bvrny/Vortex/SIM-VORTEX-01A/LM5013_12V_3.5A_AsyncBuck.pdf

## WEBENCH ® Design Report

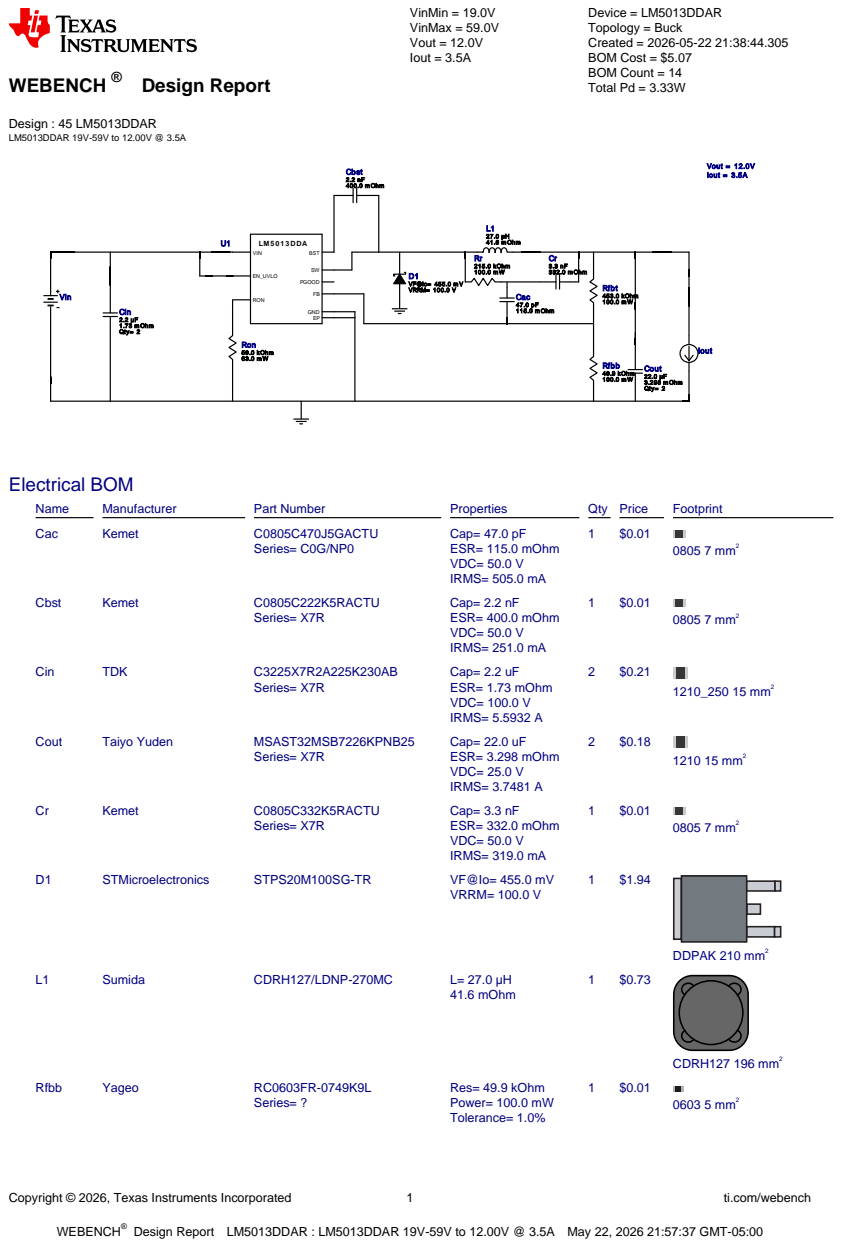
[picture p3: page 1]
Copyright © 2026, Texas Instruments Incorporated; ti.com/webench; WEBENCH®; Design : 45 LM5013DDAR LM5013DDAR 19V-59V to 12.00V @ 3.5A; VinMin = 19.0V VinMax = 59.0V Vout = 12.0V Iout = 3.5A; Device = LM5013DDAR Topology = Buck Created = 2026-05-22 21:38:44.305 BOM Cost = $5.07 BOM Count = 14 Total Pd = 3.33W; LM 5 0 1 3 DDA; GND; VIN; EN_UVLO; RON; PGOOD; BST; Cac 47.0 pF 115.0 m Ohm; Rr 215.0 kOhm 100.0 m W; Cr 3.3 nF 332.0 m Ohm; Cout 22.0 µF 3.298 m Ohm Qty= 2; L1 27.0 µH 41.6 m Ohm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

Design Report LM5013DDAR : LM5013DDAR 19V-59V to 12.00V @ 3.5A May 22, 2026 21:57:37 GMT-05:00

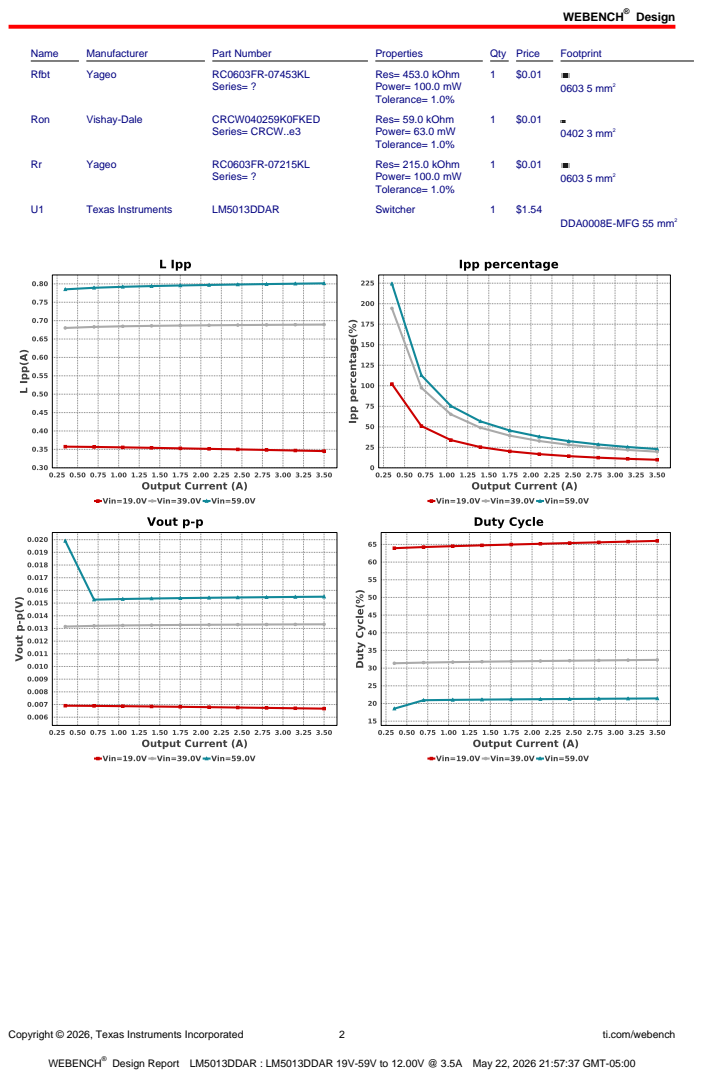
[picture p4: page 2]
Design; Copyright © 2026, Texas Instruments Incorporated; ti.com/webench; Name; Manufacturer; Part Number; Properties; Qty Price; Footprint; Rfbt; Yageo; Series= ?; Res= 453.0 kOhm Power= 100.0 mW Tolerance= 1.0%; 0603 5 mm²; Ron; Vishay-Dale; CRCW040259K0FKED; Series= CRCW..e3; Res= 59.0 kOhm Power= 63.0 mW Tolerance= 1.0%; 0402 3 mm²; Res= 215.0 kOhm Power= 100.0 mW Tolerance= 1.0%; Texas Instruments; LM5013DDAR; Switcher; DDA0008E-MFG 55 mm²

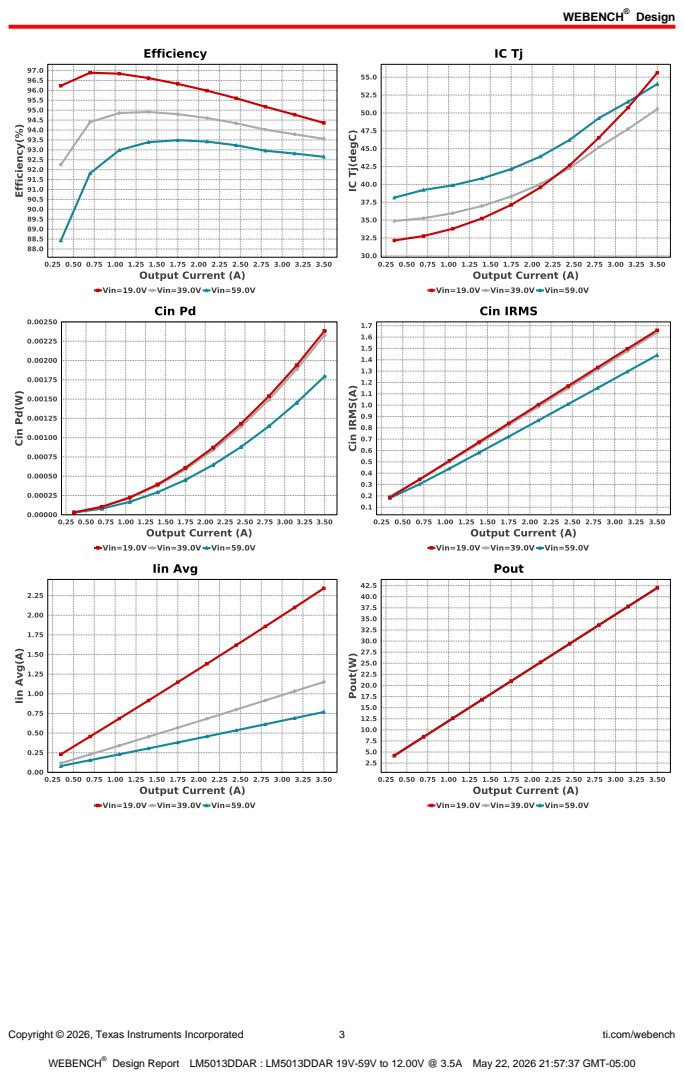
[picture p5: page 3]
Copyright © 2026, Texas Instruments Incorporated; ti.com/webench

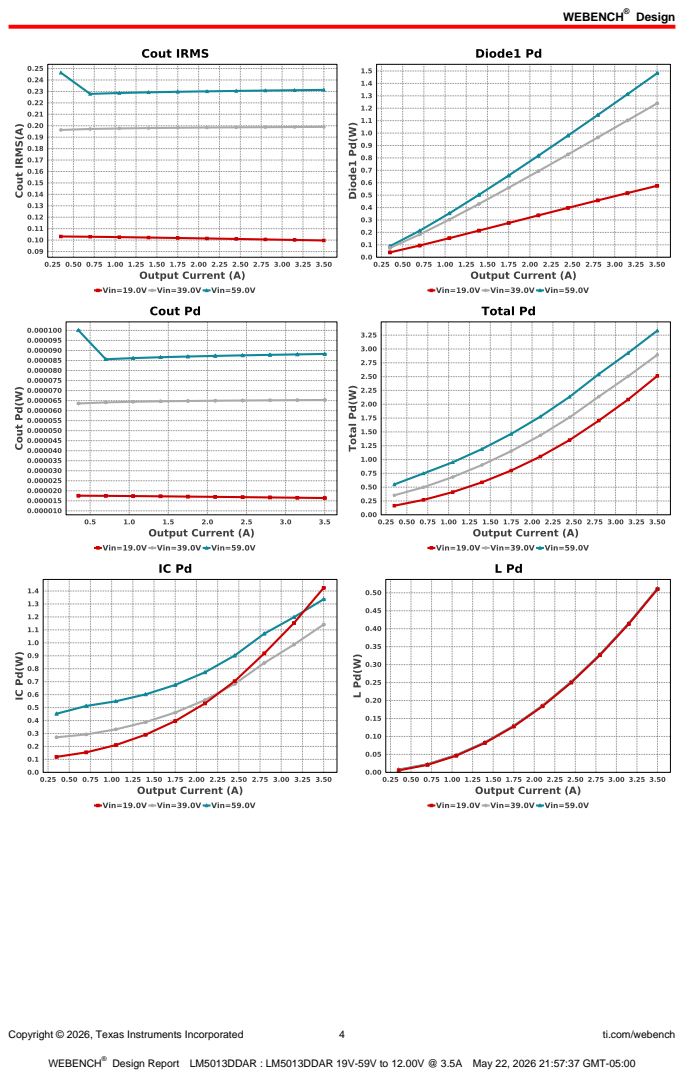
[picture p6: page 4]
Copyright © 2026, Texas Instruments Incorporated; ti.com/webench

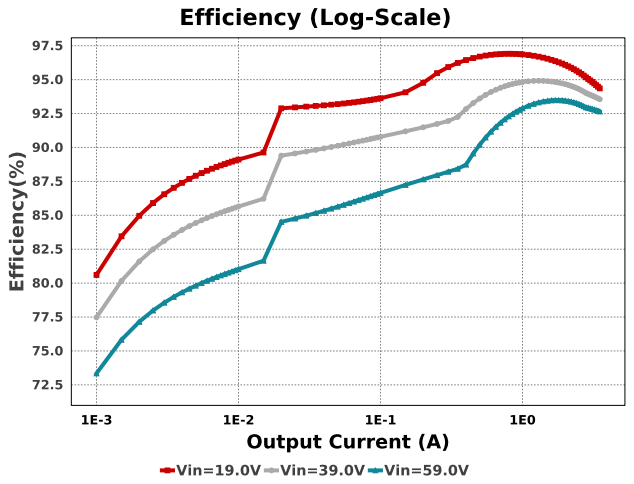
[picture p7: figure]

Copyright © 2026, Texas Instruments Incorporated | 5 | ti.com/webench

## Operating Values

# | Name | Value | Category | Description

1. BOM Count | 14 | Total Design BOM count
2. Total BOM | $5.066 | Total BOM Cost
3. Cin IRMS | 1.44 A | Capacitor | Input capacitor RMS ripple current
4. Cin Pd | 1.794 mW | Capacitor | Input capacitor power dissipation
5. Cout IRMS | 231.352 mA | Capacitor | Output capacitor RMS ripple current
6. Cout Pd | 88.26 µW | Capacitor | Output capacitor power dissipation
7. Diode1 Pd | 1.482 W | Diode | Diode1 power dissipation
8. IC Pd | 1.336 W | IC | IC power dissipation
9. IC Tj | 54.055 degC | IC | IC junction temperature
10. IC Tolerance | 19.0 mV | IC | IC Feedback Tolerance
11. ICThetaJA | 18.0 degC/W | IC | IC junction-to-ambient thermal resistance
12. Iin Avg | 768.34 mA | IC | Average input current
13. Ipp percentage | 22.898 % | Inductor | Inductor ripple current percentage (with respect to average inductor
| | | | current)
14. L Ipp | 801.425 mA | Inductor | Peak-to-peak inductor ripple current
15. L Pd | 511.83 mW | Inductor | Inductor power dissipation
16. Cin Pd | 1.794 mW | Power | Input capacitor power dissipation
17. Cout Pd | 88.26 µW | Power | Output capacitor power dissipation
18. Diode1 Pd | 1.482 W | Power | Diode1 power dissipation
19. IC Pd | 1.336 W | Power | IC power dissipation
20. L Pd | 511.83 mW | Power | Inductor power dissipation
21. Total Pd | 3.332 W | Power | Total Power Dissipation
22. Duty Cycle | 21.43 % | System
| | | Information | Duty cycle
23. Efficiency | 92.65 % | System
| | | Information | Steady state efficiency
24. FootPrint | 557.0 mm² | System
| | | Information | Total Foot Print Area of BOM components
25. Frequency | 460.575 kHz | System
| | | Information | Switching frequency
26. Iout | 3.5 A | System
| | | Information | Iout operating point
27. Mode | CCM | System
| | | Information | Conduction Mode
28. Pout | 42.0 W | System
| | | Information | Total output power
29. Vin | 59.0 V | System
| | | Information | Vin operating point
30. Vout | 12.0 V | System
| | | Information | Operational Output Voltage
31. Vout Actual | 12.094 V | System
| | | Information | Vout Actual calculated based on selected voltage divider resistors
32. Vout Tolerance | 3.432 % | System
| | | Information | Vout Tolerance based on IC Tolerance (no load) and voltage divider resistors if applicable
33. Vout p-p | 15.503 mV | System
| | | Information | Peak-to-peak output ripple voltage

## Design Inputs

Name | Value | Description
Iout | 3.5 | Maximum Output Current
VinMax | 59.0 | Maximum input voltage

Copyright © 2026, Texas Instruments Incorporated | 6 | ti.com/webench
Name | Value | Description
VinMin | 19.0 | Minimum input voltage
Vout | 12.0 | Output Voltage
base_pn | LM5013 | Base Product Number
source | DC | Input Source Type
Ta | 30.0 | Ambient temperature
UserFsw | 500.0 k | Customer Selected Frequency


Copyright © 2026, Texas Instruments Incorporated | 7 | ti.com/webench

## Assembly

## Component Testing

Some published data on components in datasheets such as Capacitor ESR and Inductor DC resistance is based on conservative values that will guarantee that the components always exceed the specification. For design purposes it is usually better to work with typical values. Since this data is not always available it is a good practice to measure the Capacitance and ESR values of Cin and Cout, and the inductance and DC resistance of L1 before assembly of the board. Any large discrepancies in values should be electrically simulated in WEBENCH to check for instabilities and thermally simulated in WebTHERM to make sure critical temperatures are not exceeded.

## Soldering Component to Board

If board assembly is done in house it is best to tack down one terminal of a component on the board then solder the other terminal. For surface mount parts with large tabs, such as the DPAK, the tab on the back of the package should be pre-tinned with solder, then tacked into place by one of the pins. To solder the tab town to the board place the iron down on the board while resting against the tab, heating both surfaces simultaneously. Apply light pressure to the top of the plastic case until the solder flows around the part and the part is flush with the PCB. If the solder is not flowing around the board you may need a higher wattage iron (generally 25W to 30W is enough).

## Initial Startup of Circuit

It is best to initially power up the board by setting the input supply voltage to the lowest operating input voltage 19.0V and set the input supply's current limit to zero. With the input supply off connect up the input supply to Vin and GND. Connect a digital volt meter and a load if needed to set the minimum Iout of the design from Vout and GND. Turn on the input supply and slowly turn up the current limit on the input supply.
If the voltage starts to rise on the input supply continue increasing the input supply current limit while watching the output voltage. If the current increases on the input supply, but the voltage remains near zero, then there may be a short or a component misplaced on the board. Power down the board and visually inspect for solder bridges and recheck the diode and capacitor polarities. Once the power supply circuit is operational then more extensive testing may include full load testing, transient load and line tests to compare with simulation results.

## Load Testing

The setup is the same as the initial startup, except that an additional digital voltmeter is connected between Vin and GND, a load is connected between Vout and GND and a current meter is connected in series between Vout and the load. The load must be able to handle at least rated output power + 50% ( 7.5 watts for this design). Ideally the load is supplied in the form of a variable load test unit. It can also be done in the form of suitably large power resistors. When using an oscilloscope to measure waveforms on the prototype board, the ground leads of the oscilloscope probes should be as short as possible and the area of the loop formed by the ground lead should be kept to a minimum. This will help reduce ground lead inductance and eliminate EMI noise that is not actually present in the circuit.

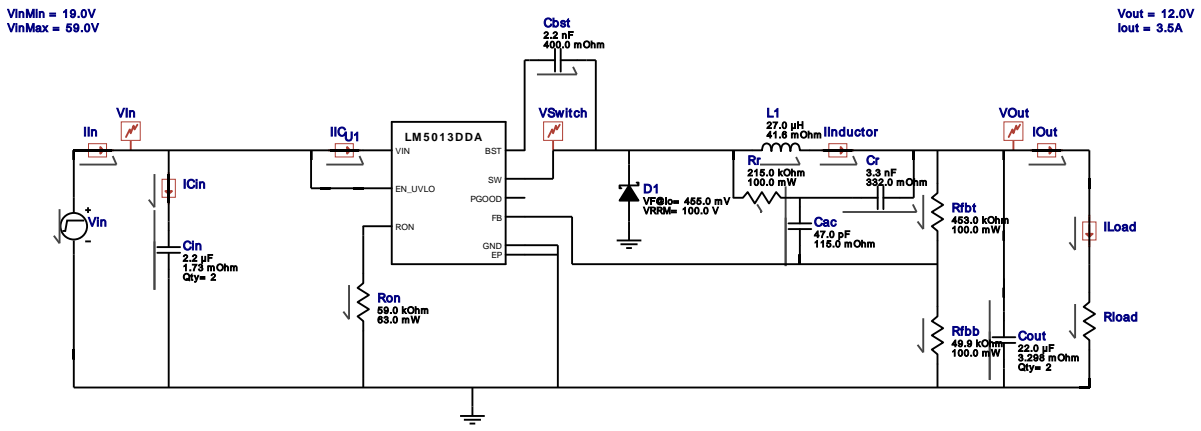
[picture p9: figure]
IOut LM 5 0 1 3 DDA; GND; VIN; EN_UVLO; RON; PGOOD; BST; Cac 47.0 pF 115.0 m Ohm; Rr 215.0 kOhm 100.0 m W; Cr 3.3 nF 332.0 m Ohm; VSwitch; Cout 22.0 µF 3.298 m Ohm Qty= 2; 27.0 µH IIn; 41.6 m Ohm; Vout = 12.0V Iout = 3.5A; VOut; D1 VF@Io= 455.0 m V VRRM= 100.0 V; IIC; IInductor; Ron 59.0 kOhm 63.0 m W; Rfbt 453.0 kOhm 100.0 m W; VinMin = 19.0V VinMax = 59.0V; VIn; Rfbb 49.9 kOhm 100.0 m W; Cbst 2.2 nF 400.0 m Ohm; ICin; Cin 2.2 µF 1.73 m Ohm Qty= 2; ILoad; Rload; Vin

Copyright © 2026, Texas Instruments Incorporated | 8 | ti.com/webench

## WEBENCH® Electrical Simulation Report

Design Id = 45
sim_id = 5
Simulation Type = Startup

## Simulation Parameters

# Name Parameter Name | Description | Values

1. Rload R | Load Resistance | 3.4285714285714284 ohm

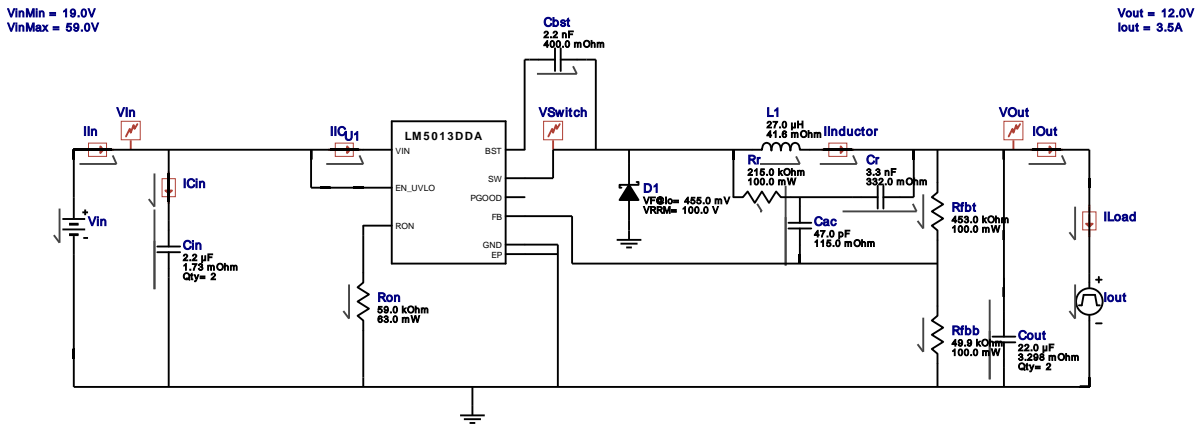
[picture p10: figure]
IOut LM 5 0 1 3 DDA; GND; VIN; EN_UVLO; RON; PGOOD; BST; Cac 47.0 pF 115.0 m Ohm; Rr 215.0 kOhm 100.0 m W; Cr 3.3 nF 332.0 m Ohm; VSwitch; Cout 22.0 µF 3.298 m Ohm Qty= 2; 27.0 µH IIn; 41.6 m Ohm; Vout = 12.0V Iout = 3.5A; VOut; D1 VF@Io= 455.0 m V VRRM= 100.0 V; IIC; IInductor; Ron 59.0 kOhm 63.0 m W; Rfbt 453.0 kOhm 100.0 m W; VinMin = 19.0V VinMax = 59.0V; VIn; Rfbb 49.9 kOhm 100.0 m W; Cbst 2.2 nF 400.0 m Ohm; ICin; Cin 2.2 µF 1.73 m Ohm Qty= 2; ILoad; Iout; Vin

Copyright © 2026, Texas Instruments Incorporated | 9 | ti.com/webench

Design Id = 45
sim_id = 6
Simulation Type = Load Transient

## Simulation Parameters

# Name Parameter Name | Description | Values

1. Iout | signal_type | Signal Type | PULSE
| I1 | Initial Load Current | 3.5 A
| I2 | Minimum Load Current | 0.35 A
| Td | Initial Time Delay | 200u s
| Tf | Fall Time | 10u s
| Tr | Rise Time | 10u s
| Pw | Pulse Width | 500u s

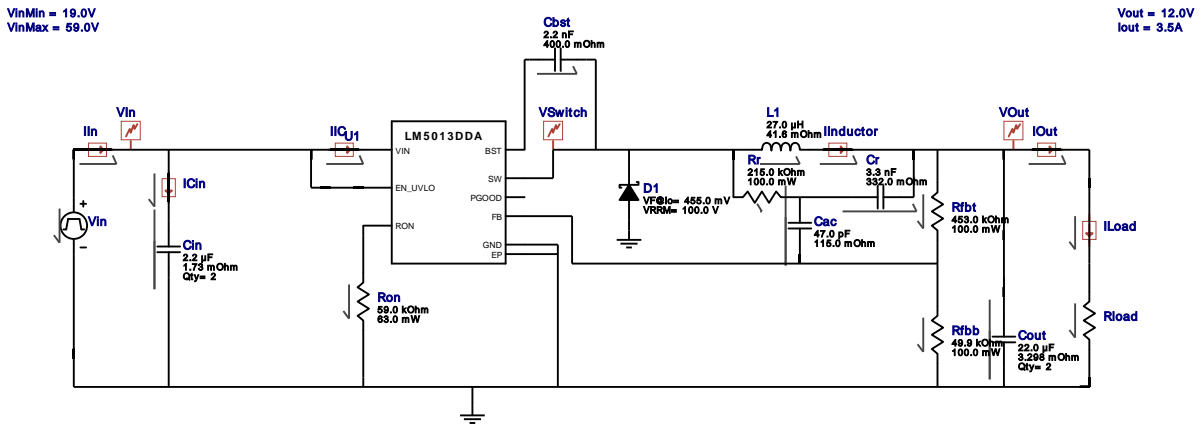
[picture p11: figure]
IOut LM 5 0 1 3 DDA; GND; VIN; EN_UVLO; RON; PGOOD; BST; Cac 47.0 pF 115.0 m Ohm; Rr 215.0 kOhm 100.0 m W; Cr 3.3 nF 332.0 m Ohm; VSwitch; Cout 22.0 µF 3.298 m Ohm Qty= 2; 27.0 µH IIn; 41.6 m Ohm; Vout = 12.0V Iout = 3.5A; VOut; D1 VF@Io= 455.0 m V VRRM= 100.0 V; IIC; IInductor; Ron 59.0 kOhm 63.0 m W; Rfbt 453.0 kOhm 100.0 m W; VinMin = 19.0V VinMax = 59.0V; VIn; Rfbb 49.9 kOhm 100.0 m W; Cbst 2.2 nF 400.0 m Ohm; ICin; Cin 2.2 µF 1.73 m Ohm Qty= 2; ILoad; Rload; Vin

Copyright © 2026, Texas Instruments Incorporated | 10 | ti.com/webench

Design Id = 45
sim_id = 7
Simulation Type = Input Transient

## Simulation Parameters

# Name Parameter Name | Description | Values

1. Rload R | Load Resistance | 3.4285714285714284 ohm

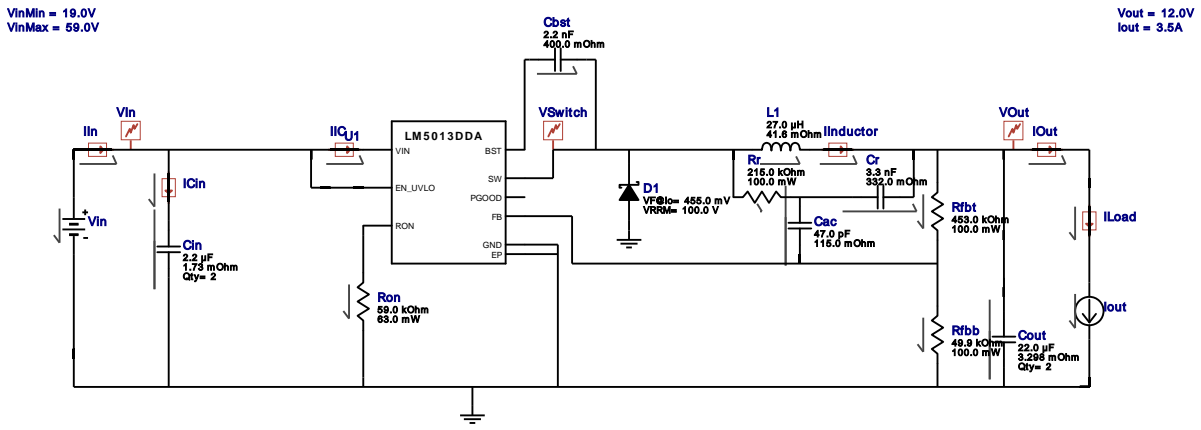
[picture p12: figure]
IOut LM 5 0 1 3 DDA; GND; VIN; EN_UVLO; RON; PGOOD; BST; Cac 47.0 pF 115.0 m Ohm; Rr 215.0 kOhm 100.0 m W; Cr 3.3 nF 332.0 m Ohm; VSwitch; Cout 22.0 µF 3.298 m Ohm Qty= 2; 27.0 µH IIn; 41.6 m Ohm; Vout = 12.0V Iout = 3.5A; VOut; D1 VF@Io= 455.0 m V VRRM= 100.0 V; IIC; IInductor; Ron 59.0 kOhm 63.0 m W; Rfbt 453.0 kOhm 100.0 m W; VinMin = 19.0V VinMax = 59.0V; VIn; Rfbb 49.9 kOhm 100.0 m W; Cbst 2.2 nF 400.0 m Ohm; ICin; Cin 2.2 µF 1.73 m Ohm Qty= 2; ILoad; Iout; Vin

Copyright © 2026, Texas Instruments Incorporated | 11 | ti.com/webench

Design Id = 45
sim_id = 8
Simulation Type = Steady State

## Simulation Parameters

# Name Parameter Name | Description | Values

1. Iout | I | Load current | 3.5 A

## Design Assistance

1. Master key : 570D1EC6A0589950192A1BDB29CCB0EA[v1]
2. LM5013 Product Folder : http://www.ti.com/product/LM5013 : contains the data sheet and other resources.

Important Notice and Disclaimer

TI provides technical and reliability data (including datasheets), design resources (including reference designs), application or other design advice, web tools, safety information, and other resources AS IS and with all faults, and disclaims all warranties. These resources are intended for skilled developers designing with TI products. You are solely responsible for (1) selecting the appropriate TI products for your application, (2) designing, validating and testing your application, and (3) ensuring your application meets applicable standards, and any other safety, security, or other requirements.

These resources are subject to change without notice. TI grants you permission to use these resources only for development of an application that uses the TI products described in the resource. Other reproduction and display of these resources is prohibited. No license is granted to any other TI intellectual property right or to any third party intellectual property right. TI disclaims responsibility for, and you will fully indemnify TI and its representatives against, any claims, damages, costs, losses, and liabilities arising out of your use of these resources.

Providing these resources does not expand or otherwise alter TI's applicable Terms of Sale or other applicable terms available either on ti.com or provided in conjunction with TI products.
