bvrny/Vortex/DOCS-VORTEX-01A/Bldc_inverter_combined_mk/BLDC_inverter_combined_MK.pdf

ИЗВЕШТАЈ ЗА ДИЗАЈН НА ТРИФАЗЕН BLDC/PMSM ИНВЕРТОР | 1

# Дизајн на трифазен инвертор со N-канални MOSFET транзистори за BLDC/PMSM мотор од 3–5 kW, напојуван од 24-V/48-V батерии (20–60 V): енергетски степен, управување на гејтот и аналоген влезен степен со векторско управување (FOC)

Извештај за хардверски дизајн
Целен контролер: STMicroelectronics STM32G473RCT6 | Енергетски степен: Infineon IPT015N10N5 (100 V, 1.5 mΩ), ×2
паралелно по позиција | Драјвер: Texas Instruments UCC27211A-Q1
Склопна фреквенција 40 kHz | Управување на гејтот: 12 V | Струен засилувач: TI INA240A2 | Набавка: LCSC
| Electronics
I. Вовед и опсег
Ц

елниот систем е неизолиран трифазен напонски инвертор со заедничко заземјување (common-ground), наменет да управува со произволен трифазен безчеткест еднонасочен или синхрон мотор со перманентни магнети (BLDC/PMSM), под сензорско управување (Hall или квадратурен енкодер) или безсензорско, базирано на повратна електромоторна сила (back-EMF), со целосно векторско управување (FOC). Системот се напојува од батерија со променлив напон: пакет од 24 V (опсег 20–30 V), кој дава околу 3 kW, или пакет од 48 V (опсег 40–60 V), кој дава до 5 kW. Промената на напонот на батеријата е суштинска за дизајнот: највисокиот напон (60 V) ги одредува напрезите на блокирање и брзината на нишање dv/dt, додека најнискиот напон (20 V) ја дава најголемата струја за дадена моќност и оттаму најлошиот случај и за спроводните загуби и за мерењето на струја. Склопната фреквенција е 40 kHz, над границата на човечкиот слух, така што PWM тонот е нечуен. Контролерот е STM32G473RCT6 — motor-control MCU базиран на Arm® Cortex®-M4, кој интегрира пет 12-битни ADC-а, шест операционни засилувачи употребливи во режим со програмабилно засилување (PGA) или како follower, седум аналогни компаратори, три напредни тајмери за управување со мотор и бафер за напонска референца (VREFBUF) [1]. Секоја прекинувачка позиција во енергетскиот степен е составена од два паралелно поврзани Infineon OptiMOS™ 5 IPT015N10N5 транзистори (100 V, 1.5 mΩ, 300 A) [3], [4] — четири уреди по гранка на полумостот, дванаесет вкупно — а секоја гранка ја управува по еден gate driver Texas Instruments UCC27211A-Q1, напојуван од 12 V [2]. Фазната струја се мери со in-line shunt, читан од струен засилувач TI INA240A2 [18].
Извештајот го опфаќа целиот хардверски синџир од батеријата до ADC-то на контролерот и е организиран во следните проектни блокови:
1) избор на енергетскиот MOSFET и проверка на електричната компатибилност со драјверот за целиот опсег на напони на батеријата (Дел IV);
2) колото за управување на гејтот — bootstrap кондензатор и диода, отпорници на гејтот, асиметрична мрежа за вклучување/исклучување, pull-down отпорници и кондензатори за декуплирање (Дел V);
3) ланецот за мерење на фазна струја (in-line shunt + засилувач + ADC интерфејс), за сите три фази (Дел VI);
4) ланците за мерење на напон на DC-сабирницата и на секој од трите фазни јазли (Дел VII);
5) RC snubber паралелно со енергетските прекинувачи (Дел VIII); и
6) стратегијата за шум и филтрирање (Дел IX), консолидирана со целосна спецификација на материјали (Дел X).
За секој блок извештајот (а) го објаснува принципот на работа и потребните компоненти, (б) ги изведува управувачките равенки, (в) пресметува нумерички вредности за тековната спецификација, (г) избира конкретна компонента достапна од дистрибутер и (д) го оправдува изборот. Поглавјето со теоријата на работата (Дел II) ги поставува концептуалните основи — зошто е потребен инвертор за безчеткеста машина, како работат полумостот и bootstrap напојувањето и која е улогата на Miller plateau-то — пред да се премине на пресметките на ниво на компоненти. Две посебни прашања се обработени детално: споредбата на топологиите за мерење на струја што го мотивира in-line изборот (Дел VI-A), и потребата (или непотребата) од op-amp бафер пред ADC (Дел VII-C).
Секоја квантитативна тврдба и секоја проектна равенка е поткрепена со примарен извор — каталошки лист на производителот или призната апликативна белешка — со активни линкови. Дополнително, секоја избрана компонента мора да биде нарачлива од дистрибутерот LCSC Electronics, при што се претпочитаат компоненти со голем обрт за да биде реална нарачка со количини од 500+; LCSC држи на залиха повеќе од 560 000 SKU од 2600+ производители [24]. Бидејќи залихата кај дистрибутерот се менува секојдневно, спецификацијата на материјали во Дел X ја означува единствената специјална компонента (shunt-от со голема моќност) за потврда на залиха при пуштање на нарачката и нуди алтернатива составена од крајно вообичаени компоненти.

II. Теорија на работата
A. Зошто се користи инвертор за погон на BLDC мотор
Безчеткестиот еднонасочен мотор е, и покрај своето име, синхрона машина за наизменична струја: има ротор со траен магнет и трифазна статорска намотка и нема механички комутатор и четки преку кои конвенционалниот еднонасочен мотор ја префрла струјата меѓу намотките додека роторот се врти [5], [6]. Функцијата на комутација што кај четкастиот мотор ја вршат четките механички затоа мора да се изврши електронски. Инверторот е токму колото што го прави тоа: го претвора еднонасочниот напон на сабирницата со фиксен поларитет (овде обезбеден од батерија) во низа контролирани наизменични фазни струи потребни за да се одржи статорското магнетно поле во вртење пред роторот и со тоа да се произведува континуиран вртежен момент [5], [6].
Во трапезоидното (шестчекорно, 120°) управување — најчестата BLDC шема — шесте прекинувачи на инверторот заземаат шест комбинации на вклучено/исклучено, произведувајќи шест дискретни ориентации на статорското поле по електрична револуција; прекинувачите се чекорат низ оваа низа синхроно со роторот, така што вртежниот момент е секогаш позитивен [5]. Положбата на роторот — потребна за да се знае кога да се чекори — се добива или од Hall сензори поставени на 120°, или, безсензорски, од back-EMF (контраелектромоторната сила) на моментно неенергизираната фаза [5], [6]. Во секој момент една фаза се управува позитивно, една негативно, а трета се остава отворена, совпаѓајќи ја правоаголната струја со трапезоидната back-EMF на моторот за ефикасно производство на момент [5]. PWM применет на спроводните прекинувачи го поставува ефективниот напон, а со тоа и работната точка по брзина и момент [6]. Без инвертор нема начин да се комутира безчеткеста машина — токму затоа енергетската електроника, а не четките, го дефинира погонот.
B. Како работи инверторското коло
Енергетскиот степен е трифазен мост: три идентични „гранки“ (полумостови), по една за секоја фаза на моторот, секоја составена од high-side и low-side прекинувач поврзани во серија преку еднонасочната сабирница, со фазата на моторот приклучена на нивната средна точка. Во овој дизајн секој прекинувач е составен од два паралелно поврзани IPT015N10N5 транзистори, па една гранка содржи четири MOSFET-а, а целиот мост дванаесет.
Во рамките на една гранка двата прекинувачи работат комплементарно — никогаш и двата истовремено вклучени, што би ја кратко споило сабирницата (shoot-through). Вклучувањето на high-side прекинувачот ја поврзува фазата со позитивната сабирница; вклучувањето на low-side прекинувачот ја поврзува со масата; оставањето на двата исклучени ѝ дозволува на фазата да лебди (што се користи за неенергизираната фаза и за следење на back-EMF) [5], [6]. Чекорењето на трите гранки низ шестчекорната шема ја циркулира струјата низ парови фази по редоследот што произведува ротирачко статорско поле [5]. За време на dead-time-от меѓу состојбите на прекинувачите, телесните диоди (body diode) на MOSFET-ите — заедно со индуктивноста на моторот — ја обезбедуваат freewheeling патеката за индуктивната фазна струја; телесната диода на

IPT015N10N5 е карактеризирана токму за оваа намена (VSD ≈ 0.85 V, Qrr ≈ 316 nC) [3]. Отпорничкиот карактер на спроводната состојба на MOSFET-от (RDS(on) од само 1.5 mΩ, дополнително преполовена со паралелното поврзување) ги држи спроводните загуби ниски при струите од редот на 100 A [3], [7].

C. Намена на секоја компонента
- Енергетски MOSFET-и (IPT015N10N5, ×2 по позиција): контролираните прекинувачи што ја поврзуваат секоја фаза со сабирниците. Двата паралелно поврзани уреди ја преполовуваат ефективната отпорност во спроводна состојба и ги делат загубата и топлината; нивниот позитивен температурен коефициент на RDS(on)

го прави делењето самостабилизирачко [7].
- Gate driver (UCC27211A-Q1): ја претвора PWM логиката на контролерот во високострујното 12 V управување на гејтот потребно за брзо прекинување на MOSFET-ите, го поместува нивото на high-side сигналот до лебдечкиот јазол на прекинување и спроведува UVLO заштита [2]. Драјверите постојат токму затоа што логичкиот излез (често 3.3 V, ≤ 1 A) не може ниту целосно да спроведе енергетски MOSFET, ниту да ја испорача врвната струја за брзо прекинување, и затоа што гејтот на high-side уредот мора да биде референциран кон јазол што се ниша до напонот на сабирницата [2], [7].
- Bootstrap кондензатор: лебдечкиот резервоар на енергија што го напојува high-side драјверот додека јазолот на прекинување е висок (в. Дел II-D).
- Bootstrap диода (внатрешна): еднонасочен вентил што го надополнува bootstrap кондензаторот од VDD кога јазолот на прекинување е низок и го блокира напонот на сабирницата кога е висок [2], [8].
- Отпорници на гејтот: ја поставуваат и ограничуваат струјата на гејтот, го наштелуваат dv/dt заради EMI и ги пригушуваат и балансираат паралелните гејтови [7].
- Pull-down отпорници гејт–извор: ги држат MOSFET-ите исклучени при вклучување на напојувањето и додаваат имунитет на вклучување од dv/dt [7].
- Кондензатори за декуплирање: ги напојуваат брзите струјни импулси на гејтот локално, така што 12 V сабирницата и преднапонот на драјверот не се рушат при прекинување [2].
- Капацитивност на DC-link: ја вкрутува сабирницата против големата бранувачка струја на полумостот и го ограничува надскокот при комутација во рамки на оценката од 100 V на уредот.
D. Bootstrap колото: работа, потреба и улогата на Miller plateau
a) Зошто полумост само со N-канални транзистори бара bootstrap напојување.: N-каналните MOSFET-и се претпочитаат за полумостот бидејќи, за дадена површина на чипот и напон, имаат многу пониска RDS(on) од P-каналните уреди. Но N-канален MOSFET се вклучува само кога неговиот гејт е неколку волти над неговиот извор. Кај low-side уредот изворот е на маса, па 12 V управување референцирано кон маса работи директно. Кај high-side уредот изворот е јазолот на прекинување, кој се крева до полниот напон на сабирницата кога тој уред е вклучен; за да остане вклучен, гејтот мора да се управува ≈ 12 V над сабирницата — напон што не постои никаде во систем со една сабирница [2], [7]. Bootstrap колото го создава ова лебдечко high-side напојување евтино, користејќи само диода и кондензатор [8].
b) Како работи.: Кога low-side прекинувачот е вклучен, јазолот на прекинување (и пинот HS) се влече кон маса; bootstrap кондензаторот, поврзан меѓу HB и HS, се полни од 12 V сабирницата VDD низ bootstrap диодата до ≈ VDD − VF ≈ 11 V [2], [8]. Кога потоа high-side-от се вклучува, јазолот на прекинување се крева до напонот на сабирницата; bootstrap диодата станува обратно поларизирана (го блокира напонот на сабирницата), а наполнетиот кондензатор „се вози нагоре“ заедно со јазолот на прекинување, држејќи го пинот HB ≈ 11 V над HS и така обезбедувајќи го лебдечкиот преднапон што го држи high-side MOSFET-от целосно спроводен [2], [8]. Кондензаторот повторно се дополнува во секој циклус кога low-side-от следно се вклучува — поради што е потребно минимално време на спроводност на low-side-от (освежување) и поради што Дел V-A мораше да ги провери и опаѓањето и полнењето [8], [9].
c) Каде влегува Miller plateau.: За време на секое вклучување напонот на гејтот расте, паузира на рамното „Miller plateau“ (≈ 4.4 V овде [3]), потоа повторно расте. Паузата настанува бидејќи, штом каналот ја носи полната струја на оптоварување, целата струја за управување на гејтот се пренасочува во празнење на капацитивноста гејт–одвод CGD, така што напонот на одводот може да се ниша; во текот на овој интервал VGS е стегнат и се движи само напонот на одводот [7]. Интервалот на платото (заедно со интервалот од прагот

ТАБЕЛА I
Зададени параметри на дизајнот.
Параметар | Вредност | Образложение / извор
Извор на напојување | Батерии (24 V или 48 V
| пакет) | Напонот варира со состојбата на полнење на батеријата
Напон на DC- сабирницата (DC-link) | 24 V пакет: 20–30 V
| 48 V пакет: 40–60 V | Vbus,max = 60 V (полна 48 V батерија), Vbus,min = 20 V (празна
| | 24 V батерија)
Излезна моќност | ≈ 3 kW (24 V пакет) /
| ≈ 5 kW (48 V пакет) | При номинален напон
Склопна фреквенција, fSW | 40 kHz | Над границата на човечкиот слух (∼ 20 kHz), па PWM тонот е
| | нечуен
Прекинувачки уред | IPT015N10N5, ×2
| паралелно по позиција | 100 V, 1.5 mΩ OptiMOS™ 5, оптимизиран за апликации со голема
| | струја [3], [4]
Gate driver | UCC27211A-Q1, ×1 по
| фаза | 120 V boot, 3.7 A/4.5 A полумостен драјвер со вградена boot
| | диода [2], [10]
Напон за управување на гејтот, VDD | 12 V | Во работниот опсег 8–17 V на уредот [2]

до платото) е токму прозорецот во кој уредот истовремено издржува висок напон и носи висока струја, па тоа е местото каде што се генерира загубата при прекинување [7]. Miller полнежот Qgd што мора да се протурка низ платото е удвоен со паралелното поврзување (овде ≈ 102 nC во најлош случај), а брзината на напонската транзиција ја поставува тоа колку струја драјверот може да втисне во гејтот на нивото на платото — а не неговата врвна струја при полн VDD [7].
d) Зошто се потребни големи изворни и понорни струи.: Анализата на Balogh го истакнува тоа експлицитно: најважната карактеристика на еден gate driver е неговата способност за извор и понор околу напонот на Miller plateau-то (∼ 5 V), бидејќи таа струја одредува колку брзо се одвива напонската транзиција на одводот и оттаму загубата при прекинување [7]. Голема изворна струја (3.7 A) брзо го управува гејтот низ платото при вклучување, рушејќи го VDS за ≈ 28 ns (Дел V-C) и минимизирајќи ја загубата при вклучување [2], [7]. Голема понорна струја (4.5 A) го прави истото при исклучување и, што е клучно, го држи гејтот на исклучениот уред цврсто на маса додека спротивниот прекинувач го ниша споделениот јазол: силниот понор ја надвладува Miller струјата инјектирана низ CGD, спречувајќи dv/dt-индуцирано (Miller) вклучување и резултирачкиот shoot-through [2], [7]. Со два паралелни MOSFET-и со висок Qg по позиција, токму оваа висока струјна способност прави еден канал на драјверот да биде доволен — и затоа TI ја пласира струјата на уредот специфично за „управување на големи енергетски MOSFET-и … низ Miller plateau-то“ [2].

III. Спецификација на дизајнот и работен опсег Зададените параметри на дизајнот се сумирани во Табела I. Хардверот за енергетскиот степен мора да биде димензиониран за најголемата струја што инверторот може да ја носи; истата струја ги одредува вредноста на shunt-от и засилувањето на струјниот засилувач. Бидејќи моторот се напојува од батерија со променлив напон, струите за најлош случај мора да се проценат при најнискиот напон на пакетот, зашто за дадена моќност струјата расте кога напонот опаѓа (I = P/V ).

A. Струја на сабирницата за најлош случај (термичко димензионирање)
Конзервативна граница се добива ако се претпостави дека конверторот сè уште бара номинална моќност и при празна батерија:
- пакет 24 V (празен, 20 V), 3 kW → Ibus,max = 3000/20 = 150 A;
- пакет 48 V (празен, 40 V), 5 kW → Ibus,max = 5000/40 = 125 A.
Меродавната струја за термичко димензионирање затоа е ≈ 150 A (24 V пакет при празна батерија); за споредба, при номинален напон струите се 5000/48 ≈ 104 A и 3000/24 ≈ 125 A. Бидејќи во секоја позиција се поврзани паралелно два уреди, секој MOSFET носи приближно половина од оваа струја, т.е. до ≈ 75 A во

ТАБЕЛА II
Работни точки и резултантна фазна струја од (2) (PF = 0.9).
Напојување / мотор | Vbus (V) | P (kW) Iph (A,rms) | ˆIph (A,врв)
24 V бат., 3 kW | 20 (мин) | 3 | 136.1 | 192.5
24 V бат., 3 kW | 30 (макс) | 3 | 90.7 | 128.3
48 V бат., 5 kW | 40 (мин) | 5 | 113.4 | 160.4
48 V бат., 5 kW | 60 (макс) | 5 | 75.6 | 106.9

најлош случај, што е далеку под континуираната оценка од 2 × 250 A (TC = 100 ◦C) на паралелниот пар [3]. Спроводната загуба по уред во овој најлош случај е P = I

2RDS(on) = 75² × 1.5 mΩ ≈ 8.4 W (моментно, при спроводност), што бара соодветно ладење.

B. Фазна струја за најлош случај (мерење на струја)
Електричната влезна моќност P е еднаква на излезната AC моќност на инверторот поделена со ефикасноста на конверторот η; земањето η → 1 е конзервативната претпоставка (што ја максимизира струјата). За синусоидно модулиран трифазен инвертор со просторно-векторска PWM (SVPWM), максималната амплитуда на основната хармоника на фазниот напон е Vˆ
| ph = Vbus/

√
3, па максималниот RMS фазен напон е

Vph,rms =

Vbus
√
6
. | (1)

Со три фази и фактор на моќност на поместување PF = cos φ, AC моќноста е P = 3 Vph,rms Iph PF. Со замена на (1) и решавање по RMS фазната струја,

Iph =

√
6
3

P

Vbus PF

≈ 0.816

P

Vbus PF

| (2)

која е најголема при минимален напон на сабирницата и минимален фактор на моќност. Равенката (2) ја дава струјата во номиналната работна точка; треба да се забележи дека мотор при ниска брзина и висок вртежен момент може да бара споредлива фазна струја при пониска моќност на сабирницата, па (2) се користи како термичка/континуирана проектна точка, а дополнителна резерва се остава за преодни и stall услови во опсегот на засилувачот (Дел VI-C).
Ограничувачката работна точка е 3 kW при 20 V: I

max

ph ≈ 136 A RMS, ˆI
max
ph ≈ 193 A врв (Табела II). Ова е под номиналната граница од 300 A за пакувањето на IPT015N10N5 [4], што потврдува дека енергетскиот степен е во согласност и со фазната струјна цел. Сите вредности за мерење на струја во Дел VI се однесуваат на оваа работна точка.

IV. Избор и компатибилност на енергетските компоненти
A. Infineon IPT015N10N5 — клучни параметри
IPT015N10N5 е N-канален OptiMOS™ 5 енергетски транзистор во TO-Leadless (PG-HSOF-8, „TOLL“) куќиште, кое Infineon експлицитно го опишува како идеално за прекинување со висока фреквенција и наменето за погони на лесни електрични возила, виљушкари и електрични алати [3], [4]. Параметрите релевантни за овој дизајн се сумирани во Табела III; сите вредности се од каталошкиот лист рев. 2.4, освен ако не е поинаку наведено [3].
Особина што директно го оправдува паралелното поврзување е позитивниот температурен коефициент на

RDS(on)

(околу +0.7 до +1 %/

◦C кај енергетските MOSFET-и): уред што спроведува поголема струја повеќе се загрева, неговата отпорност расте и струјата се прелева кон соседниот уред, така што паралелните MOSFET-и самостојно ги изедначуваат своите струи [7]. Ова е стандардната причина зошто MOSFET-ите — за разлика од биполарните транзистори — се добро прилагодени за паралелна работа [7].

ТАБЕЛА III
Клучни параметри на IPT015N10N5 [3].
Симбол Параметар | Вредност / забелешка
VDS | Напон одвод–извор | 100 V (апсолутен максимум)
RDS(on) | Отпорност во спроводна состојба (VGS = 10 V) | 1.3 mΩ тип. / 1.5 mΩ макс.
ID | Континуирана струја на одвод | 353 A (TC = 25 ◦C); 250 A (TC = 100 ◦C)
VGS(th) | Прагов напон на гејтот | 2.2 / 3.0 / 3.8 V (мин./тип./макс.)
Vplateau | Напон на Miller plateau | 4.4 V тип. (при ID = 100 A)
Ciss | Влезна капацитивност | 12 nF тип. / 16 nF макс.
Coss | Излезна капацитивност | 1.8 nF тип.
Crss | Преносна (reverse-transfer) капацитивност | 80 pF тип. / 140 pF макс.
RG | Внатрешна отпорност на гејтот | 1.4 Ω тип. / 2.1 Ω макс.
Qg | Вкупен полнеж на гејтот (0–10 V) | 169 nC тип. / 211 nC макс.
Qgs | Полнеж гејт–извор | 53 nC
Qgd | Полнеж гејт–одвод (Miller) | 34 nC тип. / 51 nC макс.
gf s | Трансконтуктанса | 140 S мин. / 280 S тип.
VSD | Напон на телесната диода (body diode) | 0.85 V тип. / 1.2 V макс.
VGS,max | Граничен напон гејт–извор | ±20 V

ТАБЕЛА IV
Клучни параметри на UCC27211A-Q1 [2].
Симбол | Параметар | Вредност
VDD | Напојување (работно / апс. макс.) | 8–17 V / 20 V
IO,source / IO,sink | Врвна излезна струја | 3.7 A / 4.5 A
VDDR | UVLO праг на VDD (растечки) | 7.0 V (хистереза 0.5 V)
VHBR | UVLO праг на high-side (HB–HS, растечки) | 6.7 V (хистереза 1.1 V)
VHB | Макс. напон на boot напојувањето | 120 V (HB–HS макс. 20 V)
VHS | Опсег на јазолот на прекинување | −(24 − VDD) V (−12 V при 12 V), до 105 V
| | (препорачано)
VF | Пад на напон на boot диодата | 0.85 V (@100 µA) / 1.05 V (@100 mA) макс.
RD | Динамичка отпорност на boot диодата | 0.55 Ω тип.
tPD | Доцнење на простирање (propagation delay) | 20 ns тип.
tR/tF | Време на пораст/опаѓање (1 nF) | 7.2 ns / 5.5 ns
IHB | Струја на мирување на boot | 0.12 mA макс.
SRHS | Макс. slew rate на HS | 50 V/ns
CHB | Препорачан опсег на boot кондензатор | 0.022–0.1 µF (зависно од полнежот на гејтот)
CV DD | Препорачано декуплирање на VDD | 0.22–4.7 µF
B. Texas Instruments UCC27211A-Q1 — клучни параметри
UCC27211A-Q1 е AEC-Q100 квалификуван 120 V high-side/low-side полумостен gate driver, дизајниран да управува два N-канални MOSFET-и со независни влезови; неговиот лебдечки high-side степен може да работи до 120 V, а 120 V bootstrap диода е интегрирана на чипот, така што надворешна boot диода не е задолжителна [2], [10]. Релевантните параметри, сите од каталошкиот лист SLUSCG0C, се дадени во Табела IV [2].
C. Внатрешна архитектура на UCC27211A-Q1
TI го дели уредот на пет функционални блока: влезни степени, UVLO заштита, поместување на ниво (level shift), boot диода и излезни драјверски степени [2].
- Влезни степени. Независни HI и LI влезови со ≈ 68 kΩ pull-down, ≈ 4 pF влезна капацитивност и TTL-компатибилни прагови (растечки 2.3 V, опаѓачки 1.6 V) со широка хистереза за имунитет на шум; влезовите поднесуваат −10 до +20 V и се независни од VDD, па прифаќаат и логика од микроконтролер и сигнали од аналоген контролер [2].
- UVLO заштита. Посебни монитори на VDD и на лебдечкото VHB − VHS напојување ги принудуваат излезите ниски додека преднапонот не е валиден. Прагот на VDD е 7 V (хистереза 0.5 V), а симетричниот high-side праг е 6.7 V (хистереза 1.1 V), така што high-side-от и low-side-от се исклучуваат заедно [2].
- Поместување на ниво (level shift). Ја преведува командата на high-side влезот, референцирана кон маса, нагоре до лебдечкиот high-side излезен степен референциран кон HS, со тесно (≈ 4 ns типично) усогласување на доцнењето меѓу каналите, за да се избегне временска нерамнотежа во полумостот [2].
- Boot диода. 120 V bootstrap диодата е интегрирана (анода VDD, катода HB), елиминирајќи надворешна диода и освежувајќи го CBOOT во секој циклус кога HS оди ниско [2].
- Излезни степени. Low-side степенот е референциран VDD → VSS, а high-side степенот VHB → VHS; двата обезбедуваат 3.7 A извор / 4.5 A понор со брзи (7.2 ns пораст / 5.5 ns опаѓање во 1 nF) излези со ниска импеданса и доцнење на простирање од 20 ns [2].
a) Проектни равенки од каталошкиот лист.: Дисипацијата на драјверот се дели на еднонасочен и прекинувачки дел [2]:
PDISS = PDC + PSW , | PDC = IQ × VDD, | (3)

со IQ < 0.17 mA, па PDC е занемарлив [2]. Прекинувачкиот дел се изведува од енергијата за полнење на гејтот, претставена како еквивалентен кондензатор [2]:

EG =

1
2 CLOAD V

2
DD, | PG = CLOAD V
| 2
| DD fSW = QG VDD fSW , | (4)

каде што гејтот на MOSFET-от е претставен преку неговиот полнеж низ QG = CLOAD VDD [2]. Половина од PG се дисипира при вклучување, а половина при исклучување; со надворешни отпорници на гејтот оваа загуба се дели меѓу драјверот и отпорниците [2]. Истиот израз се појавува кај Balogh како загуба за управување на гејтот, PGAT E = VDRV QG fDRV , чиј член QGfDRV е просечната струја на преднапон на гејтот [7]. За овој дизајн, моќноста за управување на гејтот по драјвер (двата прекинувачи на една гранка, 12 V, 40 kHz, ≈ 465 nC секој) е приближно

PG ≈ 2 × Qg,поз VDD fSW = 2 × 465 nC × 12 V × 40 kHz ≈ 0.45 W по драјвер, | (5)

поделена меѓу драјверот и осумте отпорници на гејтот на гранката — удобно во рамки на дисипацијата на SO-PowerPAD куќиштето кога е изведено според упатствата на TI (драјвер близу MOSFET-ите, декуплирање директно кај пиновите, тесни кола на гејтот) [2]. Барањето за врвна струја е сопствениот проектен критериум на каталошкиот лист: драјверот мора да го испорача Miller полнежот во рамки на целното време на транзиција, IP EAK = QGD/dt, и способноста од 3.7 A е проверена наспроти ова во Дел V-C [2].

D. Заклучок за компатибилноста
Табела V ги сумира проверките на компатибилноста за целиот опсег на напони на батериите.
Спрегата е електрично исправна за целиот опсег на напони на батериите. При највисокиот напон на сабирницата (60 V при полна 48 V батерија) 100 V класата дава DC маргина од ≈ 1.67× и околу 40 V резерва за надскокот на VDS при исклучување предизвикан од L · di/dt; ова е поудобно отколку што изгледа, но го прави управувањето на брзината на исклучување (преку асиметричната мрежа на отпорници во Дел V-D) уште поважно отколку на фиксна 48 V сабирница. Единствената точка што бара квантитативна проверка — бидејќи дизајнот паралелно поврза два MOSFET-и со висок Qg по прекинувач — е дали еден канал на UCC27211A-Q1 може доволно брзо да го наполни и испразни удвоениот полнеж на гејтот. Ова е разгледано во Дел V-C и во димензионирањето на bootstrap-от во Дел V-A и е причината зошто стандардниот 0.1 µF bootstrap кондензатор препорачан во каталошкиот лист мора да се преиспита за оваа оптоварувачка состојба.
V. Дизајн на колото за управување на гејтот Низ целиот овој дел, полнежот на гејтот за една прекинувачка позиција е двојно поголем од оној на еден уред, бидејќи се поврзани паралелно два MOSFET-и:
Qg,поз = 2 × Qg = 2 × 211 nC = 422 nC (најлош случај, до 10 V) [3]. | (6)

ТАБЕЛА V
Проверка на компатибилноста на компонентите.
Проверка | Барање | Овој дизајн | Исход
Напон на блокирање | VDS ≫ Vbus,max вкл. ringing | 100 V наспроти 60 V; ≈ 1.67×
| | DC маргина | Поминува
| | | — ≈ 40 V
| | | резерва за
| | | надскок при
| | | исклучување [3]
Напон на high-side напојувањето | VHB > Vbus,max | 120 V boot, 105 V препорачано
| | HS, наспроти 60 V | Поминува [2]
Ниво на управување на гејтот | VGS,max > VDD ≥ полна
| спроводливост | ±20 V граница, управуван на
| | 12 V | Поминува [3],
| | | [2]
UVLO | VDD > UVLO | 12 V наспроти 7 V (VDD), 6.7 V
| | (HB) | Поминува [2]
Негативно ringing на јазолот | HS поднесува потсек | −12 V преодна способност при
| | VDD = 12 V | Поминува [2]
Струен капацитет | ID ≫ струја на гранката | 2 × 250 A (100 °C) наспроти
| | ≈ 75 A (најлош случај при
| | Vbus,min = 20 V) | Поминува [3]

Сила на управување наспроти
полнеж

Доволна струја низ Miller
plateau за паралелниот полнеж
в. Дел V-C | Поминува

Бидејќи гејтот се управува до 12 V наместо до 10 V (при кои е специфициран Qg), и бидејќи кривата на полнежот е речиси рамна над ∼ 7 V (па дополнителниот полнеж од 10 до 12 V е претежно линеарниот член CGS), се додава резерва од ≈ 10 %. Дополнително, Qg е специфициран при напон одвод–извор од 50 V [3]; при најлошиот напон на сабирницата од 60 V, Miller полнежот Qgd (кој зависи од нишањето на напонот на одводот) е маргинално поголем за неколку nC по уред (бидејќи Crss нагло опаѓа со напонот), но и тоа е опфатено со истата резерва. Резултирачката проектна вредност е

Qg,поз,проект ≈ 465 nC по прекинувачка позиција. | (7)
A. Bootstrap кондензатор
a) Метод.: Bootstrap кондензаторот CBOOT го обезбедува целиот полнеж потребен за вклучување на high-side уредот и за напојување на струјата на мирување на high-side степенот во текот на спроводноста на high-side-от, додека опаѓа за не повеќе од дозволената вредност ∆VBS [8], [11]. Управувачките равенки се
∆VBS ≤ VDD − VF − VGS,min − VDS,on, | (8)

QT OT AL = Qg,поз +

IQBS + ILK

fSW

+ QLS, | CBOOT ≥

QT OT AL

∆VBS

, | (9)

со дополнителна резерва од ∼ 20 % препорачана за толеранции и за опаѓањето на капацитивноста кога диодата е интегрирана [12].
b) Бројки.:
- Пад на boot диодата при релевантната струја на полнење: VF ≈ 0.9 V [2].
- Се бара гејтот на high-side-от да остане целосно спроводен, VGS,min ≈ 10 V; low-side VDS,on ≈ 0.1 V. Тогаш дозволеното опаѓање според (8) е ∆VBS ≤ 12 − 0.9 − 10 − 0.1 = 1.0 V [8]. Се избира конзервативна проектна цел од ∆VBS = 0.5 V, што го задржува лебдечкото напојување на ≈ 10.6 V — далеку над 6.7 V UVLO прагот на HB [2].
- Полнеж од мирување/протекување во текот на најлошото време на спроводност на high-side-от. Со IQBS = 0.12 mA [2], MOSFET IGSS = 2 × 100 nA [3] и висок duty cycle Dmax ≈ 0.95 (па tHS = 0.95/40 kHz =
23.75 µs):
Qleak ≈ (0.12 mA)(23.75 µs) ≈ 2.9 nC ≪ Qg,поз. | (10)

Полнежот на гејтот целосно доминира, па

QT OT AL ≈ 465 nC + 3 nC ≈ 468 nC, | (11)

CBOOT ≥

468 nC
0.5 V
≈ 0.94 µF | . | (12)

Со примена на препорачаната резерва и со отчитување на опаѓањето на капацитивноста при DC-преднапон кај керамичките кондензатори од класа II, избраната вредност е
CBOOT = 2.2 µF, X7R, ≥ 25 V, керамички со ниска ESR, поставен директно меѓу пиновите HB–HS [2], [12].
c) Забелешка за опсегот 0.022–0.1 µF од каталошкиот лист.: Тој опсег е точен за еден MOSFET со ∼ 30–90 nC полнеж на гејтот [2]; овде паралелниот пар бара ≈ 5× повеќе полнеж, што е токму причината зошто каталошкиот лист наведува дека вредноста зависи од полнежот на гејтот на high-side MOSFET-от [2]. Со употреба на 0.1 µF би се добило опаѓање од 468 nC/0.1 µF ≈ 4.7 V по циклус — доволно за недоволно управување или дури за активирање на high-side UVLO. Затоа поголемата вредност од 2.2 µF не е опционална за оваа оптоварувачка состојба.
d) Проверка на полнењето.: Кондензаторот го надополнува само ≈ 468 nC отстранет во секој циклус, а не целиот полнеж. При најлош duty cycle, времето на спроводност на low-side-от е ≈ 1.25 µs; потребната просечна струја на полнење е 468 nC/1.25 µs ≈ 0.37 A, додека интегрираната 0.55 Ω boot диода може почетно да испорача (12 − 0.9)/0.55 ≈ 20 A [2]. Затоа полнењето е удобно при 40 kHz. При многу мала брзина на моторот со duty cycle близу 100 % на high-side-от, прозорецот за надополнување се намалува и може да биде потребен периодичен low-side освежувачки импулс — позната ограниченост на сите bootstrap напојувања [8], [9].
B. Bootstrap диода
UCC27211A-Q1 ја интегрира bootstrap диодата (анода кон VDD, катода кон HB); таа е оценета на 120 V, има типична динамичка отпорност од 0.55 Ω, пад на напон од ≈ 0.9–1.05 V при 100 mA и време на исклучување од 20 ns [2]. За овој дизајн внатрешната диода е соодветна: Дел V-A покажува дека и струјата на полнење и опаѓањето се удобно во рамки на нејзината способност, а нејзината 120 V оценка ја надминува 48 V сабирницата со голема маргина [2].
Опционална надворешна диода паралелно со внатрешната може да се додаде ако проектантот сака дополнително да го намали падот на напон при полнење и опаѓањето по циклус. Ако се користи, мора да задоволи [8], [9]: обратен напон ≥ Vbus + VDD маргина → се избира 100 V компонента за совпаѓање со напонската класа на MOSFET-от; брзо обратно закрепнување (reverse recovery, trr ≤ 50 ns) или Schottky; и струја на спроводност ≥ врвната струја на полнење (≥ 1 A е доволно). Бидејќи функцијата веќе е обезбедена на чипот, оваа компонента е надградба, а не неопходност.
C. Отпорници на гејтот и проверка на врвната струја / Miller
a) Барање за пригушување (Balogh).: Оптималниот надворешен отпорник на гејтот за критично пригушување на резонанцата во колото на гејтот, формирана од индуктивноста на изворот LS и Ciss, е [7]
RGAT E,OP T = 2r
LS

CISS

− (RDRV + RG,I ). | (13)

За куќиштето TOLL со ниска индуктивност (LS од редот на 1 nH) и Ciss = 12 nF, 2

p
| | LS/CISS ≈ 0.58 Ω,
додека излезната импеданса на драјверот плус внатрешната отпорност на гејтот (RDRV + RG,I ) веќе ја надминуваат. Резултатот е негативен, што значи дека колото е веќе прекумерно пригушено само од импедансата на драјверот и внатрешната отпорност на гејтот од 1.4 Ω [7], [3]. Затоа надворешниот отпорник на гејтот се избира не за пригушување, туку за: (i) да ја држи споделената излезна струја на драјверот во рамки на оценката, (ii) да го наштелува dv/dt заради EMI и (iii) да ги избалансира двата паралелни уреди.

b) Поединечни отпорници.: Најдобрата практика за паралелни MOSFET-и е поединечен отпорник на гејтот кај секој гејт (по два по прекинувачка позиција) наместо еден заеднички, така што секоја тенденција двата уреди да осцилираат еден против друг се пригушува и нивното прекинување се балансира. Се избира стандардна вредност
RG,ext = 2.2 Ω (по еден на секој MOSFET, E24),
блиску до 1.8 Ω при кои се карактеризирани времињата на прекинување на IPT015N10N5 [3].
c) Проверка на врвната струја / dv/dt.: Miller plateau е на Vplateau = 4.4 V [3]. Со гејтот задржан на платото, мрежата би барала по уред

IG =

VDD − Vplateau

RG,ext + RG,I

=

12 − 4.4
2.2 + 1.4
| ≈ 2.1 A, | (14)

т.е. ≈ 4.2 A за двата уреди заедно. Ова ја надминува границата на изворната струја на драјверот од 3.7 A [2], па драјверот ја ограничува струјата на 3.7 A и напонот на јазолот опаѓа — драјверот, а не отпорникот, ја одредува брзината. Времето за испорака на комбинираниот Miller полнеж (2 × 51 nC = 102 nC макс.) при 3.7 A е
tM iller = | Qgd,поз
| IO,source = 102 nC 3.7 A
| ≈ 28 ns, | (15)

што дава, на најлошиот случај на сабирницата од 60 V (полна 48 V батерија),

dVDS
dt

≈

| 60 V 28 ns
| ≈ 2.1 V/ns, | (16)

што е умерено (добро за спроведено EMI) и далеку под границата на slew rate од 50 V/ns на пинот HS [2]. Ова го потврдува клучното прашање за компатибилноста: дури и со удвоениот полнеж на гејтот од паралелното поврзување, еден канал на UCC27211A-Q1 го прекинува парот за под 30 ns — токму за што е наменета оценката 3.7 A/4.5 A на уредот, имено „управување на големи енергетски MOSFET-и со минимизирани прекинувачки загуби при преминот низ Miller plateau-то“ [2]. Сепак, единствената вредност од 2.2 Ω изведена овде е само симетрична основа: Дел V-D ја префинува во асиметрична мрежа за вклучување/исклучување, која е конфигурацијата што всушност е усвоена.

D. Асиметрична (поделена) мрежа на отпорници на гејтот
Единствениот отпорник од Дел V-C принудува една вредност да служи за двата фронта на прекинување, што е компромис. Овој дел го заменува со асиметрична мрежа што ги поставува брзините на вклучување и исклучување независно — побавно, помеко вклучување и брзо исклучување со ниска импеданса — која е конфигурацијата усвоена во финалниот дизајн.
a) Топологија.: По MOSFET, секогаш присутниот сериски отпорник Ron ја носи струјата на вклучување (изворна), а гранка од Rof f во серија со OFF диода Dof f се поставува паралелно со него. Dof f е ориентирана со анода кон гејтот и катода кон излезот на драјверот, така што спроведува само кога гејтот се влече надолу (исклучување / dv/dt стегач). Следствено,
Rg(on) = Ron, | Rg(off) = Ron ∥ (Rof f + RD). | (17)

При вклучување Dof f е обратно поларизирана и гејтот гледа само Ron; при исклучување двете патеки спроведуваат и гејтот ја гледа пониската паралелна комбинација [7], [13]. (Со една OFF диода, Ron останува во патеката на исклучување; пониската гранка Rof f едноставно го шунтира, поради што Rg(of f) е паралелна комбинација, а не само Rof f .)
b) Проектна насока — бавно вклучување, брзо исклучување.: За тврдо прекинуван полумост, претпочитаната асиметрија е побавно вклучување, побрзо исклучување [13], [14], [15]. Побрзото вклучување го зголемува di/dt на струјата на одводот, што ја зголемува струјата на обратно закрепнување (reverse recovery) на телесната freewheeling диода на комплементарниот уред; телесната диода на IPT015N10N5 складира Qrr ≈ 316 nC (trr ≈ 103 ns) [3], па намерно омекнатото вклучување го ограничува тој врв на закрепнување, придружната загуба и EMI што таа ги генерира [13], [14]. Спротивно на тоа, исклучувањето има корист од тоа да биде брзо и со ниска импеданса: ги намалува загубите при исклучување и, што е клучно, го држи гејтот на исклучениот уред цврсто кон масата, така што Miller струјата инјектирана низ CGD кога комплементарниот прекинувач го менува јазолот не може да го подигне VGS до прагот и да предизвика лажно (само-)вклучување [14], [15]. 100 V уредот на сабирница до 60 V има доволна напонска резерва (≈ 40 V) да го апсорбира малку повисокиот di/dt надскок при исклучување што го произведува брзото исклучување; токму затоа што таа резерва е помала отколку на фиксна 48 V сабирница, можноста независно да се контролира фронтот на исклучување е уште поценета. Асиметријата ја засилува и сопствената нерамнотежа 4.5 A-понор / 3.7 A-извор на драјверот [2].
c) Избор на вредности.:
- Ron = 3.3 Ω (по MOSFET). Зголемен над компромисот од 2.2 Ω од Дел V-C за да се омекне фронтот на вклучување. Резултирачката струја на вклучување по уред на платото е I = (12 − 4.4)/(Ron + RG,I ) = 7.6/(3.3 + 1.4) = 1.62 A, т.е. ≈ 3.2 A за парот — сега поставена од отпорникот, а не од границата на драјверот од 3.7 A, што дава контролиран dv/dt од 60 V/(102 nC/3.2 A) ≈ 1.9 V/ns во најлош случај [3], [2].
- Rof f = 1.0 Ω (по MOSFET). Со динамичка отпорност на OFF диодата RD ≈ 0.1–0.15 Ω (проценета од спроводната карактеристика на PMEG4030ER, VF ≈ 0.46–0.54 V во релевантниот опсег [13]):
Rg(off) = Ron ∥ (Rof f + RD) = 3.3 ∥ 1.15 ≈ 0.85 Ω. | (18)
Ова дава ефективен однос на отпорност вклучување:исклучување од околу 3.9 : 1.
d) Зошто Rof f не се намалува понатаму.: Внатрешната отпорност на гејтот RG,I = 1.4 Ω е во серија со чипот и не може да се заобиколи [3]. Затоа вкупната отпорност на колото на гејтот при исклучување е RG,I + Rg(off) = 1.4 + 0.85 = 2.25 Ω, и дури и со Rof f = 0 не би можела да падне под ≈ 1.4 Ω. Намалувањето на Rof f под ∼ 1 Ω затоа дава сè помали придобивки, па 1.0 Ω е добро поставен избор. При оваа вредност, врвната струја на исклучување по уред на платото е 4.4/2.25 ≈ 1.96 A (≈ 3.9 A за парот), блиску до границата на понорната струја на драјверот од 4.5 A, што дава транзиција на исклучување од ≈ 26 ns наспроти ≈ 32 ns при вклучување — посакуваната асиметрија [2].
e) Избор на OFF диода.: Dof f мора: (i) да го блокира обратниот напон што се појавува на Ron при вклучување (≈ Ion,peak · Ron ≈ 1.62 A × 3.3 Ω ≈ 5.3 V, плус ringing); (ii) да ја носи струјата на импулсот при исклучување (≈ 2 A врв по гејт); (iii) да закрепнува моментално, така што не додава полнеж на следното вклучување; и (iv) да има ниска динамичка отпорност, така што Rof f доминира во патеката на исклучување. Schottky диода ги задоволува сите четири. Избраната компонента е
Dof f = Nexperia PMEG4030ER — 40 V, 3 A Schottky исправувачка диода со низок VF (VF ≈ 0.46– 0.54 V, IF SM = 50 A, SOD-123W) [13].
Нејзината оценка од 40 V дава > 7× маргина над ∼ 5 V обратен напрег; нејзината оценка од 3 A просечно / 50 A ударно ја надминува струјата на импулсот при исклучување од ∼ 2 A; нејзиниот низок VF и мала спојна капацитивност ја држат патеката на исклучување чиста; а како Schottky има занемарливо обратно закрепнување [13]. Широко достапна алтернатива е 1N5819 (40 V, 1 A Schottky), со прифаќање на нејзиното поголемо куќиште и капацитивност.
f) Снага и куќиште на отпорниците.: Просечната снага дисипирана во отпорникот на гејтот е дел од вкупната загуба за управување на гејтот, PG = Qg VDD fSW [7]. По уред, со Qg ≈ 232 nC при 12 V, PG ≈ 232 nC × 12 V × 40 kHz ≈ 0.11 W, поделена подеднакво меѓу вклучувањето и исклучувањето. Уделот што паѓа на надворешниот отпорник е неговата фракција од вкупната отпорност во колото на гејтот [7]; со проценета излезна отпорност на драјверот RHI ≈ 3.2 Ω:

PRon ≈

Ron

RHI + Ron + RG,I

·

1
2QgVDDfSW =

3.3
7.9
× 0.0557 W ≈ 26 mW, | (19)
PRoff ≈ 6 mW (само при исклучување; останатото го носат RHI и RG,I ). | (20)
Двете се далеку под 1/16 W. Сепак, отпорникот гледа кратки струјни врвови (∼ 1.6–2 A), па изборот на куќиште се води од енергијата по импулс и од маргината, а не само од просечната снага: енергијата по транзиција во Ron е ≈ 0.42 ×

1
2QgVDD ≈ 0.6 µJ, занемарливо во споредба со импулсната издржливост на кој било чип-отпорник. Се избира
Ron, Rof f : куќиште 0805, дебелослоен (thick-film), 1/8 W (125 mW), што дава > 4× маргина на просечната снага и солидна импулсна резерва; работниот напон (∼ 12 V) е далеку под напонската оценка на 0805 (∼ 150 V) [7].

ТАБЕЛА VI
Споредба: единствен отпорник наспроти асиметрична мрежа.
Аспект | Единствен RG = 2.2 Ω (Дел V-C) | Асиметрична Ron = 3.3 Ω / Rof f =
| | 1.0 Ω + Dof f
Фронт при вклучување | Среден — принуден компромис | Помек (Rg(on) = 3.3 Ω); dv/dt ≈
| | 1.5 V/ns [3], [2]
Фронт при исклучување | Ист како при вклучување (не може
| да се разликува) | Брз (Rg(of f) ≈ 0.85 Ω надв.); близу
| | полн понор од 4.5 A [2]
Обратно закрепнување на комплем. диода | Врзано за изборот при исклучување | Независно укротено од бавното
| | вклучување [13], [14]
Импеданса на стегачот во исклучена состојба | RG,I + 2.2 = 3.6 Ω | RG,I + 0.85 = 2.25 Ω → повисок праг
| | на dv/dt за самовклучување [14],
| | [15]
Независна оптимизација на фронтовите | Невозможна | Да — целта на мрежата [13]
Загуба при исклучување | Повисока ако RG се зголеми за меко
| вклучување | Пониска (задржано брзо
| | исклучување)
Дополнителни компоненти по MOSFET | — | +1 отпорник, +1 Schottky

Куќиштето 0603 (1/10 W) исто така е електрично доволно; 0805 е претпочитано заради подобро ширење на топлината, импулсна робусност и леснотија на монтажа. (Pull-down отпорникот RGS е димензиониран во Дел V-E.)
g) Зошто асиметричниот пристап е претпочитан.: Со единствен отпорник проектантот се соочува со неизбежен конфликт [13], [14]: мала вредност дава брзо исклучување (ниска загуба, силен стегач), но и брзо вклучување што го влошува обратното закрепнување на комплементарната телесна диода, dv/dt и EMI; голема вредност го омекнува вклучувањето, но истовремено го забавува исклучувањето, зголемувајќи ја загубата при исклучување и слабеејќи го стегачот на dv/dt што спречува shoot-through. Асиметричната мрежа го раствора овој конфликт со раздвојување на двата фронта [13]. Тоа раздвојување е особено вредно во оваа апликација, бидејќи секоја од трите гранки е тврдо прекинуван полумост во кој секое вклучување комутира freewheeling телесна диода што носи струја од редот на 100 A; бидејќи два паралелни MOSFET-и со висок Qg по прекинувач ја удвојуваат и Miller струјата и цената на секоја вкрстена спроводност; и бидејќи напонската резерва 100 V/48 V му дозволува на дизајнот да искористи брзо исклучување без грижа за надскок. Цената — дванаесет дополнителни отпорници и дванаесет Schottky диоди за целиот инвертор — е занемарлива наспроти добивките во ефикасноста, EMI однесувањето и отпорноста на паразитско вклучување [13], [14], [15]. Поради овие причини, асиметричната мрежа ја заменува основата со единствен отпорник од Дел V-C и е конфигурацијата пренесена во финалниот список на материјали.
E. Pull-down отпорници гејт–извор
Отпорник од гејт кон извор го држи секој MOSFET дефинирано исклучен пред излезите на драјверот да станат активни при вклучување на напојувањето и обезбедува заштита од Miller-индуцирано вклучување при dv/dt [7]. Вредноста на pull-down-от следи од релацијата за имунитет на dv/dt [7]:
dv
dt
LIMIT

=

VT H − 0.007 (TJ − 25)

RG,I CGD

. | (21)

Во нормална работа, ниската излезна импеданса на драјверот и понорот од 4.5 A доминираат во оваа заштита; главната задача на pull-down-от е состојбата при вклучување на напојувањето. Стандардна вредност
RGS = 10 kΩ (по еден на секој MOSFET)
е доволно голема за да не го оптоварува драјверот и доволно мала за да го држи гејтот надолу при вклучување. Проценката со капацитивен делител на индуцираното вклучување ја потврдува маргината: кога спротивниот прекинувач наметнува најлош напон од 60 V на исклучениот уред, најлошиот пораст на гејтот низ делителот

Crss/Ciss = 80 pF/12 nF ≈ 0.0067 би бил ≈ 0.40 V дури и со лебдечки гејт — сè уште далеку под прагот од 2.2 V [3] — а активниот понор од 4.5 A ја држи вистинската вредност уште пониска [2].
a) Снага и куќиште на RGS.: Кога гејтот е управуван на 12 V, RGS непрекинато дисипира P =
V

2

GS/RGS = 12²/10 kΩ = 14.4 mW (просечно помалку, бидејќи гејтот не е секогаш висок). Затоа е доволно куќиште 0603, 1/10 W (100 mW) (> 6× маргина); за единственост на спецификацијата може да се користи и 0805, 1/8 W заедно со отпорниците на гејтот.

F. Кондензатори за декуплирање (decoupling)
a) VDD (low-side) декуплирање.: Секогаш кога LO излезот испорачува струја на гејтот, еднаков струен импулс се влече низ VDD, па керамички кондензатор со ниска ESR мора да стои директно меѓу VDD–VSS [2]. Димензиониран за толерантно бранување ∆V со истиот аргумент за полнеж како кај bootstrap-от,

CV DD ≥

Qg,поз
∆V

=

465 nC
0.5 V
≈ 0.93 µF. | (22)

TI препорачува 0.22–4.7 µF и горниот крај за ниски температури и висок полнеж на гејтот [2]. Избрано: CV DD = 4.7 µF X7R + 0.1 µF керамички, по драјвер, со посебен кондензатор за секој од трите драјвери [2].
b) HB (high-side) декуплирање.: Оваа улога ја извршува самиот bootstrap кондензатор (Дел V-A), поставен директно меѓу пиновите HB–HS; посебната препорака од TI за 0.022–0.1 µF е минималното високофреквентно декуплирање и овде е надмината од пресметаната вредност од 2.2 µF [2].
c) Bulk на 12 V сабирницата.: Споделен bulk резервоар (на пр. 22–47 µF електролитски или керамички) на помошната 12 V сабирница ги напојува трите драјвери и ги апсорбира збирните струјни импулси за управување на гејтот; TI советува посебен VDD кондензатор за декуплирање по драјвер во системи со повеќе драјвери [2].
d) Декуплирање на DC-link.: Бидејќи изворот е батерија поврзана преку сноп кабли, импедансата на изворот (внатрешната отпорност на батеријата плус индуктивноста на снопот) е значителна; затоа локалното DC-link декуплирање е уште поважно отколку кај крута лабораториска сабирница. Енергетскиот степен носи бранувачка струја од редот на 100 A (до ≈ 150 A во најлош случај при празна 24 V батерија) и мора да се декуплира со DC-link банка со ниска ESR/ESL (фолиски и/или керамички) близу полумостот, димензионирана за RMS бранувачката струја и за да го држи надскокот на сабирницата во рамки на оценката од 100 V при комутација. Бидејќи највисокиот напон на батеријата е 60 V, кондензаторите на сабирницата треба да имаат напонска оценка ≥ 80 V (фолиски) или ≥ 100 V (керамички, со отчитување на опаѓањето при DC-преднапон). Прецизното димензионирање зависи од индуктивноста на снопот и е задача на ниво на плоча.
G. Список на компоненти за управување на гејтот (по гранка / по плоча)
Табела VII ги наведува пасивните помошни компоненти за управување на гејтот. Покрај нив, активните уреди се 12× IPT015N10N5 (4 по гранка) и 3× UCC27211A-Q1.

VI. Мерење на фазна струја
A. Преглед и споредба на топологии за мерење на струја
Постојат четири фамилии на мерење на струја кај инвертор; нивниот мерен јазол е прикажан на Сл. 1 за еден half-bridge.
Решавачкиот атрибут за FOC е можноста да се семплира вистинската фазна струја во секој PWM период, независно од работниот циклус. Low-side shunt-от носи фазна струја само додека спроведува low-side уредот, па при висок duty (висока брзина / висока модулација) прозорецот на спроведување се намалува и мерењето станува непрецизно или бара изобличување на PWM (вметнување на минимално време на спроведување) [16]. Единечниот DC-link shunt ги реконструира трите фазни струи од моменталната склопна состојба, но трпи од „ненабљудливи“ области во близина на границите на напонските вектори, каде што времињата на задржување на два активни вектори паѓаат под времето на стабилизирање/blanking на shunt-от, што повторно бара модификација на PWM. In-line (in-phase) shunt-от е поставен на сериска врска со изводот на моторот, па

ТАБЕЛА VII
Список на пасивни помошни компоненти за управување на гејтот.
Ознака | Функција | Вредност | По гранка | 3 гранки
CBOOT | Bootstrap кондензатор (HB–HS) | 2.2 µF X7R ≥ 25 V | 1 | 3
CV DD | Декуплирање на VDD | 4.7 µF X7R + 0.1 µF | 1 сет | 3 сета
Ron | Отпорник за вклучување (по
| MOSFET) | 3.3 Ω, 0805, 1/8 W | 4 (2 HS + 2 LS) | 12
Rof f | Отпорник за исклучување (по
| MOSFET) | 1.0 Ω, 0805, 1/8 W | 4 | 12
Dof f | OFF Schottky диода | Nexperia PMEG4030ER (40 V,
| | 3 A) | 4 | 12
RGS | Pull-down гејт–извор | 10 kΩ, 0603, 1/10 W | 4 | 12
DBOOT (опц.) Надворешна паралелна boot
| диода | 100 V брза/Schottky ≥ 1 A | 0–1 | 0–3
CBULK | Bulk на 12 V сабирница | 22–47 µF | — | 1 (споделен)

Vbus

GND

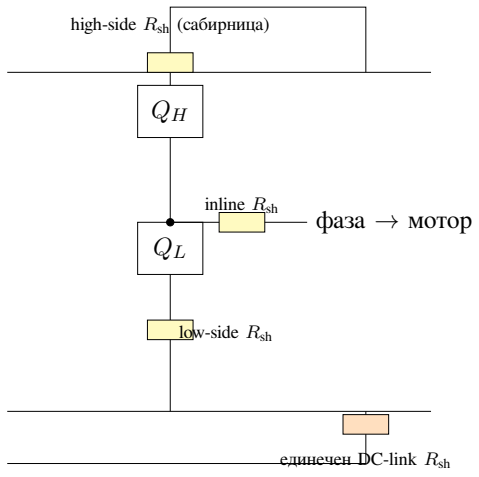
[picture p13: figure]
фаза → мотор; inline Rsh; low-side Rsh; high-side Rsh; (сабирница); единечен DC-link Rsh

Сл. 1. Можни позиции на shunt во една гранка од инверторот: high-side (на сериска врска со гранката од сабирницата), low-side (на сериска врска со гранката кон заземјувањето), in-line (на сериска врска со фазниот спроводник), и единечниот DC-link shunt во заедничкиот повраток. Hall/магнетната алтернатива го заменува shunt-от со сензор на поле околу фазниот спроводник.

ја спроведува фазната струја континуирано и може да се семплира при кој било работен циклус; затоа токму оваа топологија се користи во референтните дизајни за серво и за FOC со високи перформанси [17], [18]. Нејзината единствена тешкотија е тоа што мерниот елемент се наоѓа на јазол што се ниша помеѓу земја и Vbus на fsw со големо dv/dt, па засилувачот мора да комбинира широк common-mode (CM) опсег со силно потиснување на CM преодните појави [18], [17].
Магнетната/Hall алтернатива ја отстранува загубата од вметнување и обезбедува изолација, но по повисока цена и со поголем офсет и термички дрифт отколку ланецот shunt-плус-zero-drift-засилувач; изолацијата не е потребна тука бидејќи дизајнот е експлицитно common-ground. Со оглед на common-ground ограничувањето, потребата за FOC набљудливост при целосен duty на сите три фази, и управливата дисипација во shunt-от изведена подолу, избрана е топологијата in-line shunt, во согласност со спецификацијата и со 48-V in-line FOC референтниот дизајн на TI, TIDA-00913 [17].
B. Димензионирање на shunt отпорникот
Три конкурентни ограничувања ја одредуваат вредноста на shunt-от Rsh: (1) дисипацијата на моќност PRsh =
I

2
phRsh мора да остане во рамки на економичен површински-монтиран елемент; (2) сигналниот напон на полна скала Vˆ

sh = ˆIphRsh мора, по засилувањето, да се вклопи во влезниот прозорец на ADC без отсекување (clipping)

ТАБЕЛА VIII
Споредба на топологии за мерење на струја кај трифазен инвертор.
Атрибут | Low-side shunt | High-side shunt | In-line | (in-phase)
| | | shunt

Магнетна / Hall

Common-
mode | напон
на | мерниот
елемент | Близу до земја (≈0)
На/близу Vbus | Се ниша од шина
до шина на fsw со
високо dv/dt

Галвански изолиран;
сензорот не гледа CM
Ја | мери
вистинската
фазна струја при
сите работни
циклуси
Не | — | само
додека
спроведува
QL; слеп при
≈ 100% duty
Не | — | само
додека
спроведува
QH
Да | —
континуирано,
при кој било duty

Да

Барање | за
засилувач
| Low-CM CSA | High-CM CSA | High-CM CSA со PWM потиснување
— | (сензорот | е
засилувачот)
DC способност | Да | Да | Да | Да (Hall) / Не (CT,
| | | | Rogowski)
Загуба | од
вметнување | I
| 2R во shunt | I
| | 2R во shunt | I
2R во shunt | Занемарлива
Точност / дрифт | Висока / низок | Висока / низок | Висока / низок | Умерена; | офсет | и
термички | дрифт,
нелинеарност
Изолација | Не | Не | Не | Да
Релативна цена | Најниска | Ниска | Ниска–умерена (CSA/фаза) | Највисока
Најпогодна за | 6-step / евтини, ограничен duty опсег | Мониторинг на батерија/полнач | Високи перформанси
FOC | низ
целиот | опсег
| | | на брзина/duty
Многу | високи
струи | или | дизајни
каде изолацијата е
задолжителна

при врвот во најлош случај (со резерва за преоптоварување); и (3) Rsh треба да биде доволно голем за да офсетот и шумот на засилувачот, сведени на струја, останат мали.
За Rsh = 0.1 mΩ при работната точка во најлош случај (I

max
ph = 136 A rms):

PRsh = I

2

phRsh = (136.1)² × 0.1 × 10−3 = 1.85 W, | (23)

Vˆ

sh = ˆIph Rsh = 192.5 × 0.1 × 10−3 = 19.3 mV. | (24)

Отпор од 0.1 mΩ ја држи дисипацијата на 1.85 W, што удобно се справува од страна на shunt од метален елемент (метална лента) со 5 W (резерва од 2.7×), додека 19.3 mV врв е доволно голем за прецизно засилување. Елемент од метална лента е избран поради неговата многу ниска паразитна индуктивност (ESL) и низок температурен коефициент; четири-приклучна (Kelvin) врска е задолжителна за сигналниот напон да се зема само на резистивниот елемент, а не на лемните споеви со голема струја [18]. ESL е важна бидејќи измерениот напон е vsh(t) = Rsh i(t) + ESL di
dt

; на 40 kHz со брзи склопни рабови индуктивниот член мора да биде занемарлив наспроти резистивниот член од 0.1 mΩ, што го постигнува елемент од метална лента со < 2 nH.

C. Избор на струен засилувач и засилување
Засилувачот мора (i) да поднесува CM напон што се ниша од малку под земја (спроведување на body-диода / dead-time, ≈ −1 V) до Vbus = 60 V плус пречекорувањето од ѕвонење; (ii) да го потиснува големото CM dv/dt при секој склопен раб така што излезот да не ѕвони; (iii) да биде двонасочен бидејќи фазната струја е AC;

и (iv) да има пропусен опсег далеку над 40 kHz. Texas Instruments INA240 ги задоволува сите четири: тоа е струен засилувач со напонски излез и zero-drift архитектура, со CM опсег од −4 до +80 V независно од напојувањето, со „enhanced PWM rejection“ експлицитно проектирано да ги потисне CM преодните појави на PWM за погон на мотор, и се нуди во четири фиксни засилувања од 20, 50, 100, 200 V/V [18]. Долната граница од −4 V ја прифаќа екскурзијата под земја, а горната граница од +80 V остава 20 V резерва над сабирницата од 60 V за пречекорувањето од ѕвонење.
При напојување од 3.3 V аналоген извор, двонасочниот излез при нулта струја е центриран од двата референтни приклучоци на INA240, чиј внатрешен разделник ја поставува средната точка на излезот на Vref = (VREF1 + VREF2)/2 [18]; врзувањето на REF1 за земја и REF2 за шината од 3.3 V дава Vref = 1.65 V. Тогаш излезниот напон е
Vout = Vref + G Rsh iph. | (25)

Со rail-to-rail излез, употребливата едностранска амплитуда е ≈ 1.45 V (со резерва од 0.2 V до секоја шина). Со избор на засилување G = 50 (INA240A2), линеарната врвна струја на полна скала е

ˆIFS =

1.45

G Rsh

=

1.45
50 × 0.1 × 10−3
= 290 A врв (205 A rms). | (26)

Врвот во најлош случај од 193 A произведува излезна екскурзија од GRsh ˆIph = 50 × 0.1m × 192.5 = 0.96 V, т.е. Vout ∈ [0.69, 2.61] V, оставајќи ≈ 0.49 V пред отсекувањето. Оваа резерва е намерно зачувана за преодно пречекорување и овозможува прагот за пречекорна струја (over-current, OC) да се постави на ≈ 250 A врв
(1.3 × ˆI
max
ph , излезна екскурзија 1.25 V), што може да се детектира од аналоген компаратор на STM32G4 или софтверски пред засилувачот да засити. Квантизацијата и офсетот, сведени на струја, се

∆ILSB =

Vref+/2N

G Rsh

=

3.3/4096
50 × 0.1m
= 0.16 A/LSB, | (27)

Ios =

Vos(max)

Rsh

=

25 µV
0.1mΩ
= 0.25 A, | (28)

двете занемарливи наспроти сигнал од 136 A (zero-drift архитектурата на INA240 дава Vos ≤ 25 µV [18]). Поради тоа, парот засилување-50 / 0.1 mΩ се претпочита пред алтернативниот пар засилување-20 / 0.25 mΩ, кој би дисипирал 4.6 W по shunt за иста полна скала.

D. ADC интерфејс и излезно филтрирање
За FOC фазната струја се семплира синхроно со PWM носителот (вообичаено при врвот/долот на бројачот), така што моментот на семплирање се совпаѓа со средината на склопната состојба, каде што компонентата на бранувањето (ripple) на индукторот е на нејзината средна вредност; ова природно го потиснува бранувањето на 40 kHz и неговите хармоници без тежок филтер [20]. Тежок anti-alias филтер наместо тоа би додал фазно доцнење на токму оној сигнал на кој се затвора струјната јамка, влошувајќи ја јамката. Затоа излезот на CSA користи само лесен RC филтер од прв ред (Rf = 100 Ω, Cf = 2.2 nF), кој (i) го ограничува опсегот на високофреквентниот склопен шум и ѕвонење (гранична фреквенција fc = 1/2πRfCf = 723 kHz, далеку над содржината на струјната јамка во kHz-опсегот, но придушувајќи го ѕвонењето од десетици MHz), и (ii) дејствува како резервоар на полнеж за sample-and-hold на ADC. Ниската излезна импеданса на INA240 ги управува оваа мрежа и кондензаторот за семплирање на ADC со обилна резерва за стабилизирање. Хардверското oversampling/усреднување на STM32G4 може да се овозможи за дополнително намалување на шумот по цена на пропусност [20]. Сл. 2 го прикажува комплетниот ланец по фаза.

VII. Мерење на напон
A. Барања
Контролерот мора да поддржува сензорско FOC (Hall/енкодер) и безсензорско FOC, при што второто ја реконструира положбата на роторот од back-EMF. Затоа е потребно хардверско мерење на напон за (i) напонот на DC-сабирницата — за заштита од пренапон/поднапон, скалирање на индексот на модулација и пресметка на моќност — и (ii) секој од трите напони на фазните јазли — за набљудување на back-EMF и за повратна врска по фазен напон. Сите четири канали го делат заземјувањето на инверторот (неизолиран дизајн), па

фазен јазол

Rsh = 0.1 mΩ (Kelvin)

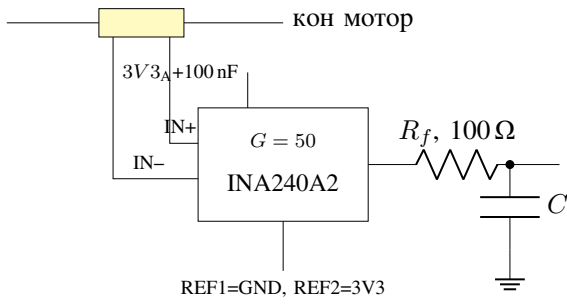
[picture p14: figure]
кон мотор; INA240A2; REF1=GND, REF2=3V3

⇒ Vref = 1.65 V

Cf , 2.2 nF

ADC

Сл. 2. In-line ланец за мерење на струја по фаза: Kelvin-приклучен shunt од метална лента со 0.1 mΩ, INA240A2 (G = 50) со референца на средна скала, и лесен RC од 723 kHz во ADC на STM32G4. Се користат три идентични ланци (фази U, V, W).

секој е заземјен отпорнички разделник што напојува ADC канал на STM32G4. Каналот на сабирницата е спор (заштита/скалирање), додека фазните канали мора да го зачуваат тајмингот на back-EMF за набљудувачот на положбата.

B. Дизајн на отпорнички разделник
Опсегот на конверзија на ADC е 0–VREF+. Користењето VREF+ = VDDA = 3.3 V го максимизира опсегот; сооднос на разделникот k = (Rtop + Rbot)/Rbot го пресликува максималниот измерен напон во близина на полна скала, со резерва. Со избор на Rtop = 110 kΩ и Rbot = 4.7 kΩ,

k =

Rtop + Rbot

Rbot

=

110 + 4.7
4.7

= 24.4, VADC =

Vin
k
. | (29)

Ова пресликува Vbus = 60 V → 2.46 V (73.2 V при полна скала, т.е. 22 % резерва над опсегот) и 30 V → 1.23 V. Истиот сооднос се користи за фазните разделници бидејќи фазен јазол може да го достигне напонот на сабирницата. Постојаната струја и дисипацијата при 60 V се

Idiv =

60

Rtop + Rbot

= 523 µA, PRtop = I

2
divRtop = 30 mW, | (30)

па сите четири разделници заедно повлекуваат ≈ 126 mW — занемарливо. Горниот отпорник го гледа целиот напон на сабирницата; единечен thick-film чип од 110 kΩ со номинал ≥ 150 V (на пр. 0805/1206) е адекватен при 60 V, но се препорачува делење на Rtop на два сериски делови од 55 kΩ за да се преполови напонскиот стрес по компонента и да се подобри температурното совпаѓање на соодносот. Thévenin изворната импеданција претставена на ADC е

Rsrc = Rtop ∥ Rbot =

110k × 4.7k
110k + 4.7k
= 4.51 kΩ, | (31)

што е клучната големина за прашањето за бафер во Дел VII-C.

C. Дали ADC бара op-amp бафер? Квантитативен одговор
ADC канал на STM32G4 семплира така што го поврзува изворот, преку внатрешна отпорност на мултиплексер/прекинувач RADC, на кондензатор за семплирање CADC во текот на програмираното време на семплирање ts (Сл. 3). Кондензаторот мора да се стабилизира во рамки на 1
2

LSB од изворниот напон. За N-битна конверзија ова бара [19], [20]

ts ≥

RAIN + RADC

CADC ln
2

N+1
, | (32)

каде што RAIN = Rsrc е надворешната изворна импеданција. ST не ги објавува RADC/CADC директно за G4; наместо тоа техничкиот лист дава табела за „максимален RAIN наспроти време на семплирање“, а упатството на ST е да се избере времето на семплирање од таа табела за дадената изворна импеданција [20]. Со користење

Vdiv

RAIN=Rsrc | RADC | ts

CADC

SAR

Сл. 3. Модел од прв ред на влезниот степен за семплирање на ADC на STM32G4 користен во (32): изворната импеданција на разделникот Rsrc на сериска врска со внатрешната отпорност на прекинувачот го полни кондензаторот за семплирање CADC во текот на прозорецот на семплирање ts.

ТАБЕЛА IX
OP-AMP бафер пред ADC: придобивки наспроти трошоци.
Аргументи за бафер | Аргументи | против
бафер
Ниска | излезна
импеданса | ⇒ брзо
стабилизирање, | кратко
време | на | семплирање,
висока | стапка | на
мултиплексирано
скенирање

Додава сопствен офсет,
дрифт, шум и грешка од
ограничен пропусен опсег
на апсолутно мерење

Го изолира разделникот
од | „kickback“ | поради
инјектирање на полнеж во
ADC / преслушување меѓу
скенираните канали

Дополнителен трошок
на BOM, површина на
плочата и декуплирање на
напојувањето

Овозможува активен anti-alias филтер

Станува дополнителен
товар за калибрација
Го спречува резистивното
оптоварување | на
разделникот

Непотребен тука: бараното
ts е мало, (32)

на моделот на стабилизирање од AN2834 со репрезентативни вредности CADC ≈ 5 pF и RADC ≈ 2 kΩ, и ln(2¹³) = 9.01 за 12-битниот режим,

ts ≥ (4510 + 2000)(5 × 10−12)(9.01) = 293 ns. | (33)

При ADC такт од 60 MHz ова е 17.6 ADC циклуси, додека STM32G4 нуди поставки за време на семплирање до 640.5 циклуси; самата поставка од 47.5 циклуси е 792 ns — повеќе од 2.7× од побараното. Бидејќи напоните на сабирницата и фазите бараат само освежување со kHz-стапка, потрошокот на подолго време на семплирање не чини ништо. Затоа:

Не е потребен надворешен op-amp бафер за напонските разделници.

Изворната импеданција на разделникот се полни до 12-битна точност во рамки на време на семплирање што е тривијално достапно; мал филтерски кондензатор (Дел VII-D) дополнително ја намалува ефективната изворна импеданција во моментот на семплирање.
Ако некогаш би се посакувал бафер — на пример за делење на еден разделник меѓу повеќе брзи мултиплексирани канали, или за додавање активен филтер — тој треба да се реализира со сопствените ресурси на MCU наместо со надворешен IC: STM32G473 содржи шест операционни засилувачи што можат да се конфигурираат како follower-и со единечно засилување (или PGA) со нивниот излез насочен внатрешно кон ADC канал, што истовремено го отстранува патот на собирање шум преку надворешен приклучок и не чини ништо на BOM [21], [1]. ST токму оваа follower-кон-ADC употреба ја документира и препорачува време

ТАБЕЛА X
Доцнење на нископропусниот фазен филтер ϕ = arctan(fe/fc) (компензирано во FIRMWARE).
fc | fe = 200 Hz | fe = 500 Hz | fe = 1000 Hz
2 kHz | 5.7° | 14.0° | 26.6°
3 kHz | 3.8° | 9.5° | 18.4°

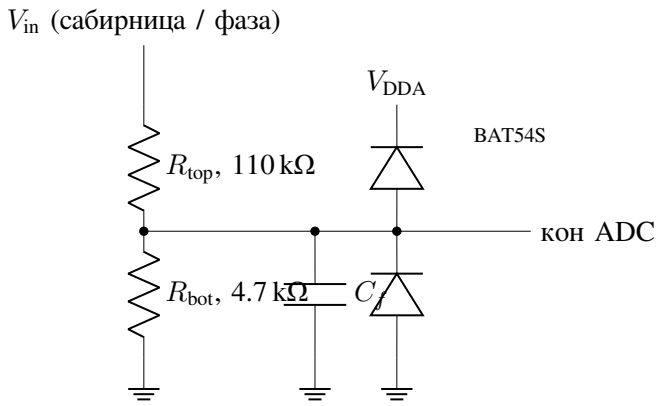
[picture p15: figure]
Vin (сабирница / фаза); Rtop, 110 kΩ; Rbot, 4.7 kΩ; VDDA; BAT54S; кон ADC

Сл. 4. Напонски разделник за мерење (сооднос 24.4), филтерски кондензатор од прв ред, и Schottky ограничувач кон VDDA/GND. Идентични мрежи ги опслужуваат DC-сабирницата (fc ≈ 1.6 kHz) и трите фазни јазли (fc ≈ 2–3 kHz за back-EMF).

на семплирање од 200 ns при читање на излезот од внатрешен op-amp [20], [21]. Компромисот околу баферот е сумиран во Табела IX; за тековните напонски канали со ниска стапка заклучокот е да се изостави баферот и да се користи подолго време на семплирање плюс филтерски кондензатор.

D. Филтрирање на сабирницата и фазите, и заштита
Кондензатор Cf паралелно со Rbot формира нископропусен филтер од прв ред со гранична фреквенција

fc =

1

2πRsrcCf

. | (34)

Канал на сабирницата: Cf = 22 nF дава fc = 1.6 kHz, што го отстранува склопното бранување (ripple) и шумот од бавното мерење на сабирницата. Фазни канали (back-EMF): филтерот мора да го отфрли PWM од 40 kHz додека ја пропушта основната хармоника на back-EMF. Електричната фреквенција е fe = RPM · p/60 (со p полови парови); изборот на fc ≈ 2–3 kHz го придушува носителот додека ја пропушта основната хармоника, по цена на фазно доцнење ϕ = arctan(fe/fc). Табела X го наведува ова доцнење; тоа е детерминистичко и се компензира во firmware (набљудувачот ја поместува семплираната фаза за ϕ). За безсензорска комутација базирана на премин низ нула, истото фиксно доцнење се коригира како временски офсет.
Заштита: за време на dead-time/спроведување на body-диода фазен јазол се ниша до ≈ −1 V, што разделникот го скалира на −1/24.4 = −41 mV на приклучокот на ADC — мало, но Schottky ограничувач (clamp, на пр. BAT54S) од јазолот на ADC кон земја и кон VDDA е додаден како осигурување против преодни појави над/под опсегот, при што долниот отпорник на разделникот ја ограничува струјата на ограничувачот. Истиот ограничувач штити од врвови на пренапон на каналот на сабирницата. Сл. 4 ги прикажува разделникот, филтерот и ограничувачот.

VIII. RC SNUBBER на склопниот јазол
A. Потекло на ѕвонењето (ringing)
При секое исклучување, паразитната индуктивност Lp на комутационата јамка (изводи на пакувањето, PCB траги, ESL на кондензаторот на сабирницата) резонира со излезната капацитивност на MOSFET Co (Coss на уредот плюс монтажната капацитивност), произведувајќи придушена осцилација на склопниот јазол на

fring =

1
2π

p
LpCo
, | (35)

вообичаено во десетици MHz. Ѕвонењето го оптоварува напонот на уредот, зрачи EMI и се спрегнува во сигналните линии. RC придушувачки snubber поставен паралелно со уредот додава отпорник Rs (на сериска врска со кондензатор Cs) кој ја дисипира резонантната енергија [22], [23].

B. Методологија на дизајн
Ригорозната постапка, независна од layout-от, го мери ѕвонењето на склопената плоча [22], [23]:
1) Измери го периодот на ѕвонење без snubber T1 = 1/fring на склопниот јазол.
2) Додај познат кондензатор Ctest паралелно со уредот и измери го новиот период T2.
3) Бидејќи T1 = 2π

p
LpCo и T2 = 2π

p
Lp(Co + Ctest), квадрирањето и одземањето го елиминира Lp:

Lp =

T

2
2 − T

2
1
4π

2 Ctest

, Co =

T

2
1
4π

2Lp

. | (36)

Придушувачкиот отпорник се поставува на карактеристичната импеданција на резонанцата,

Rs =

r
Lp
Co
, | (37)

што дава приближно критично придушување [23]. Snubber кондензаторот се избира неколку пати поголем од Co така што Rs да доминира во јамката, а сепак доволно мал за да се ограничи дисипацијата; моќноста на отпорникот е енергијата складирана во Cs, полнета и празнета еднаш по склопен циклус,

PRs = Cs V

2
bus fsw. | (38)
C. Проценети вредности (да се валидираат на тест-маса)
Сè уште не постои склопена плоча, па Lp не може да се измери; вредностите подолу се прва проценка само за избор на footprint и мора да се потврдат со методот со две мерења од (36) на прототипот. Од техничкиот лист на IPT015N10N5, Coss = 1800 pF (наведено при тест-условот од техничкиот лист; Coss силно зависи од напонот) [3], [4]; додавањето ≈ 200 pF монтажна капацитивност дава Co ≈ 2 nF. Земајќи репрезентативно Lp ≈ 10 nH за збиен layout,

fring =

1
2π

p
(10n)(2n)
= 35.6 MHz, | (39)

Rs =

r
10nH
2nF
= 2.24 Ω → 2.2 Ω (E12). | (40)

Со избор на Cs = 2.2 nF (≈ Co), дисипацијата во најлош случај (сабирница од 60 V) од (38) е
PRs = 2.2n × 60² × 40k = 0.32 W по snubber, | (41)

т.е. ≤ 1.9 W за сите шест прекинувачи ако секој footprint е монтиран (само 0.08 W по секој на сабирницата од 30 V). Се специфицира отпорник со ≥ 1 W за резерва.

D. Избор на компоненти
Cs мора да биде со C0G/NP0 диелектрик: Class-2 (X7R) керамиките губат поголем дел од својата капацитивност под DC bias и самозагреваат под високофреквентното бранување, додека C0G е без загуби и стабилен. Компонента со 2.2 nF, 100 V C0G е основната (компонента од 200 V дава дополнителна резерва против пречекорувањето од ѕвонење). Rs мора да биде неиндуктивен: SMD thin/thick-film чип (1206 или 2512), никогаш wirewound, така што неговата сопствена индуктивност да не го поништи snubber-от [22]. RC се поставува директно паралелно со drain–source на секој MOSFET со најкратка можна јамка. Според спецификацијата, сите шест RC места се поставени како do-not-populate (DNP) footprint-и: ако прототипот покаже прифатливо ѕвонење тие остануваат празни, а ако не, се монтираат користејќи ги вредностите измерени на тест-маса од (36)–(37). Сл. 5 ги прикажува поставувањето и ефектот.

склопен јазол
Q | Rs 2.2 Ω
| Cs 2.2 nF

DNP RC

t

v
без snubber

со snubber

Сл. 5. DNP RC snubber паралелно со секој прекинувач и квалитативниот ефект врз ѕвонењето на склопниот јазол: придушувачкиот отпорник Rs =

√
Lp/Co ја отстранува резонантната енергија. Прикажаните вредности се први проценки што треба да се заменат со измерени на тест-маса преку (36).

IX. Стратегија за шум и филтрирање Филтрирањето се применува на секоја точка каде што се генерира чувствителен аналоген сигнал или каде што се инјектира склопен шум:
- Излез на CSA (Дел VI-D): лесен RC од 723 kHz (100 Ω/2.2 nF) по фаза, потпирајќи се на синхроно семплирање наместо на anti-alias филтер што внесува доцнење [20].
- Влез на CSA: сите влезни сериски отпорници мора да бидат совпаднати меѓу IN+ и IN– за да се зачува CMRR; enhanced PWM rejection на INA240 е примарната одбрана против CM преодната појава, па тежок влезен филтер намерно се избегнува [18].
- Разделник на сабирницата: RC од 1.6 kHz (Дел VII-D).
- Фазни разделници: RC од 2–3 kHz со компензација на фазното доцнење во firmware, плюс Schottky ограничувачи.
- Аналогно напојување: ferrite bead меѓу VDD и VDDA со декуплирање 1 µF + 100 nF на VDDA; посебно 1 µF + 100 nF на VREF+, и декуплирањето на VREFBUF специфицирано од ST ако се користи внатрешната референца [1].
- Напојување на INA240: 100 nF + 1 µF поставени на приклучокот.
- Декуплирање на DC-сабирницата: керамики со ниска ESL паралелно со bulk електролитите, блиску до секој half-bridge, за да се минимизира индуктивноста на комутационата јамка Lp — ова го напаѓа изворот на ѕвонењето што snubber-от инаку мора да го придушува [22].
- Заземјување/layout: единствен (star) спој меѓу аналогната земја (AGND) и енергетската земја (PGND); Kelvin мерење на shunt-от; кратки, тесно спрегнати диференцијални сигнални траги; и компактна склопна јамка. Овие мерки во layout-от се исто толку важни колку и филтрите со компоненти за инвертор со 40 kHz и >100 A.
X. Спецификација на материјали (BOM) Спецификацијата на материјали се состои од два дела што се надополнуваат: пасивните помошни компоненти за управување на гејтот, веќе наведени по гранка и по плоча во Табела VII, и компонентите на аналогниот влезен степен со LCSC нарачкини броеви, дадени во Табела XI. Активните уреди се 12× IPT015N10N5 (четири по гранка, нарачкин број LCSC C108964) и 3× UCC27211A-Q1 (по еден на фаза), заедно со 3× INA240A2 (C129949) за мерење на струја.
Активните уреди (INA240A2PWR, IPT015N10N5) и стандардните чип отпорници/кондензатори се производи со голем обем што рутински имаат залиха далеку над 500 единици; единствената компонента што треба да се потврди при пуштање на нарачката е shunt-от со голема моќност, за кој е дадена алтернатива составена од два крајно вообичаени 0.2 mΩ 2512 елементи паралелно (= 0.1 mΩ, ≈ 0.93 W по секој). Количините претпоставуваат една трифазна плоча; snubber компонентите се DNP (само footprint-и).

Референци

[1] STMicroelectronics, “STM32G473xB/xC/xE datasheet (DS12712),” ревизија 5, 2023. [Онлајн]. Достапно на: https://www.st.com/resource/en/datasheet/stm32g473cb.pdf (https://www.st.com/resource/en/datasheet/stm32g473cb.pdf)
[2] Texas Instruments, “UCC27211A-Q1 Automotive 120-V, 3.7-A/4.5-A half-bridge driver with 8-V UVLO,” datasheet SLUSCG0C, Dec. 2015 — rev. Sep. 2025. [Онлајн]. Достапно на: https://www.ti.com/lit/ds/symlink/ucc27211a-q1.pdf

ТАБЕЛА XI
Спецификација на материјали за аналогниот влезен степен. Залихата се менува; потврди при пуштање на нарачката.
Функција | Кол. | Компонента | /
вредност

Клучен
номинал
LCSC | Забелешка
Струен засилувач | 3 | TI INA240A2PWR | G=50, −4..80 V
CM
C129949 | по | еден | на
фаза [25]
Фазен shunt | 3 | 0.1 mΩ | метален
елемент, 5 W

≤ 2 nH ESL,
Kelvin
потврди | на пр. Milliohm
6.6×6.6 mm; види
алт. подолу [27]
(алтернатива за
shunt)
6 | 0.2 mΩ 2512 ×2 ∥ | 2 W по сек. | голема
залиха

крајно
вообичаени;
= 0.1 mΩ
Излезен филтер R на
CSA
3 | 100 Ω 0603 1% | — | голема
залиха

со Cf

Излезен филтер C на
CSA
3 | 2.2 nF C0G 0603 | 50 V | голема
залиха

fc 723 kHz

Горен | дел | на
разделник
4(8) | 110 kΩ | (2×55 kΩ)
0805 1%
≥ 150 V | голема
залиха

сабирница + 3
фази
Долен | дел | на
разделник
4 | 4.7 kΩ 0603 1% | — | голема
залиха

сооднос 24.4

Филтер кондензатор
на сабирница
1 | 22 nF C0G/X7R 0603 | 50 V | голема
залиха

fc 1.6 kHz

Филтер кондензатор
на фаза
3 | 22 nF 0603 | 50 V | голема
залиха

fc ≈ 2.5 kHz

Ограничувачка
диода на ADC
4 | BAT54S | двојна
Schottky
30 V | голема
залиха

кон VDDA/GND

Snubber R (DNP) | 6 | 2.2 Ω 1206 неинд., ≥ 1 W
— | голема
залиха

само footprint

Snubber C (DNP) | 6 | 2.2 nF C0G 1206 | 100 V | (200 V
| | | опц.)

голема
залиха

само footprint

Ferrite | bead | на
VDDA | 1 | 600 Ω@100 MHz
| | 0805
— | голема
залиха

VDD→VDDA

Сет за декуплирање | — | 100 nF/1 µF 0402/0603
16 V+ | голема
залиха

CSA, VDDA,
VREF
Енергетски MOSFET (реф.) | 12 | Infineon IPT015N10N5
100 V/300 A/1.5 mΩ C108964 | енергетски
степен, | 4 | по
гранка [26]
[3] Infineon Technologies, “IPT015N10N5 OptiMOS™ 5 100 V power transistor,” final data sheet, ревизија 2.4, 2023. [Онлајн]. Достапно на: https://www.infineon.com/assets/row/public/documents/24/49/infineon-ipt015n10n5-datasheet-en.pdf
[4] Infineon Technologies, “IPT015N10N5 product page” (страница на производот, параметарски преглед; Coss = 1800 pF, 100 V, 300 A). [Онлајн]. Достапно на: https://www.infineon.com/part/IPT015N10N5
[5] onsemi, “Trapezoidal control of BLDC motors,” технички блог. [Онлајн]. Достапно на: https://www.onsemi.com/company/news-media/blog/industrial/en-us/trapezoidal-control-of-bldc-motors (https://www.onsemi.com/company/news-media/blog/industrial/en-us/trapezoidal-control-of-bldc-motors)
[6] NXP Semiconductors, “3-phase BLDC motor control with sensorless back-EMF zero-crossing detection,” апликациона белешка AN1913. [Онлајн]. Достапно на: https://www.nxp.com/docs/en/application-note/AN1913.pdf
[7] L. Balogh, “Fundamentals of MOSFET and IGBT gate driver circuits,” Texas Instruments application report SLUA618A (ревизија на SLUP169), 2017–2018. [Онлајн]. Достапно на: https://www.ti.com/lit/ml/slua618/slua618.pdf
[8] Infineon Technologies, “Using monolithic high-voltage gate drivers” (димензионирање на bootstrap, отпорници на гејтот и насоки за полумост; наследник на IR белешките AN-978/AN-1123), апликациона белешка. [Онлајн]. Достапно на: https://www.infineon.com/assets/row/public/documents/24/42/infineon-using-monolithic-high-voltage-gate-drivers-applicationnotes-en.pdf (https://www.infineon.com/assets/row/public/documents/24/42/infineon-using-monolithic-high-voltage-gate-drivers-applicationnotes-en.pdf)
[9] Infineon Technologies, “Bootstrap circuits — overview and selection guide,” Knowledge Base статија. [Онлајн]. Достапно на: https: //community.infineon.com/t5/Knowledge-Base-Articles/Bootstrap-circuits-overview-and-selection-guide/ta-p/720580

[10] Texas Instruments, “UCC27211A product folder.” [Онлајн]. Достапно на: https://www.ti.com/product/UCC27211A
[11] Infineon Technologies, “A typical calculation of a bootstrap capacitor’s value,” Knowledge Base статија. [Онлајн]. Достапно на: https: //community.infineon.com/t5/Knowledge-Base-Articles/A-typical-calculation-of-a-bootstrap-capacitor-s-value/ta-p/739554
[12] Infineon | Technologies, | “Calculating | maximum | bootstrap | capacitance | for | integrated-diode | gate | drivers,”
Knowledge | Base | статија. | [Онлајн]. | Достапно | на: | https://community.infineon.com/t5/Knowledge-Base-Articles/
Calculating-maximum-bootstrap-capacitance-for-integrated-diode-gate-drivers/ta-p/1015593 (https://community.infineon.com/t5/Knowledge-Base-Articles/Calculating-maximum-bootstrap-capacitance-for-integrated-diode-gate-drivers/ta-p/1015593)
[13] Nexperia, “PMEG4030ER — 40 V, 3 A low-VF Schottky barrier rectifier,” технички лист, 2023. [Онлајн]. Достапно на: https://assets.nexperia.com/documents/data-sheet/PMEG4030ER.pdf (https://assets.nexperia.com/documents/data-sheet/PMEG4030ER.pdf)
[14] Nexperia, “Power MOSFET gate driver fundamentals,” апликациона белешка AN90059, 2025. [Онлајн]. Достапно на: https://assets.nexperia.com/documents/application-note/AN90059.pdf (https://assets.nexperia.com/documents/application-note/AN90059.pdf)
[15] Toshiba Electronic Devices & Storage, “Impacts of the dv/dt rate on MOSFETs,” апликациона белешка, 2018. [Онлајн]. Достапно на: https://toshiba.semicon-storage.com/info/docget.jsp?did=59464
[16] Texas Instruments, “Low-drift, low-side current measurements for three-phase systems,” апликациона белешка (од документацијата на INA240). [Онлајн]. Достапно на: https://www.ti.com/product/INA240
[17] Texas Instruments, “TIDA-00913: 48-V/10-A three-phase inverter with in-line shunt-based phase current sensing reference design.” [Онлајн]. Достапно на: https://www.ti.com/tool/TIDA-00913
[18] Texas Instruments, “INA240 −4 V to 80 V, bidirectional, ultra-precise current-sense amplifier with enhanced PWM rejection (SBOS662),” технички лист. [Онлајн]. Достапно на: https://www.ti.com/lit/gpn/INA240
[19] STMicroelectronics, “AN2834: How to get the best ADC accuracy in STM32 microcontrollers.” [Онлајн]. Достапно на: https://www.st.com/resource/en/application_note/an2834-how-to-get-the-best-adc-accuracy-in-stm32-microcontrollers-stmicroelectronics.pdf (https://www.st.com/resource/en/application_note/an2834-how-to-get-the-best-adc-accuracy-in-stm32-microcontrollers-stmicroelectronics.pdf)
[20] STMicroelectronics, “AN5346: STM32G4 ADC use tips and recommendations.” [Онлајн]. Достапно на: https://www.st.com/resource/en/application_note/an5346-stm32g4-adc-use-tips-and-recommendations-stmicroelectronics.pdf (https://www.st.com/resource/en/application_note/an5346-stm32g4-adc-use-tips-and-recommendations-stmicroelectronics.pdf)
[21] STMicroelectronics, “AN5306: Operational amplifier (OPAMP) usage in STM32G4 Series.” [Онлајн]. Достапно на: https://www.st.com/resource/en/application_note/an5306-operational-amplifier-opamp-usage-in-stm32g4-series-stmicroelectronics.pdf (https://www.st.com/resource/en/application_note/an5306-operational-amplifier-opamp-usage-in-stm32g4-series-stmicroelectronics.pdf)
[22] R. Severns, “Design of snubbers for power circuits,” Cornell Dubilier апликациона белешка. [Онлајн]. Достапно на: https://www.cde.com/resources/technical-papers/design.pdf (https://www.cde.com/resources/technical-papers/design.pdf)
[23] DigiKey, “Resistor-capacitor (RC) snubber design for power switches,” технички напис. [Онлајн]. Достапно на: https://www.digikey.com/en/articles/resistor-capacitor-rc-snubber-design-for-power-switches (https://www.digikey.com/en/articles/resistor-capacitor-rc-snubber-design-for-power-switches)
[24] LCSC Electronics, почетна страница на дистрибутер (560 000+ SKU, 2600+ производители). [Онлајн]. Достапно на: https://www.lcsc.com/
[25] LCSC Electronics, “INA240A2PWR (C129949).” [Онлајн]. Достапно на: https://www.lcsc.com/product-detail/C129949.html
[26] LCSC Electronics, “IPT015N10N5 (C108964).” [Онлајн]. Достапно на: https://www.lcsc.com/product-detail/C108964.html
[27] LCSC Electronics, “Категорија: current sense / shunt отпорници.” [Онлајн]. Достапно на: https://www.lcsc.com/products/Current-Sense-Resistors-Shunt-Resistors_909.html (https://www.lcsc.com/products/Current-Sense-Resistors-Shunt-Resistors_909.html)
