bvrny/Vortex/CAD-VECTOR/8mm_terminal_conn-Body.step

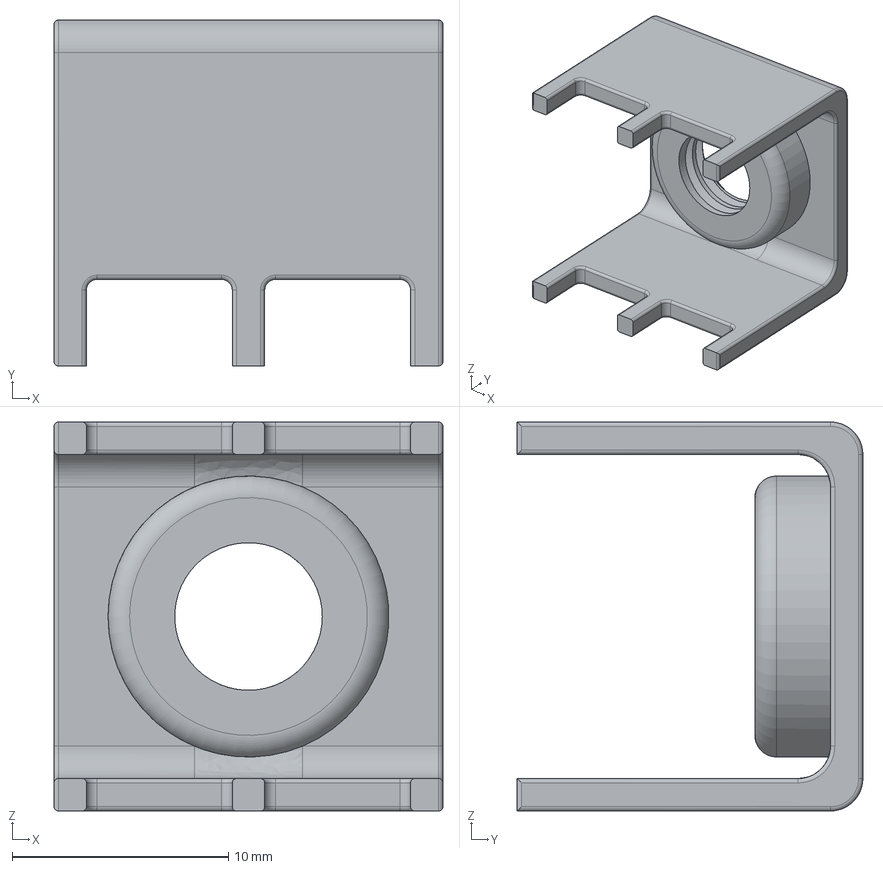
[picture p16: CAD file, 2026-07-16]
CAD-VECTOR/8mm_terminal_conn-Body.step
18.0 x 16.0 x 18.0 mm
