bvrny/Vortex/(list of files, cad)

Other CAD files:
CAD-VECTOR/8mm_terminal_conn.FCStd
