bvrny/Vortex/PCBA-VECTOR-01A/Schematic/PCBA-VECTOR-01A.pdf

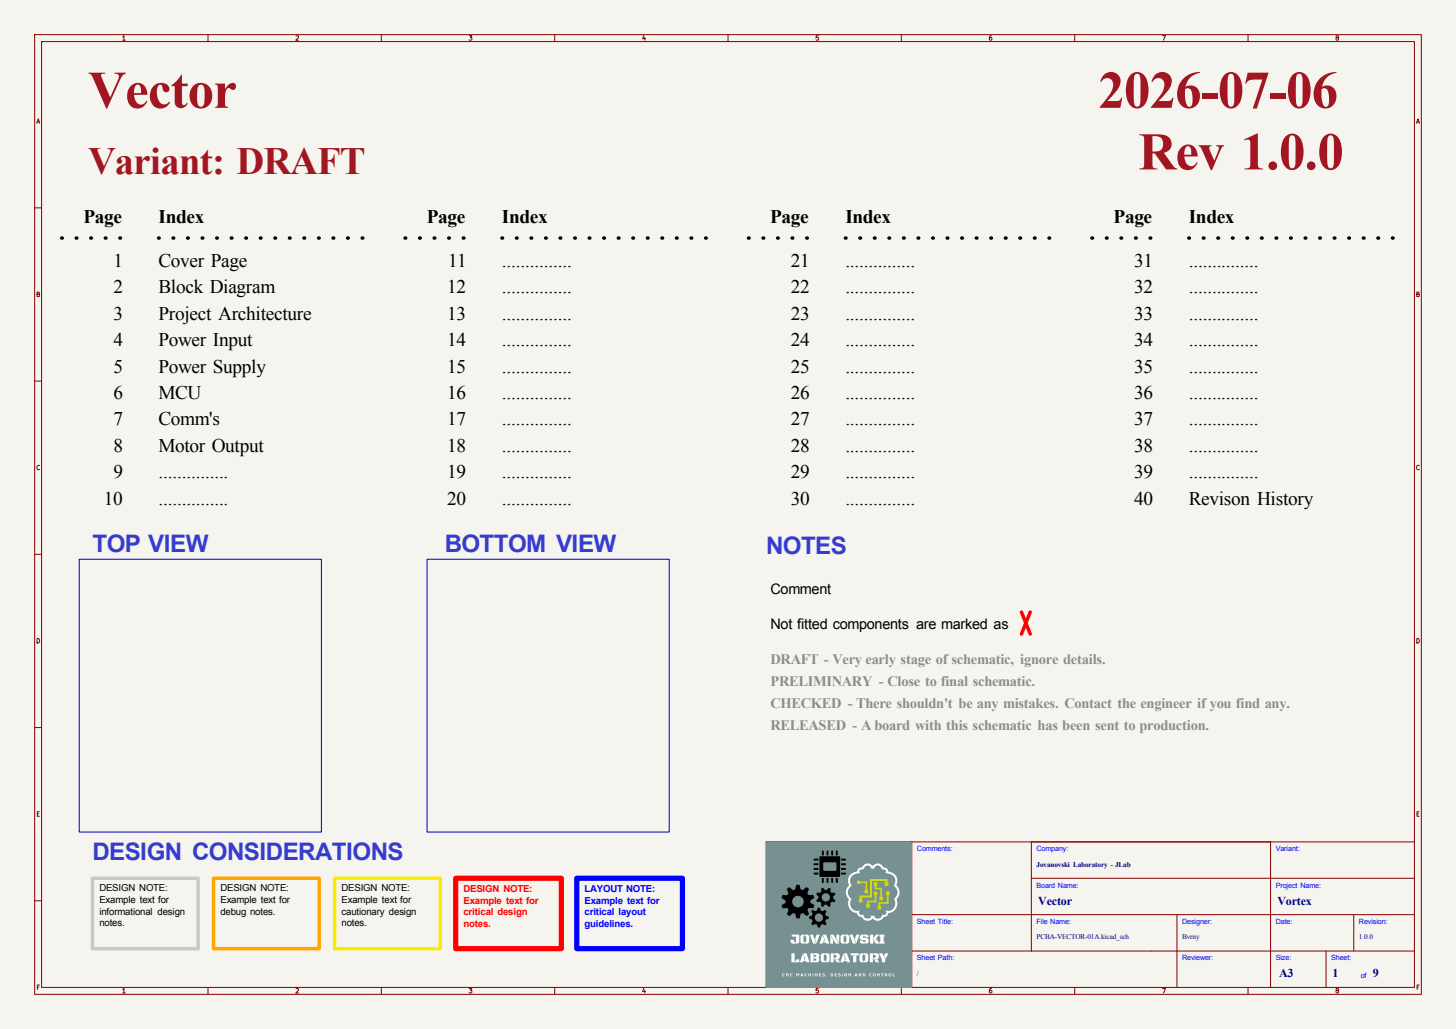
[picture p17: page 1]

DRAFT - Very early stage of schematic, ignore details.
PRELIMINARY - Close to final schematic.
CHECKED - There shouldn't be any mistakes. Contact the engineer if you find any.
RELEASED - A board with this schematic has been sent to production.

Revision: 1.0.0 Date: Project Name: Reviewer: Designer:

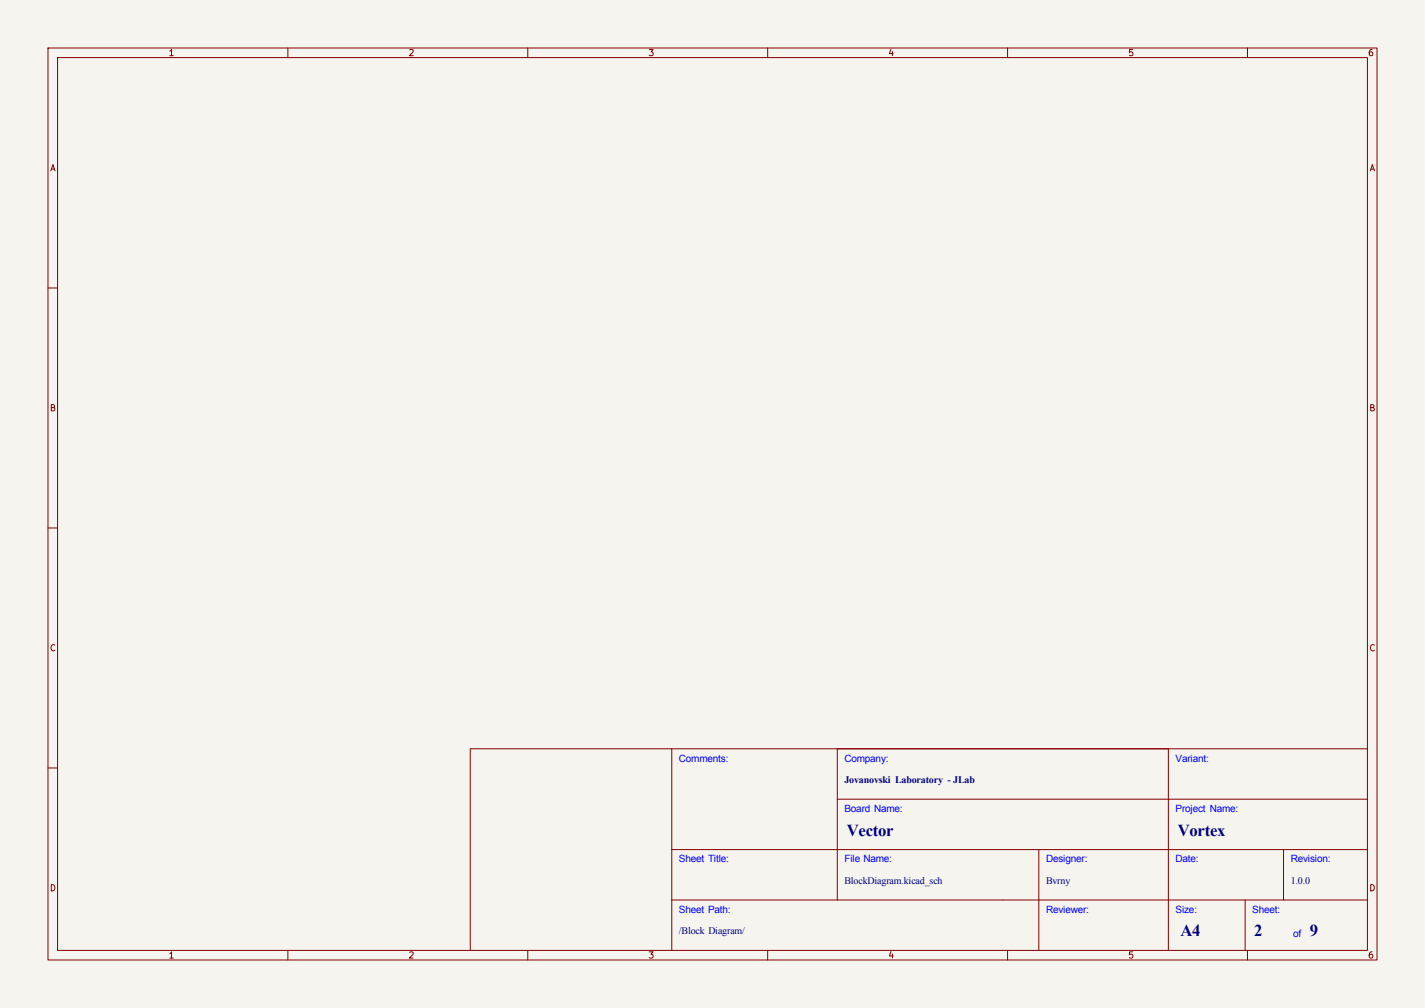
[picture p18: page 2]

/Block Diagram/ Sheet Path: Comments:

Revision: 1.0.0 Date: Project Name: Reviewer: Designer:

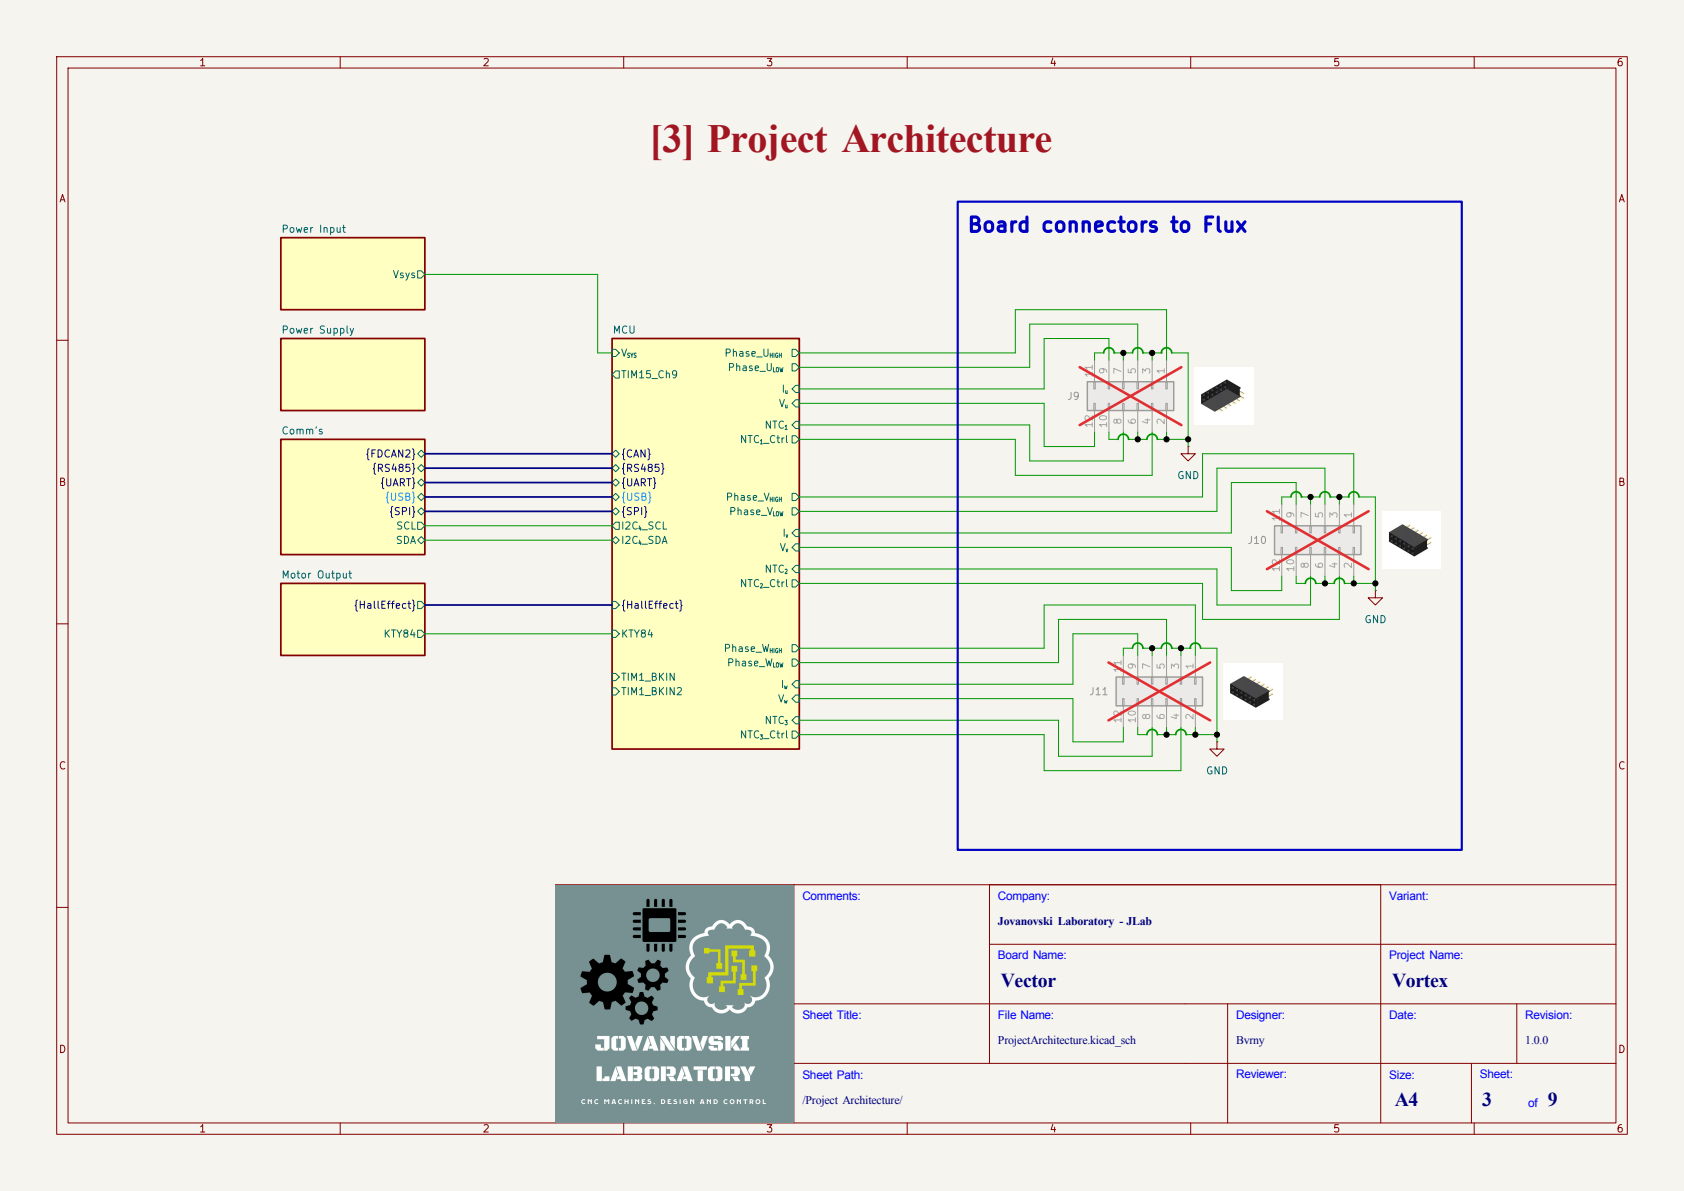
[picture p19: page 3]

Board connectors to Flux

/Project Architecture/ Sheet Path: Comments:

Revision: 1.0.0 Date: Project Name: Reviewer: Designer:

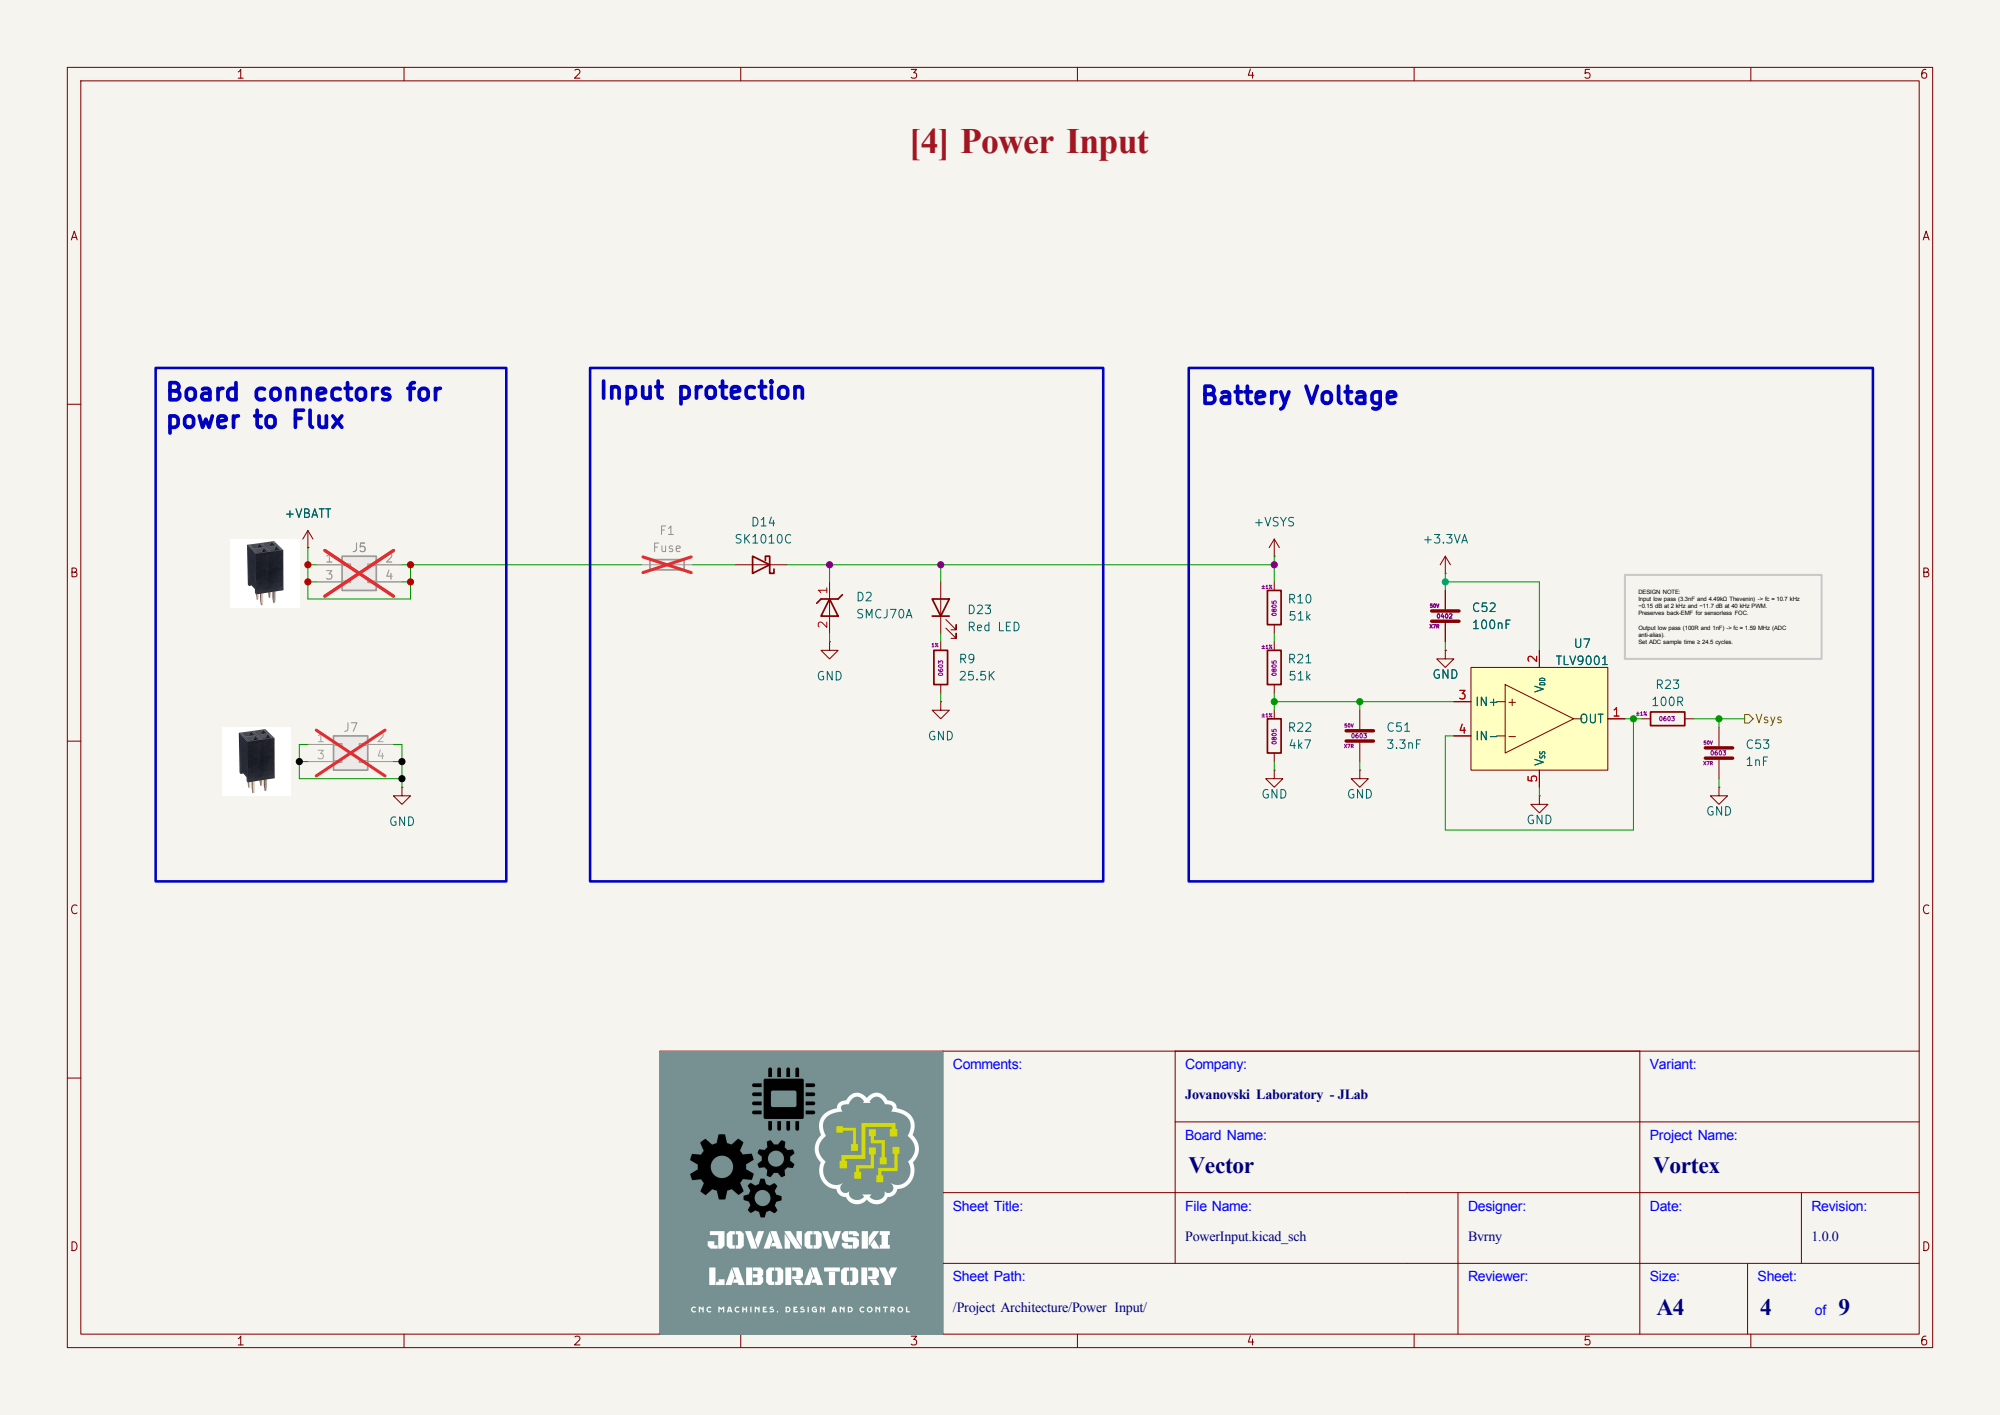
[picture p20: page 4]

anti-alias). Set ADC sample time ≥ 24.5 cycles. [4] Power Input

DESIGN NOTE:
Input low pass (3.3nF and 4.49kΩ Thevenin) -> fc = 10.7 kHz −0.15 dB at 2 kHz and −11.7 dB at 40 kHz PWM. Preserves back-EMF for sensorless FOC. Output low pass (100R and 1nF) -> fc ≈ 1.59 MHz (ADC

Revision: 1.0.0 Date: Project Name: Reviewer: Designer:

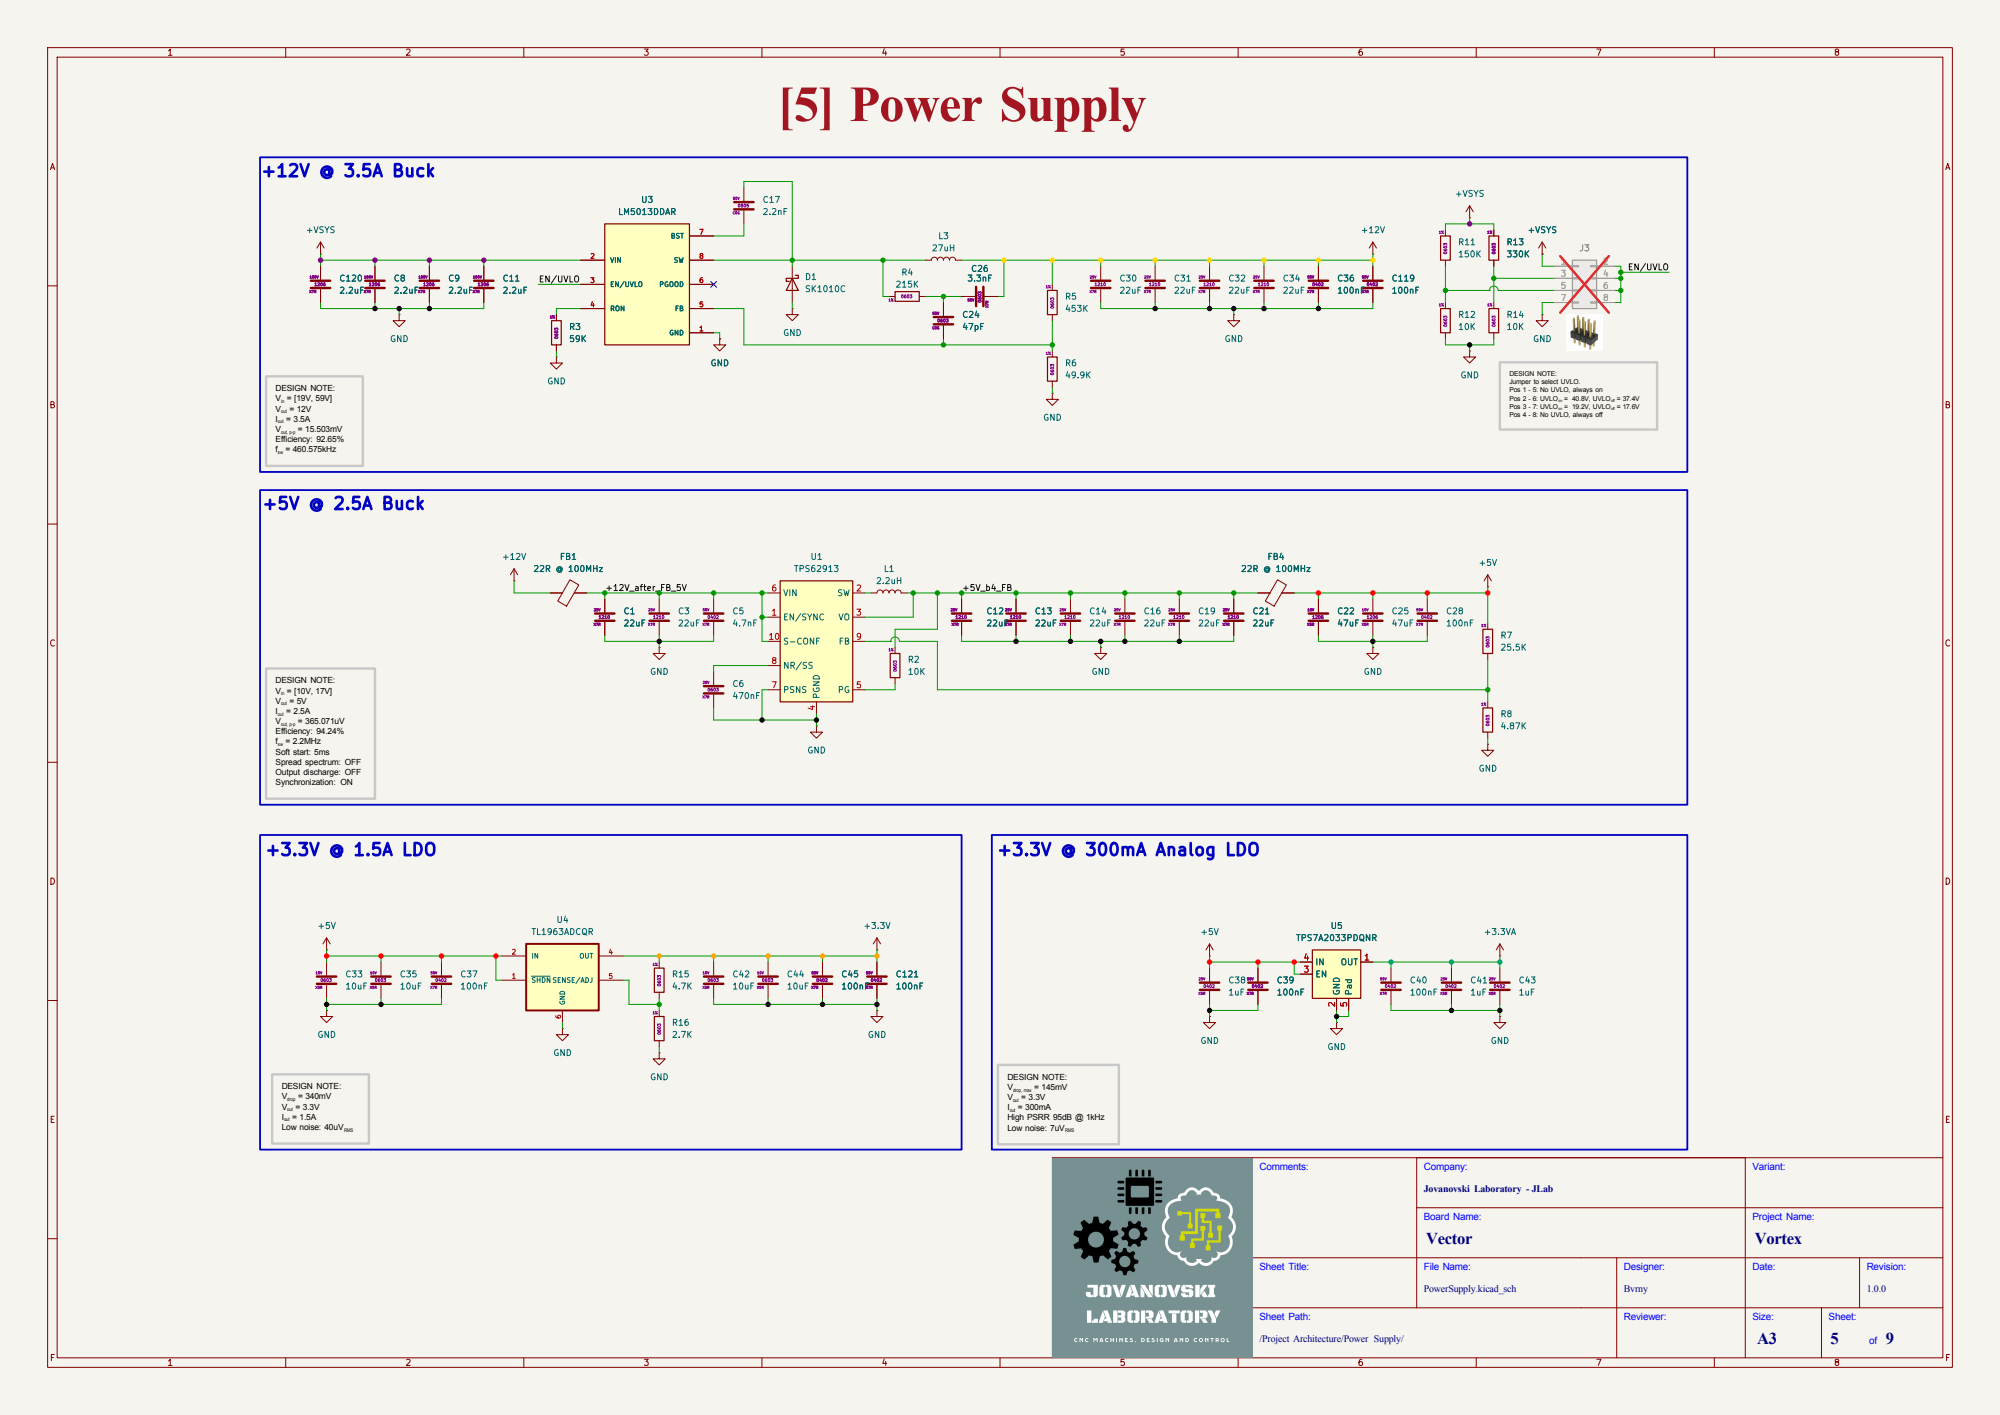
[picture p21: page 5]

DESIGN NOTE: Vin = [19V, 59V] Vout = 12V

Pos 3 - 7: UVLOon = 19.2V, UVLOoff = 17.6V
Pos 4 - 8: No UVLO, always off

VIN 6 PSNS 7 NR/SS 8 | 0402

DESIGN NOTE: Vin = [10V, 17V] Vout = 5V

Iout = 2.5A
Vout, p-p = 365.071uV
Efficiency: 94.24%
fsw = 2.2MHz Soft start: 5ms Spread spectrum: OFF Output discharge: OFF Synchronization: ON

DESIGN NOTE: Vdrop, max = 145mV

Vout = 3.3V
Iout = 300mA High PSRR 95dB @ 1kHz Low noise: 7uVRMS

/Project Architecture/Power Supply/ Sheet Path: Comments:

Revision: 1.0.0 Date: Project Name: Reviewer: Designer:

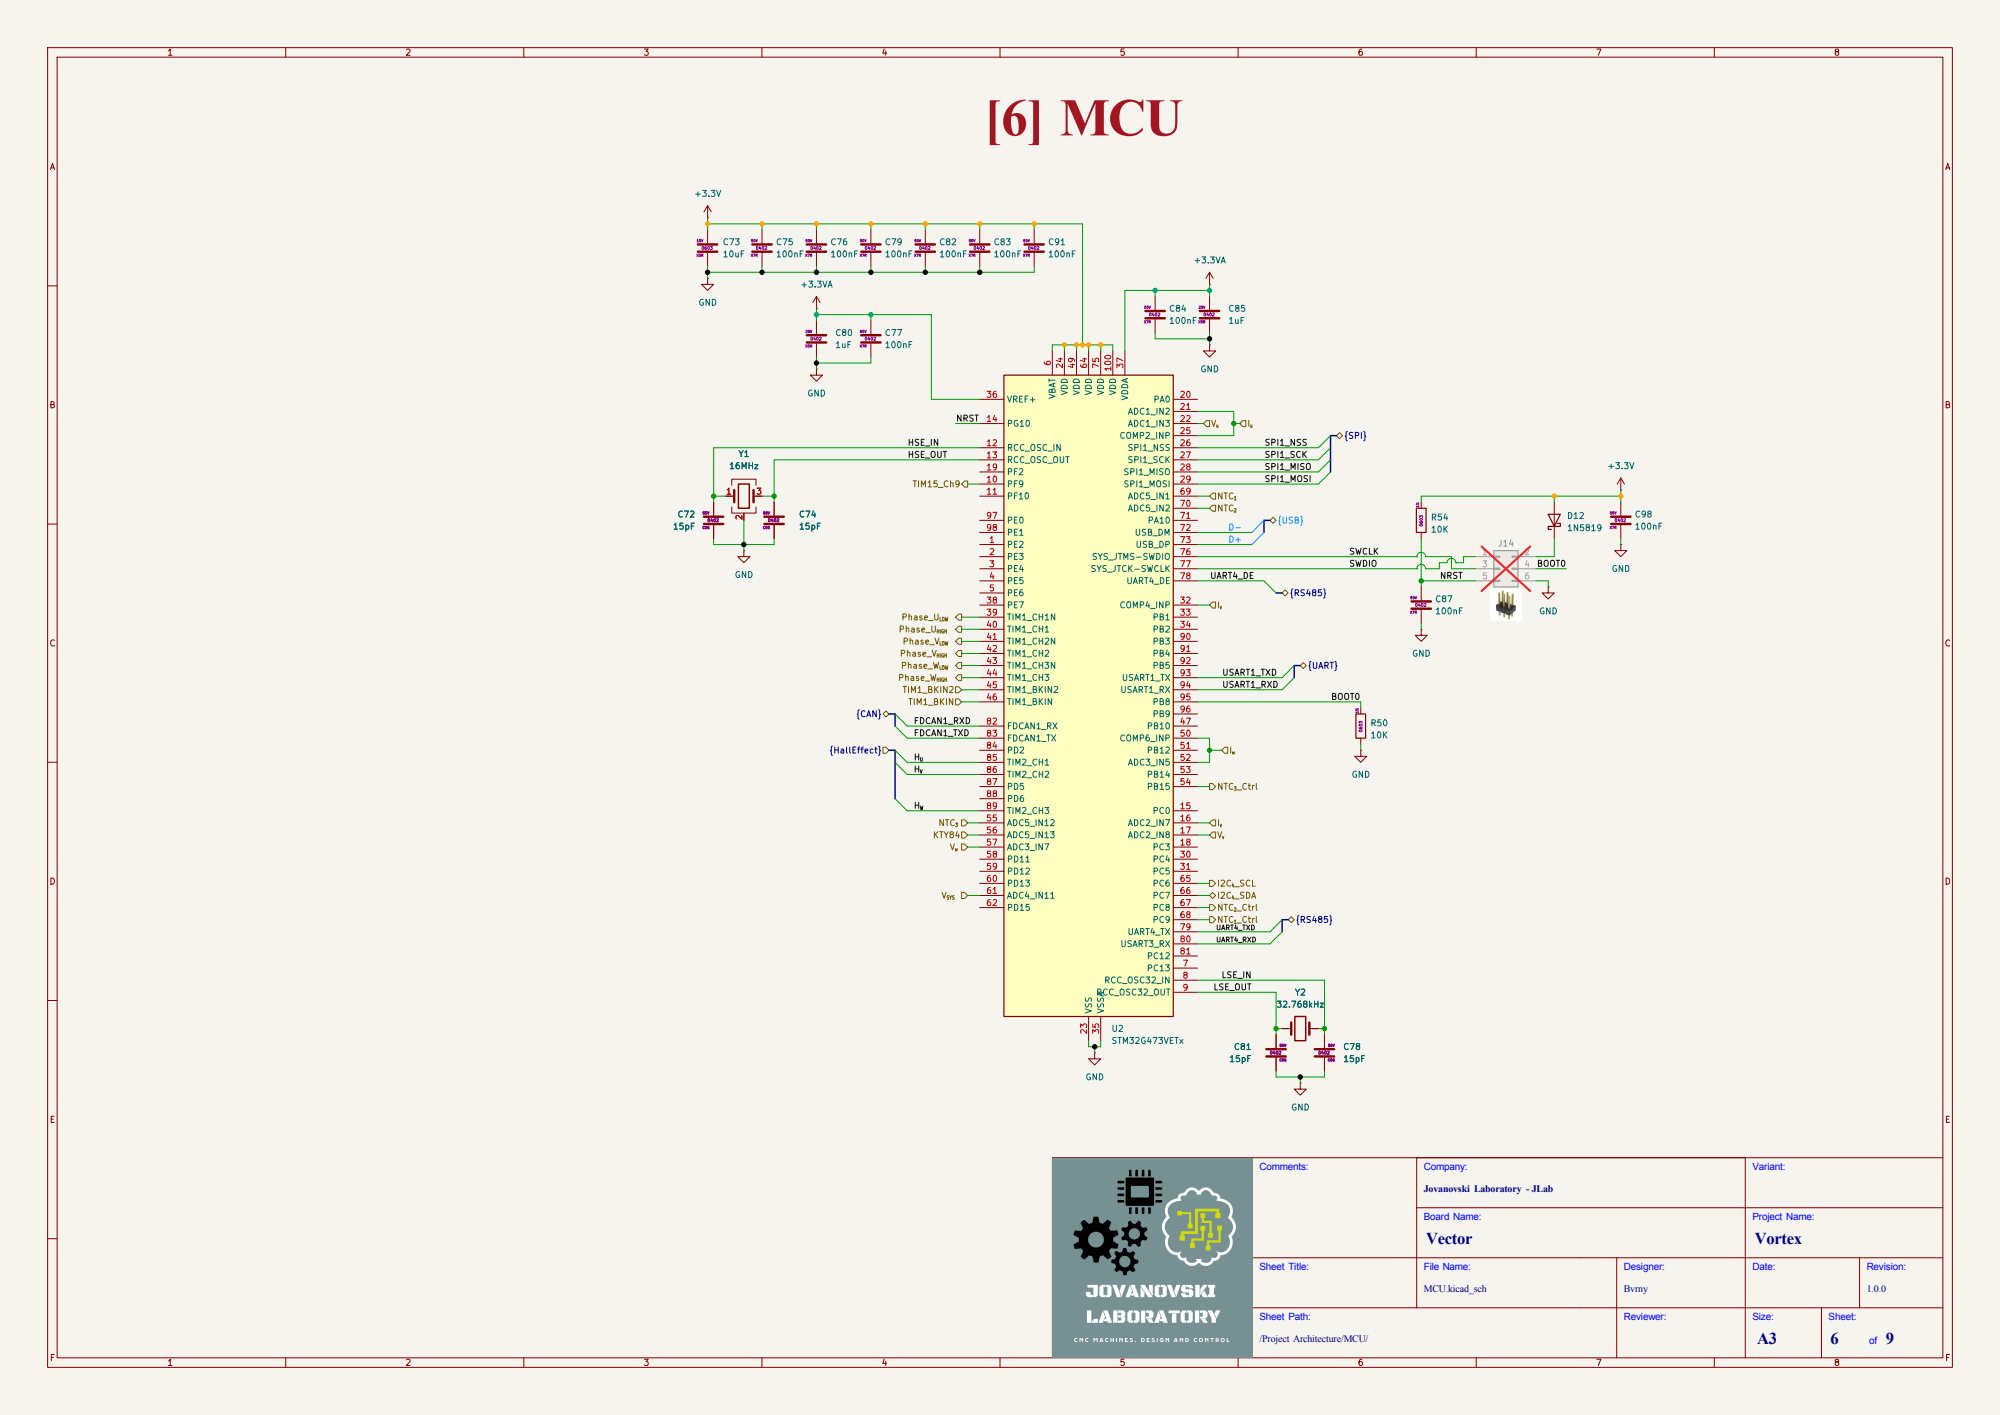
[picture p22: page 6]

/Project Architecture/MCU/ Sheet Path: Comments:

Revision: 1.0.0 Date: Project Name: Reviewer: Designer:

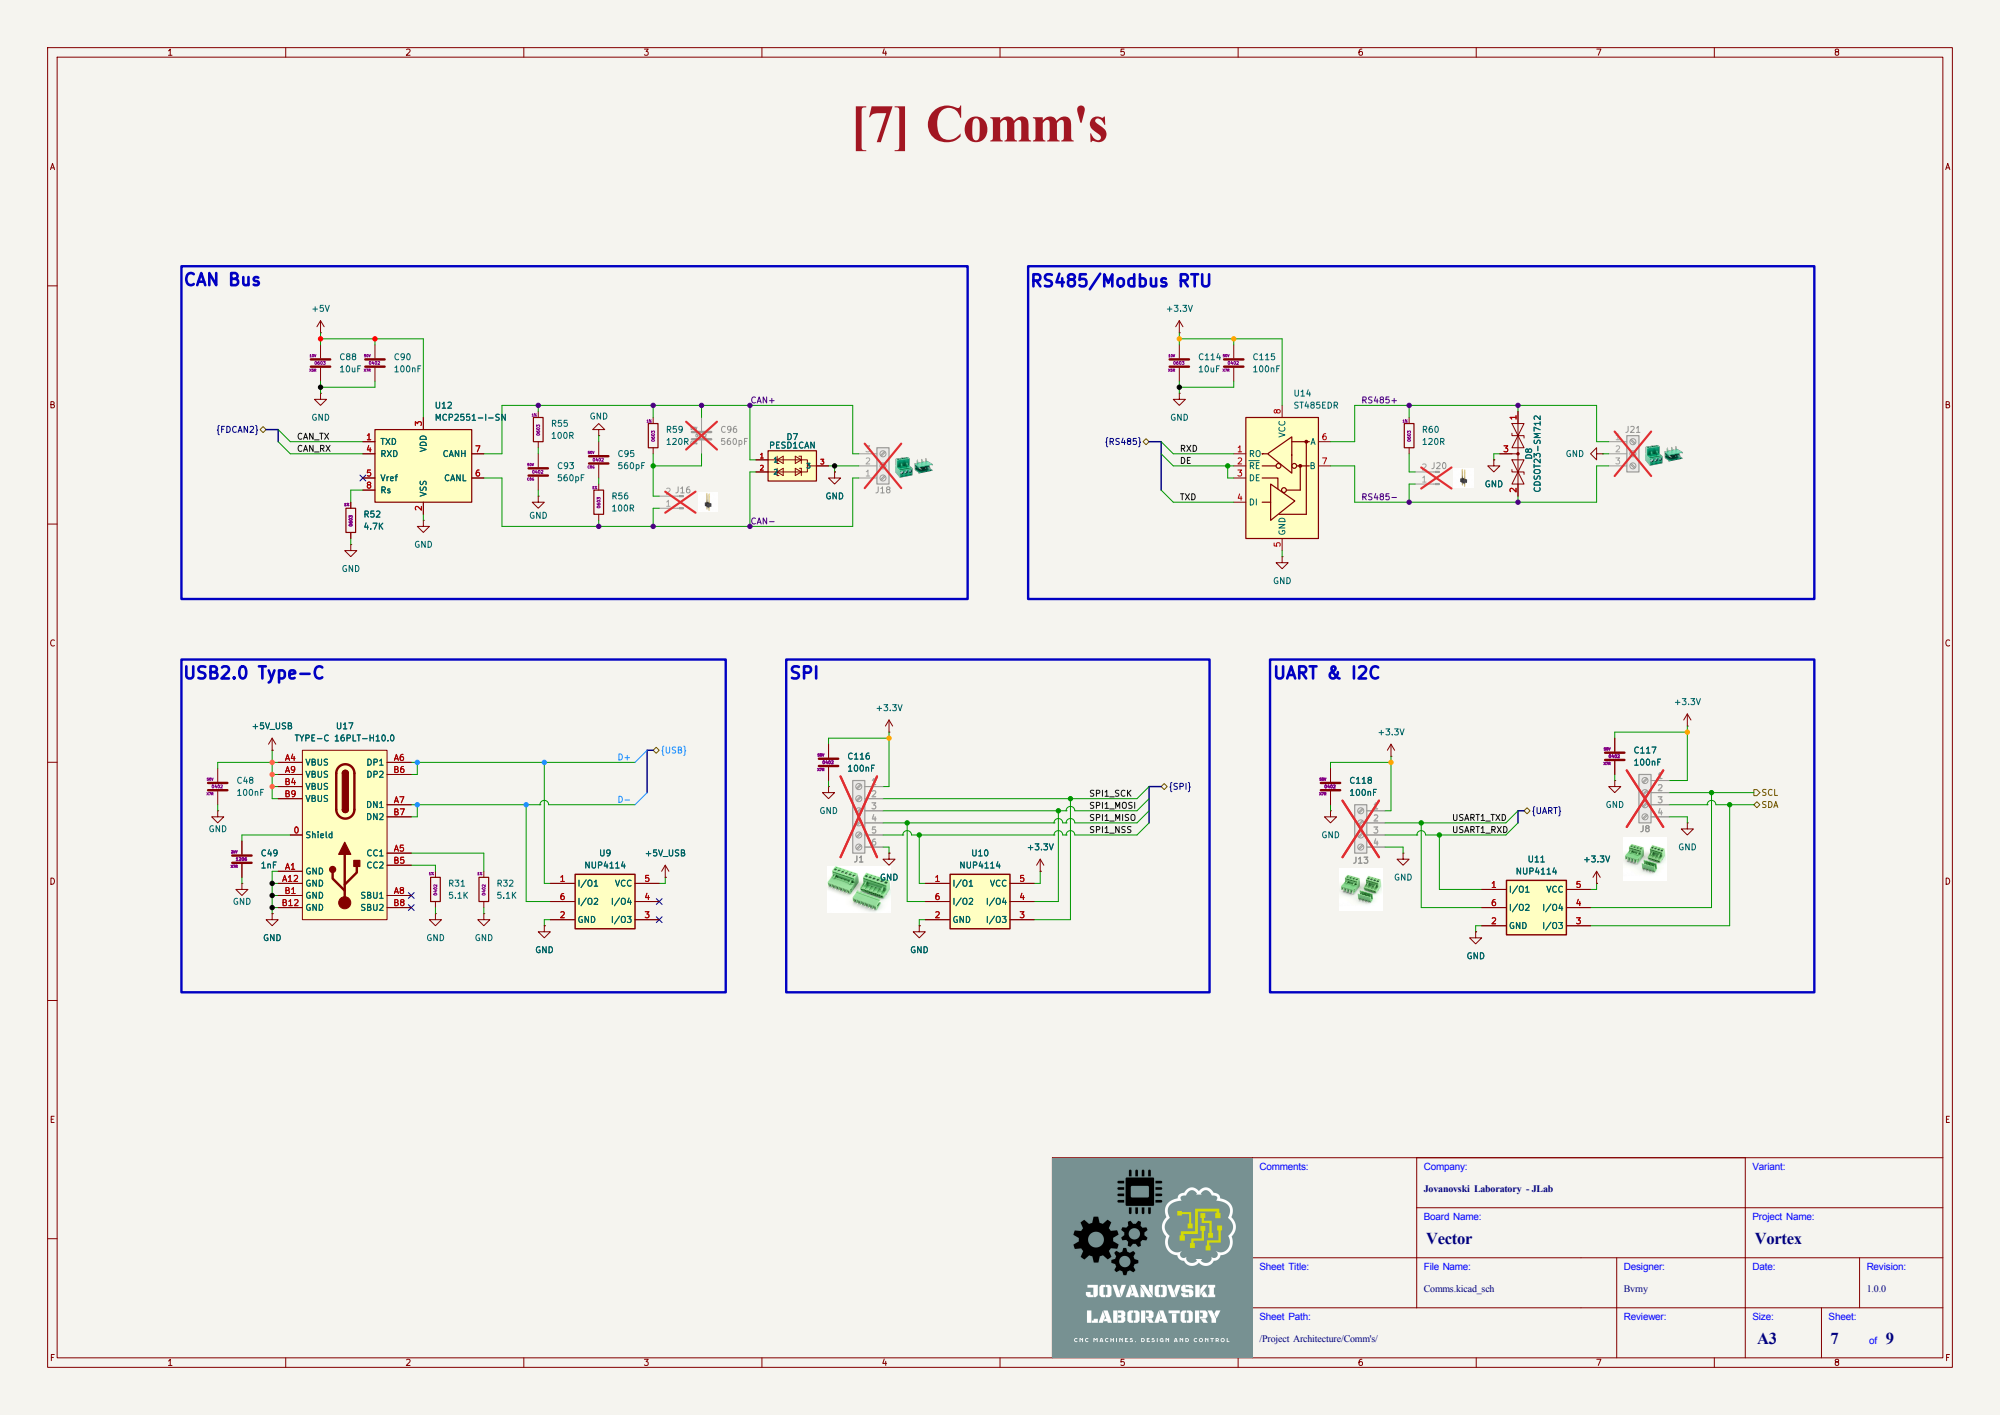
[picture p23: page 7]

/Project Architecture/Comm's/ Sheet Path: Comments:

Revision: 1.0.0 Date: Project Name: Reviewer: Designer:

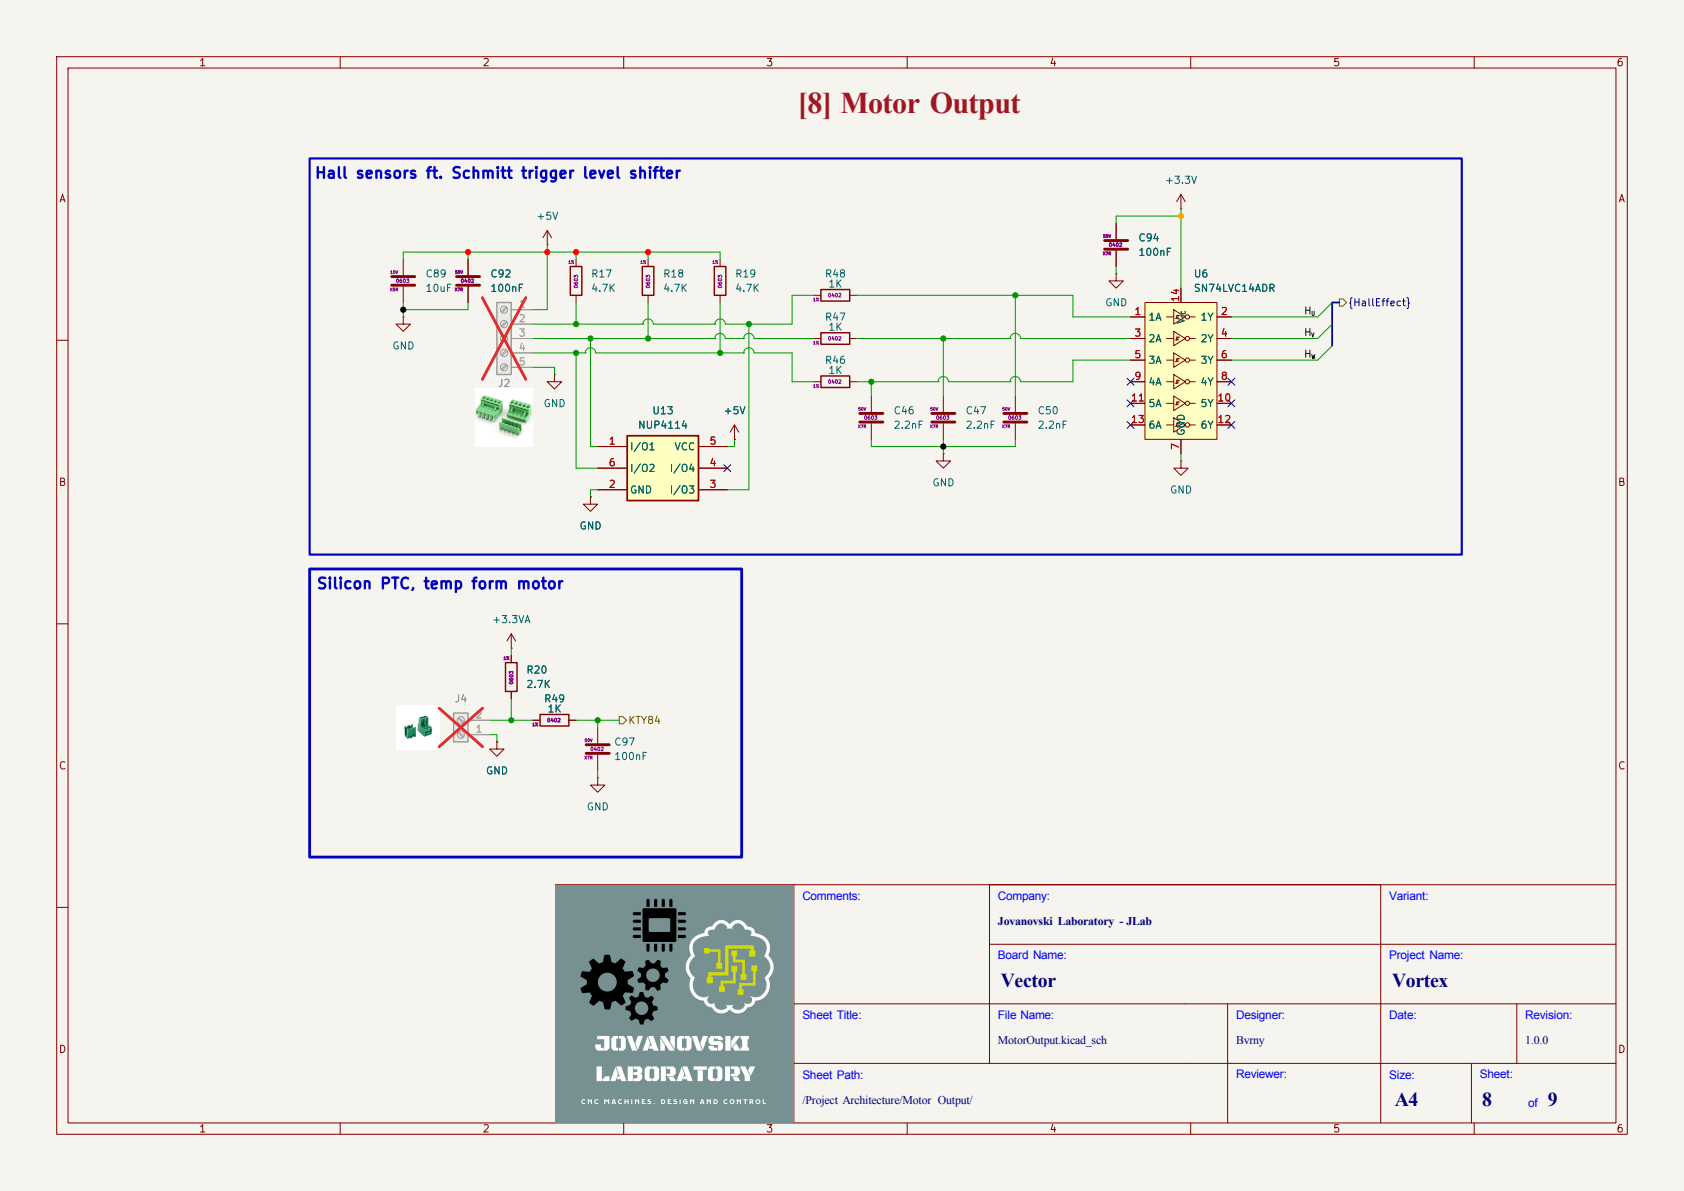
[picture p24: page 8]

Hall sensors ft. Schmitt trigger level shifter

Silicon PTC, temp form motor

/Project Architecture/Motor Output/ Sheet Path: Comments:

Revision: 1.0.0 Date: Project Name: Reviewer: Designer:

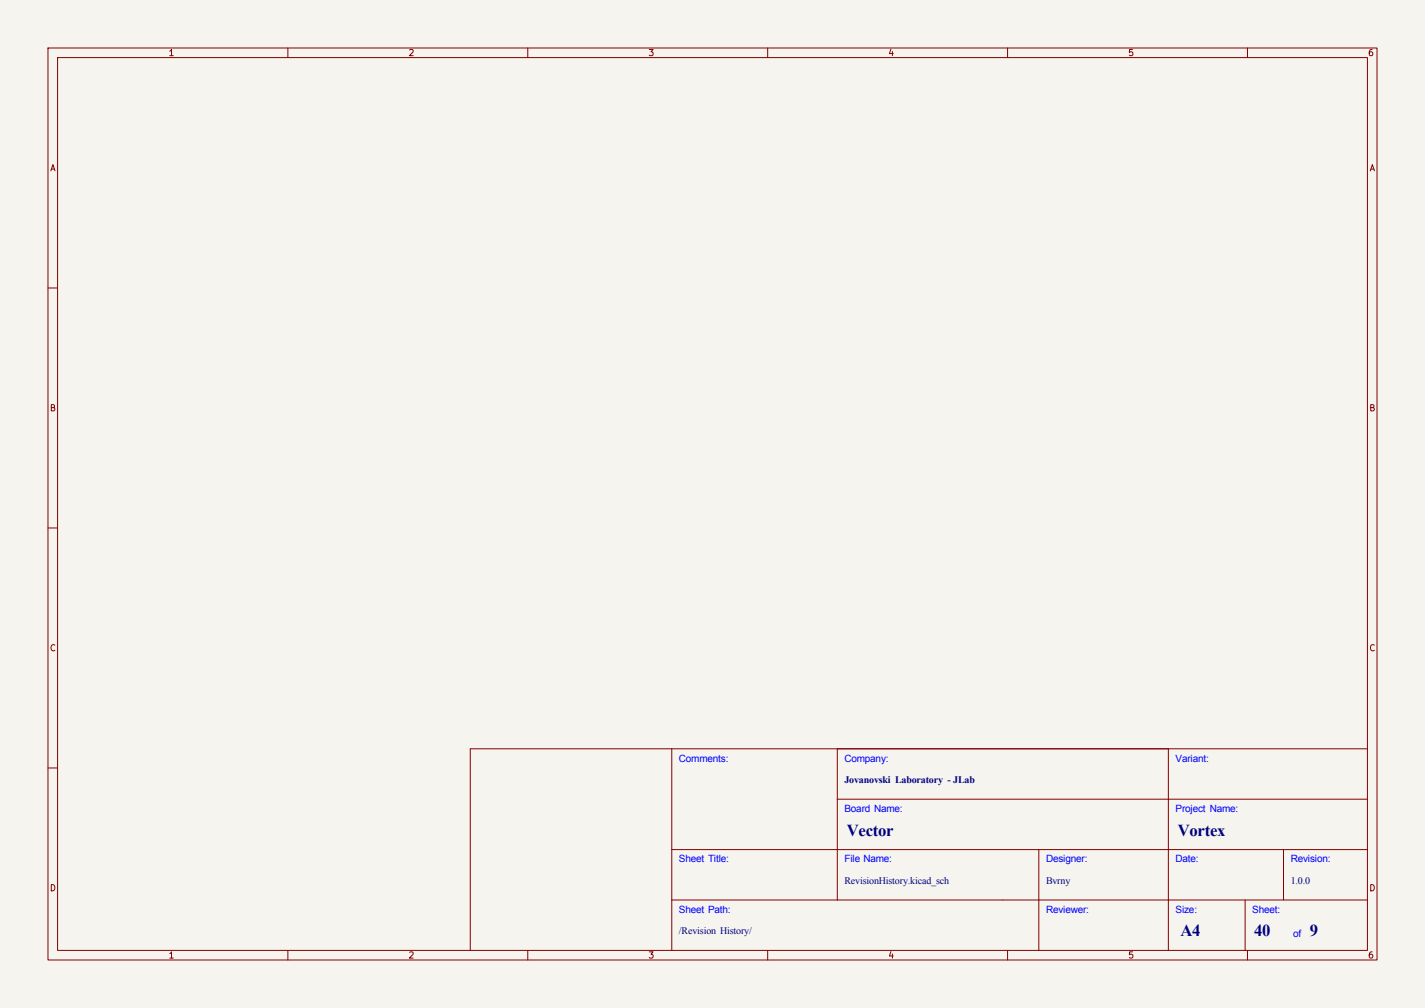
[picture p25: page 9]

/Revision History/ Sheet Path: Comments:

Revision: 1.0.0 Date: Project Name: Reviewer: Designer:
