bvrny/Vortex/PCBA-FLUX-01A/Schematic/PCBA-FLUX-01A.pdf

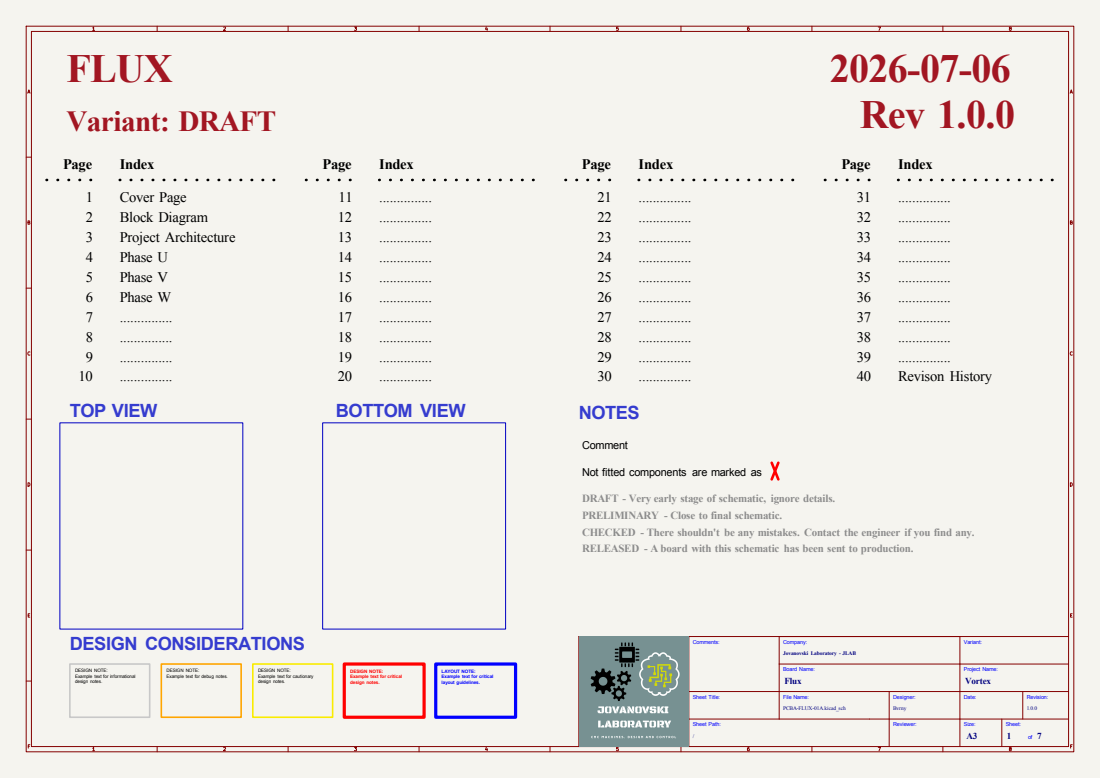
[picture p26: page 1]

DRAFT - Very early stage of schematic, ignore details.
PRELIMINARY - Close to final schematic.
CHECKED - There shouldn't be any mistakes. Contact the engineer if you find any.
RELEASED - A board with this schematic has been sent to production.

Revision: 1.0.0 Date: Project Name: Reviewer: Designer:

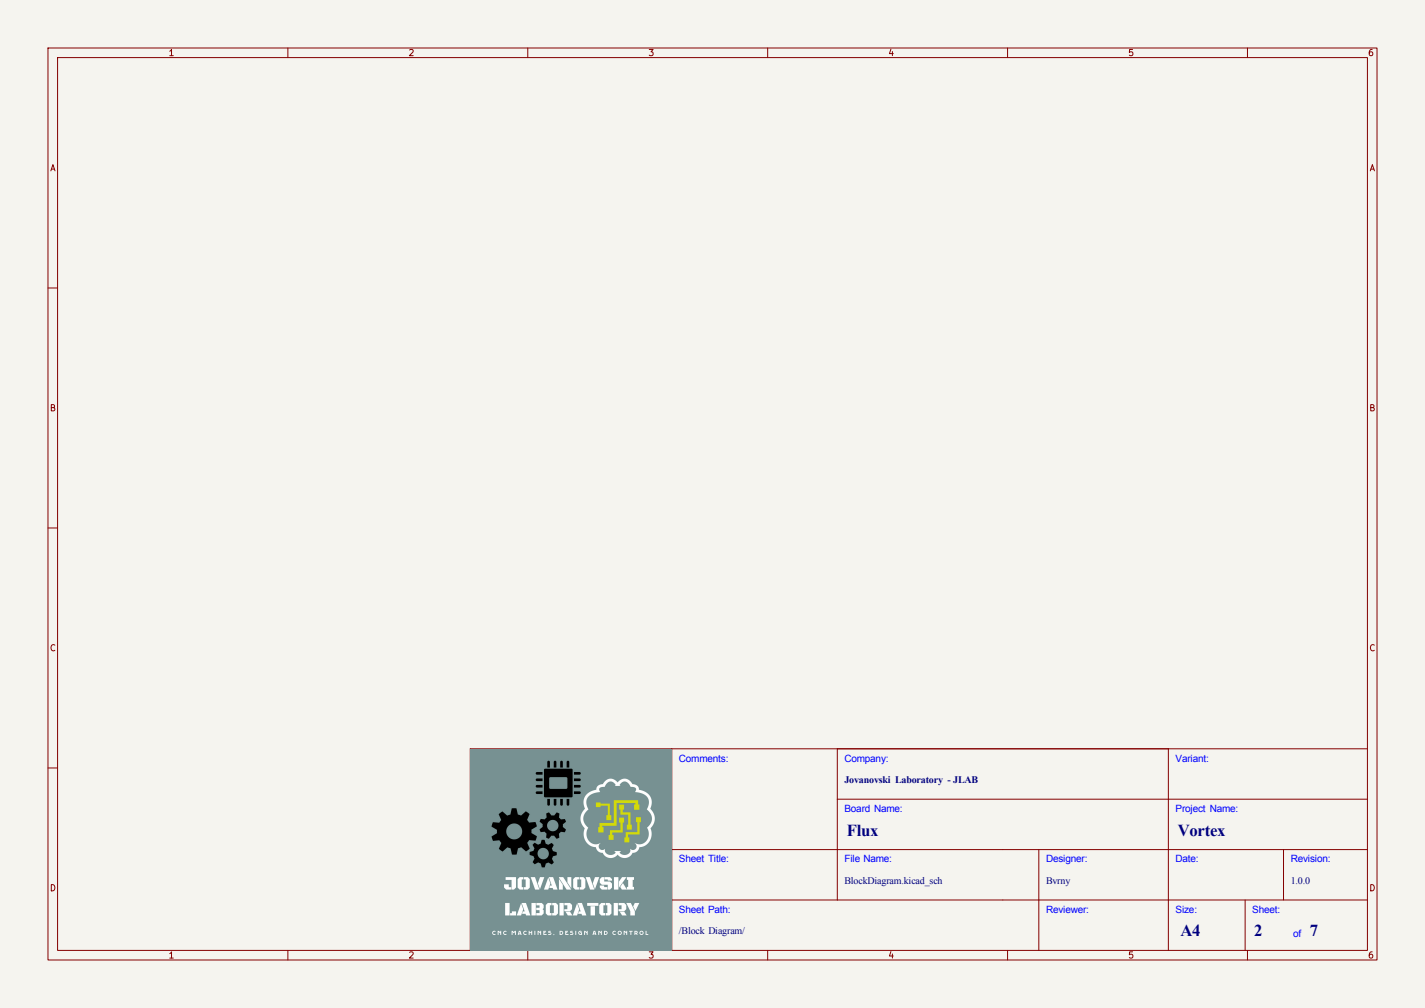
[picture p27: page 2]

/Block Diagram/ Sheet Path: Comments:

Revision: 1.0.0 Date: Project Name: Reviewer: Designer:

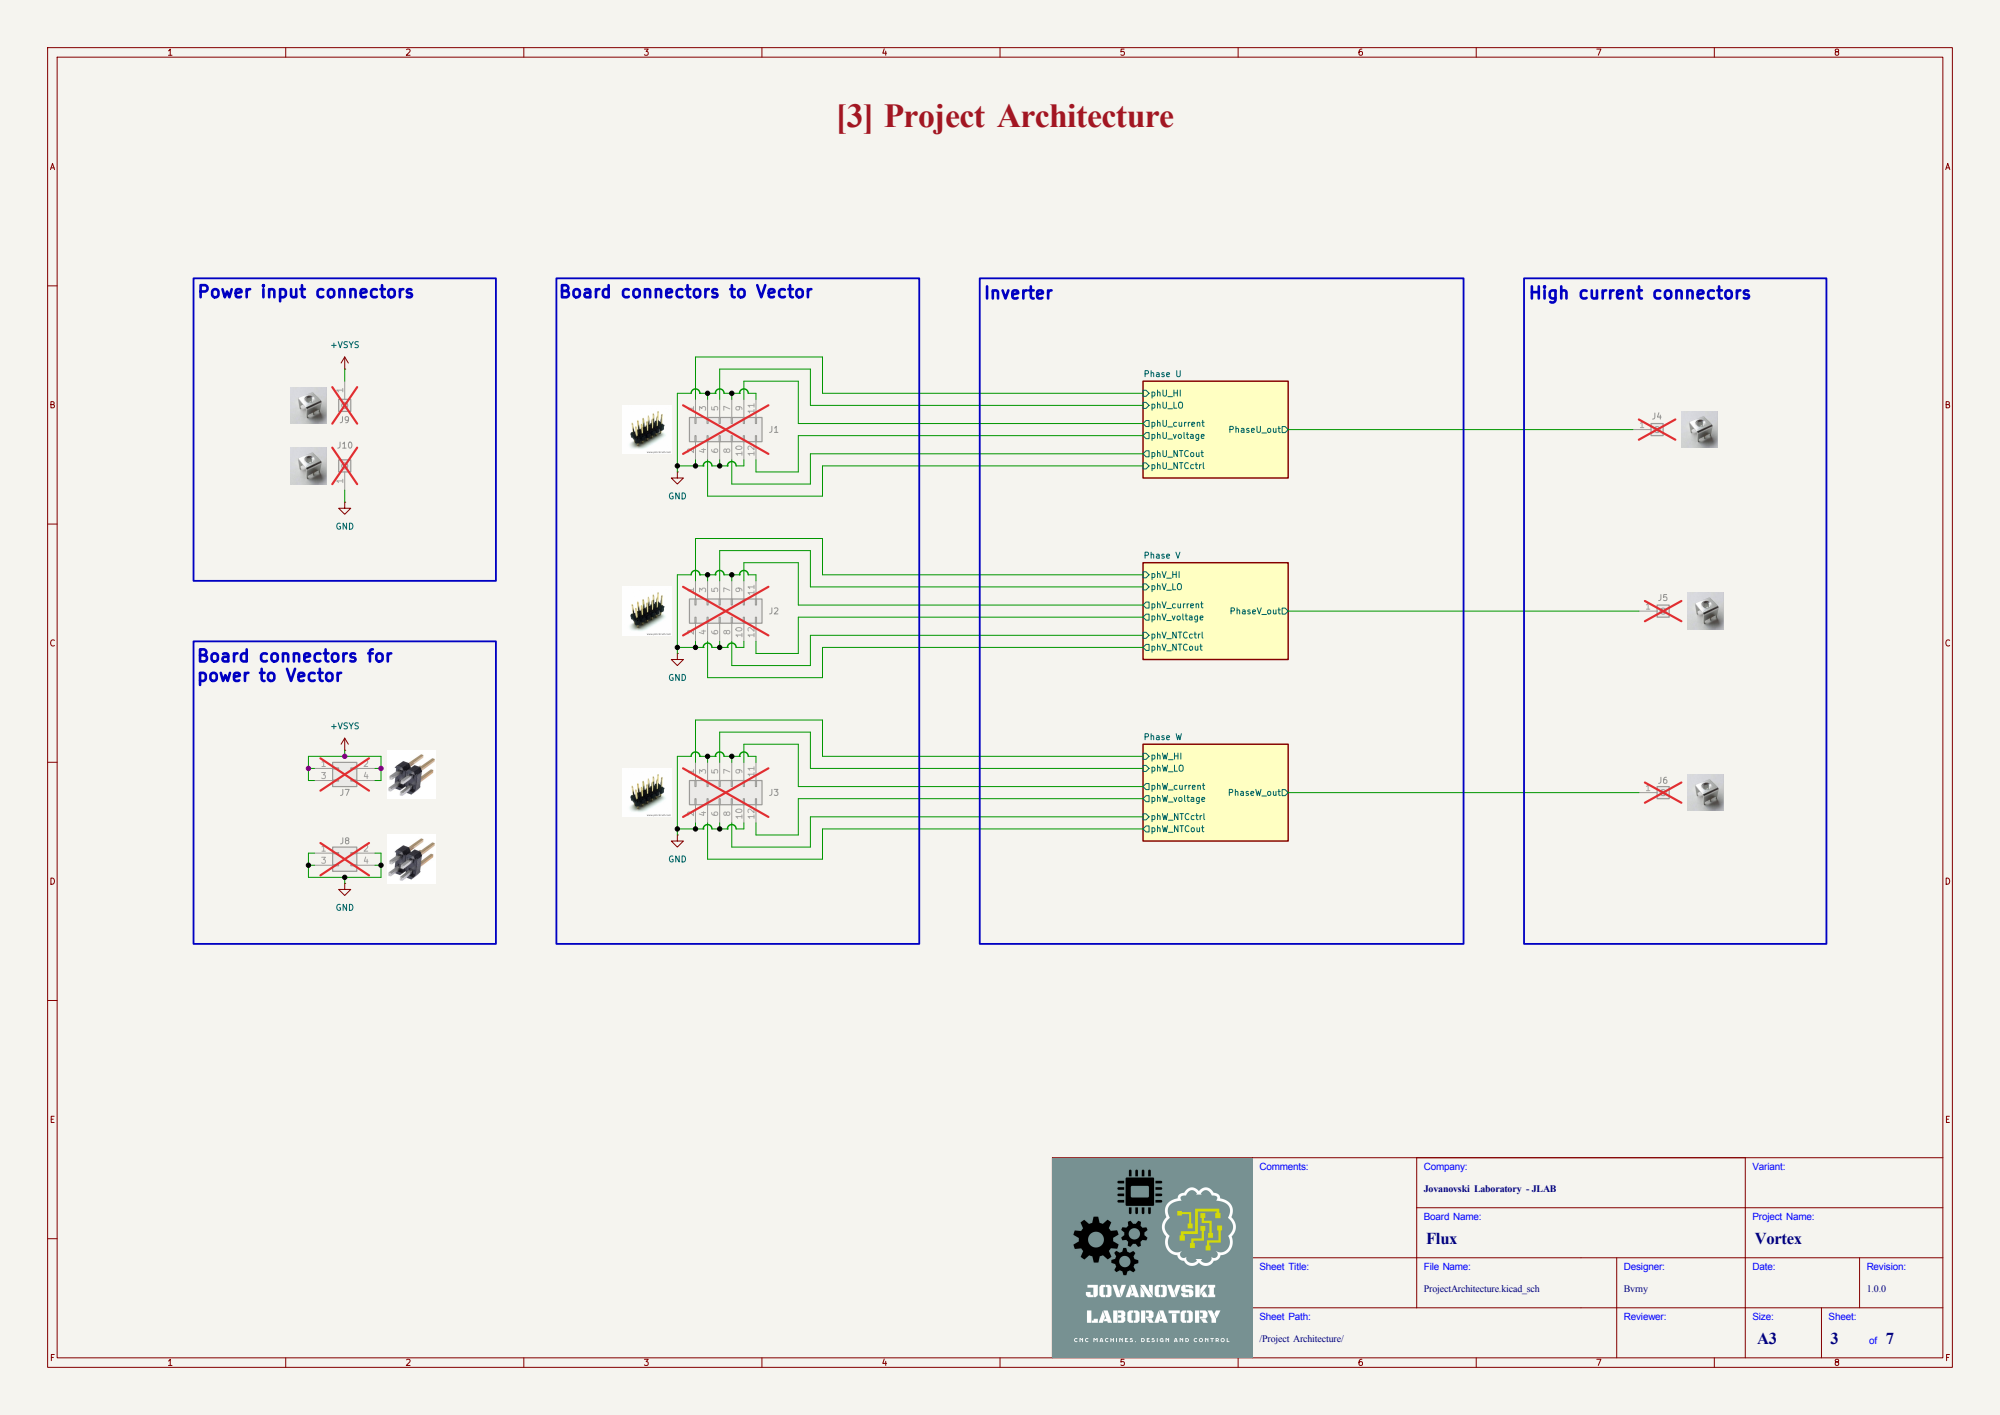
[picture p28: page 3]

/Project Architecture/ Sheet Path: Comments:

Revision: 1.0.0 Date: Project Name: Reviewer: Designer:

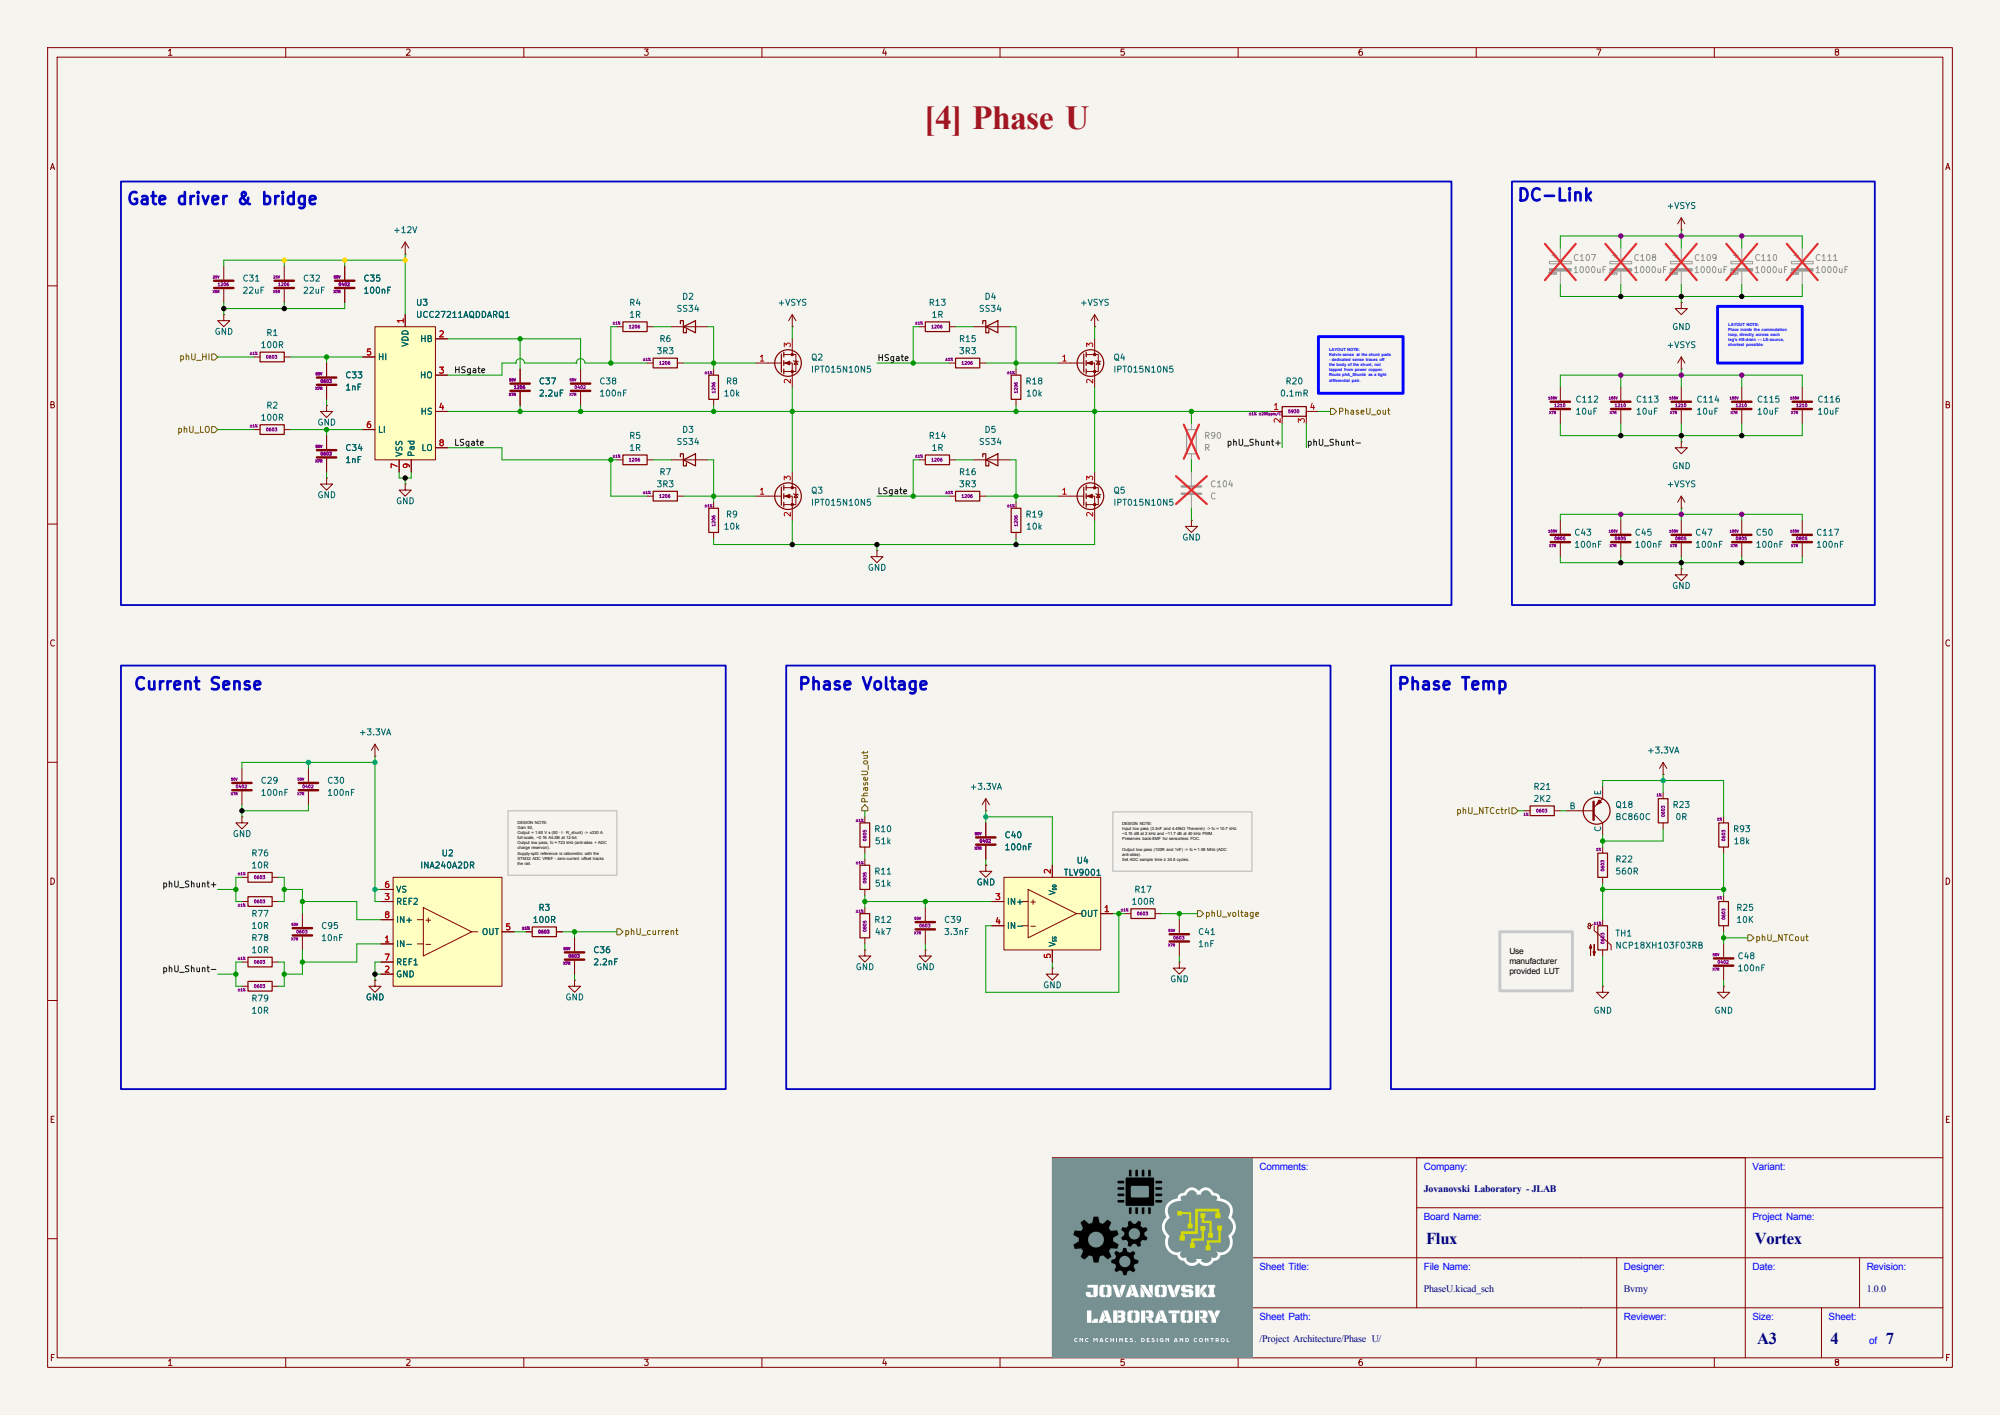
[picture p29: page 4]

leg's HS-drain ↔ LS-source, shortest possible. [4] Phase U

LAYOUT NOTE: Place inside the commutation
100V X7R +VSYS GND

loop, directly across each

LAYOUT NOTE: Kelvin-sense at the shunt pads

- dedicated sense traces off
the body of the shunt, not
tapped from power copper. Route phA_Shunt± as a tight differential pair.

DESIGN NOTE: Gain 50, Output = 1.65 V ± (50 · I · R_shunt) -> ±330 A

DESIGN NOTE:
Input low pass (3.3nF and 4.49kΩ Thevenin) -> fc = 10.7 kHz −0.15 dB at 2 kHz and −11.7 dB at 40 kHz PWM. Preserves back-EMF for sensorless FOC. Output low pass (100R and 1nF) -> fc ≈ 1.59 MHz (ADC

full-scale, ~0.16 A/LSB at 12-bit. Output low pass, fc ≈ 723 kHz (anti-alias + ADC

charge reservoir). Supply-split reference is ratiometric with the STM32 ADC VREF - zero-current offset tracks

anti-alias). Set ADC sample time ≥ 24.5 cycles.

/Project Architecture/Phase U/ Sheet Path: Comments:

Revision: 1.0.0 Date: Project Name: Reviewer: Designer:

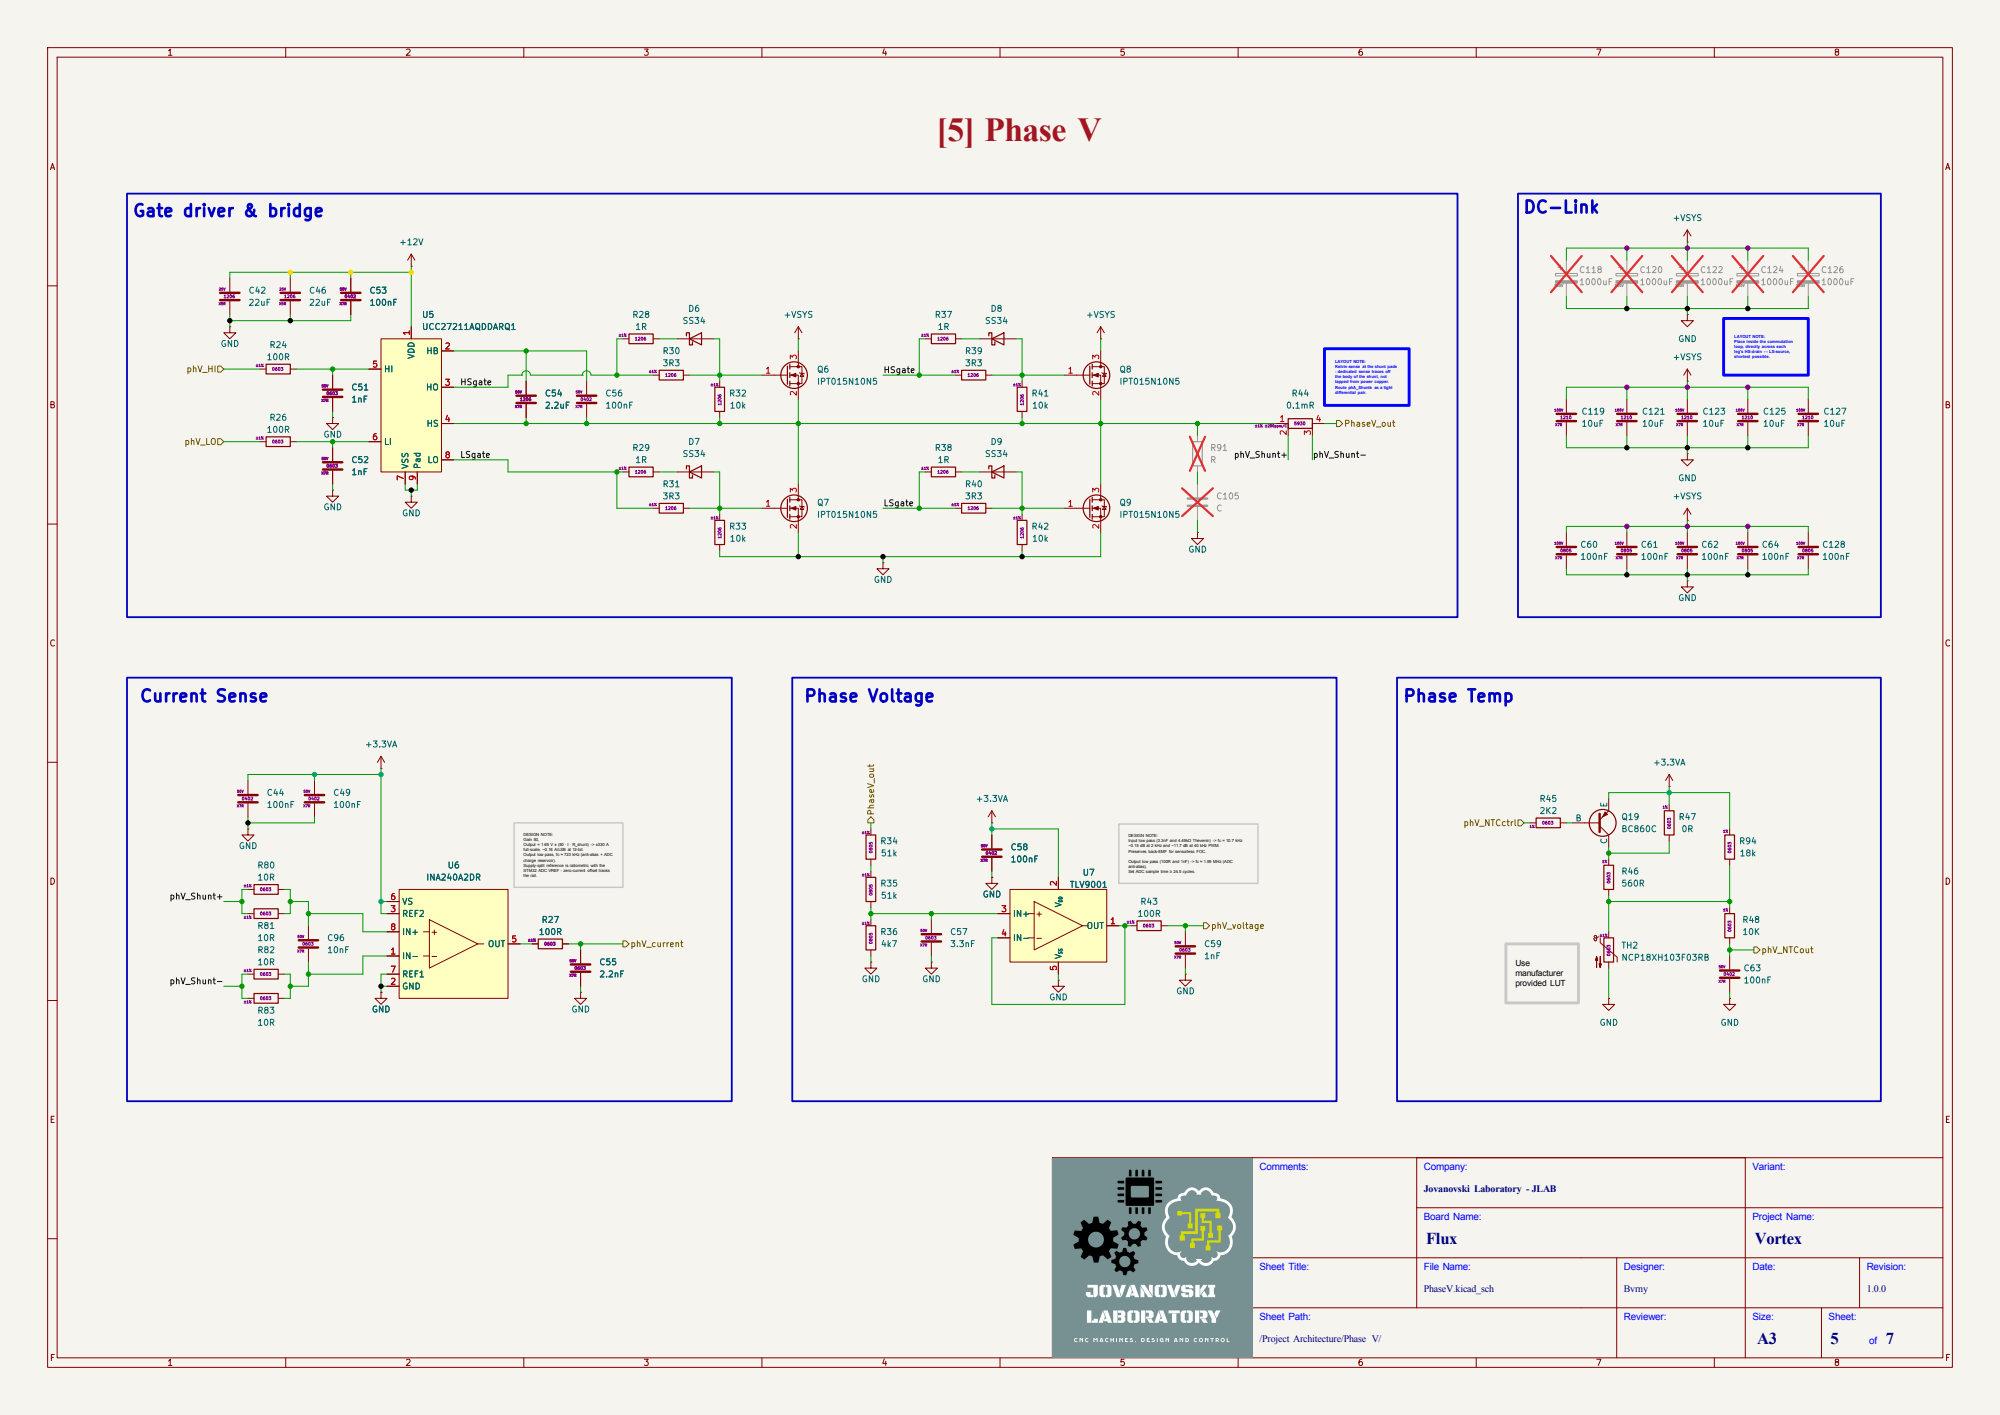
[picture p30: page 5]

LAYOUT NOTE: Place inside the commutation

loop, directly across each
leg's HS-drain ↔ LS-source, shortest possible.

LAYOUT NOTE: Kelvin-sense at the shunt pads

- dedicated sense traces off
the body of the shunt, not

anti-alias). Set ADC sample time ≥ 24.5 cycles. DESIGN NOTE: Gain 50, Output = 1.65 V ± (50 · I · R_shunt) -> ±330 A

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

charge reservoir). Supply-split reference is ratiometric with the STM32 ADC VREF - zero-current offset tracks

Revision: 1.0.0 Date: Project Name: Reviewer: Designer:

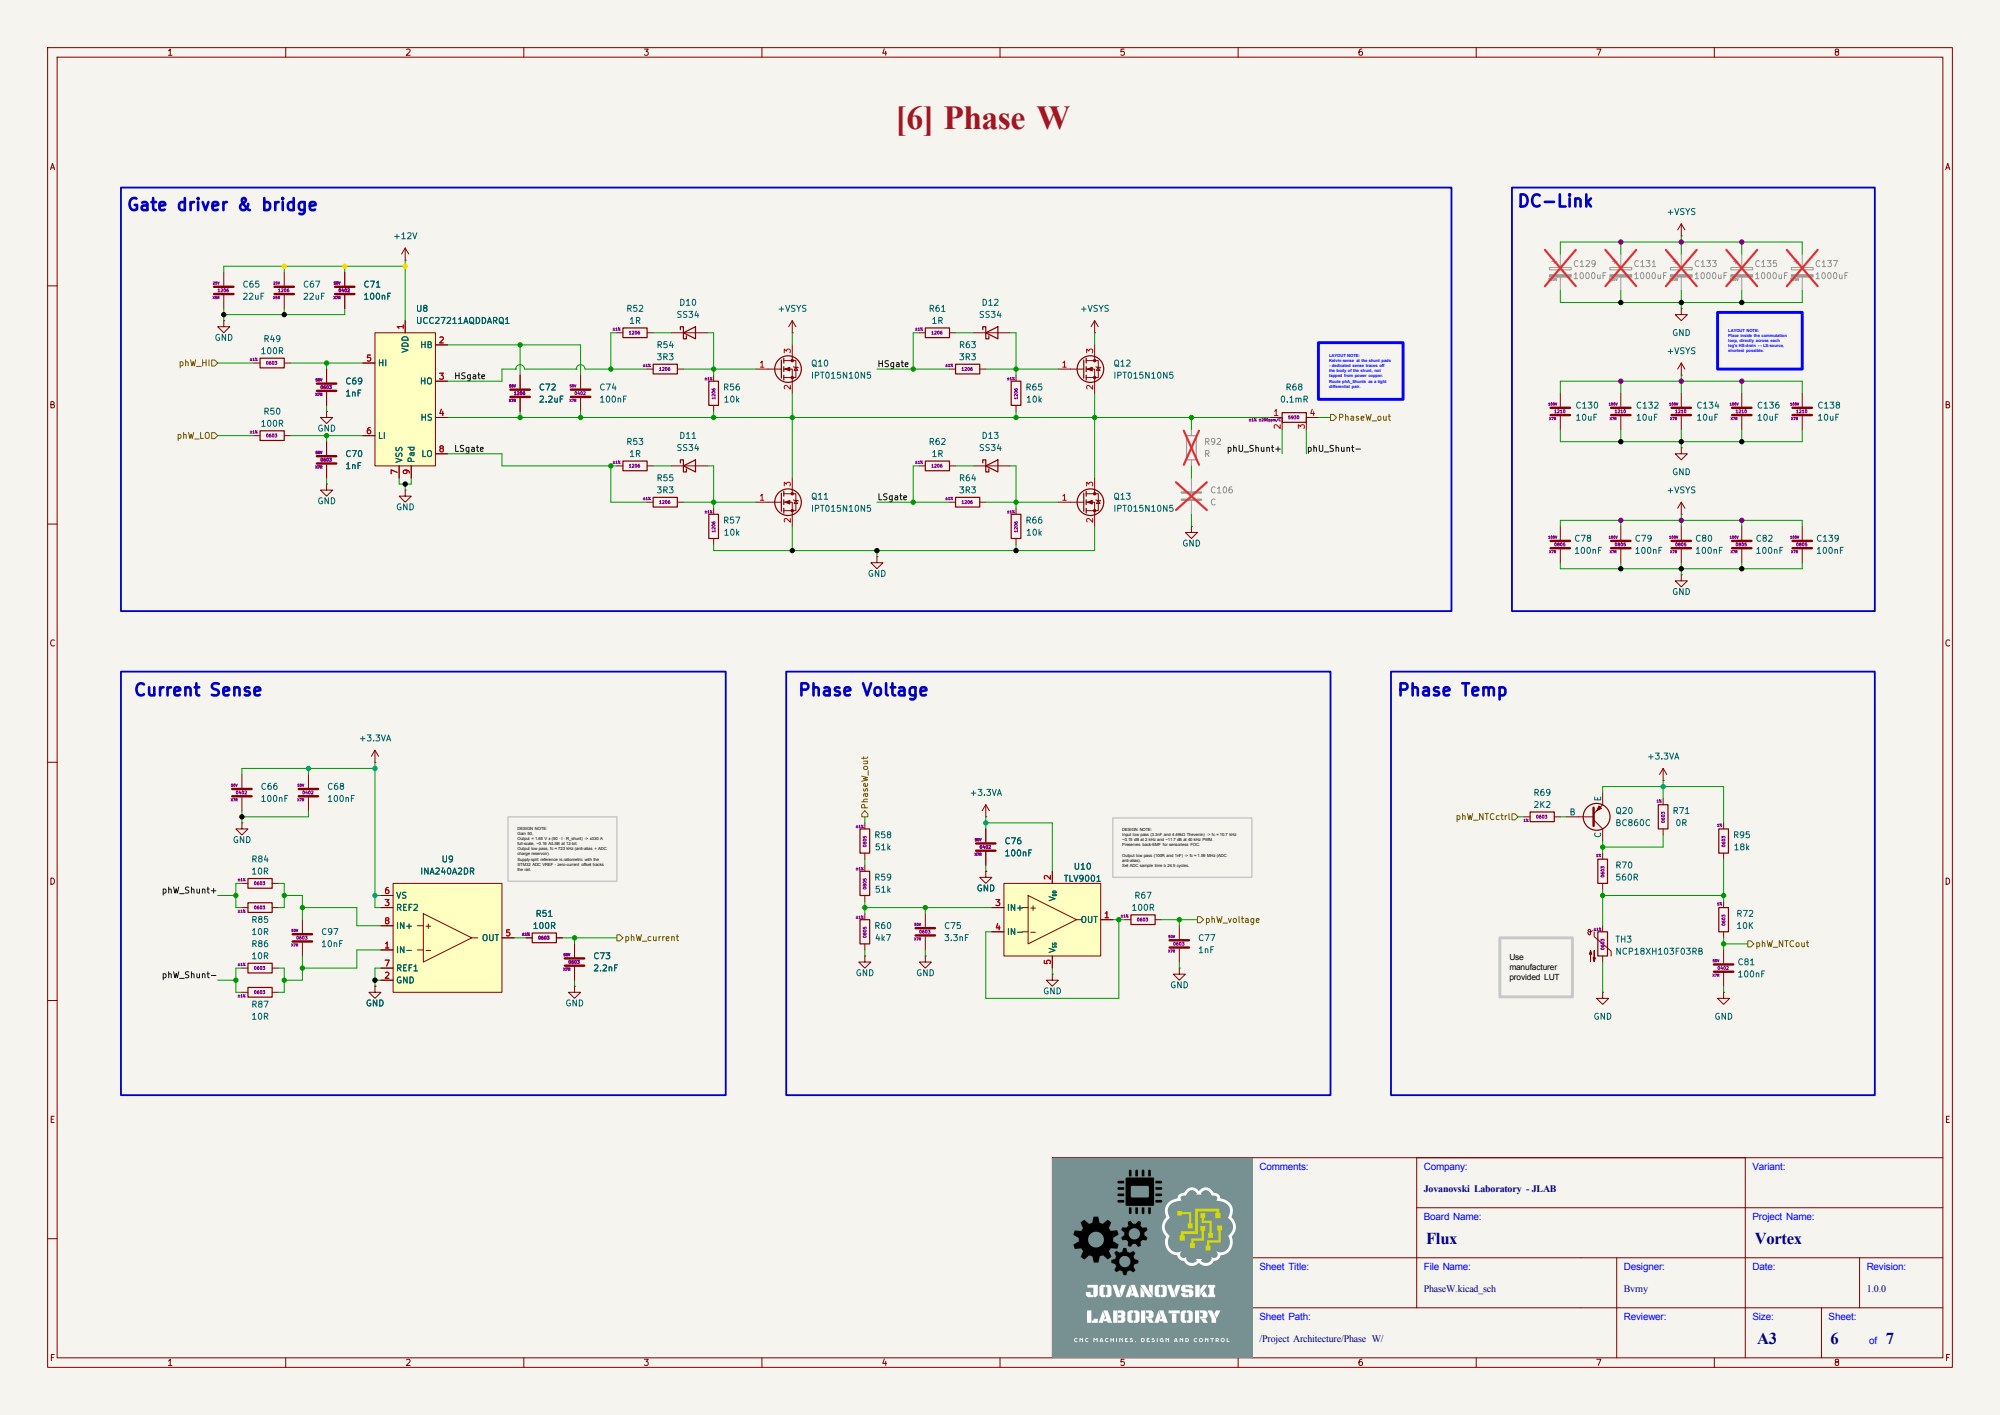
[picture p31: page 6]

anti-alias). Set ADC sample time ≥ 24.5 cycles. [6] Phase W

loop, directly across each
leg's HS-drain ↔ LS-source, shortest possible.

LAYOUT NOTE: Kelvin-sense at the shunt pads

- dedicated sense traces off
the body of the shunt, not

DESIGN NOTE: Gain 50, Output = 1.65 V ± (50 · I · R_shunt) -> ±330 A

DESIGN NOTE:
Input low pass (3.3nF and 4.49kΩ Thevenin) -> fc = 10.7 kHz −0.15 dB at 2 kHz and −11.7 dB at 40 kHz PWM. Preserves back-EMF for sensorless FOC. Output low pass (100R and 1nF) -> fc ≈ 1.59 MHz (ADC
TLV9001 GND

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

charge reservoir). Supply-split reference is ratiometric with the STM32 ADC VREF - zero-current offset tracks

Use manufacturer provided LUT (https://pim.murata.com/asset/pim4/ntcForTemperatureSensor/NTHCG83_TXT_NTCFORTEMPERATURESENSOR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)

/Project Architecture/Phase W/ Sheet Path: Comments:

Revision: 1.0.0 Date: Project Name: Reviewer: Designer:

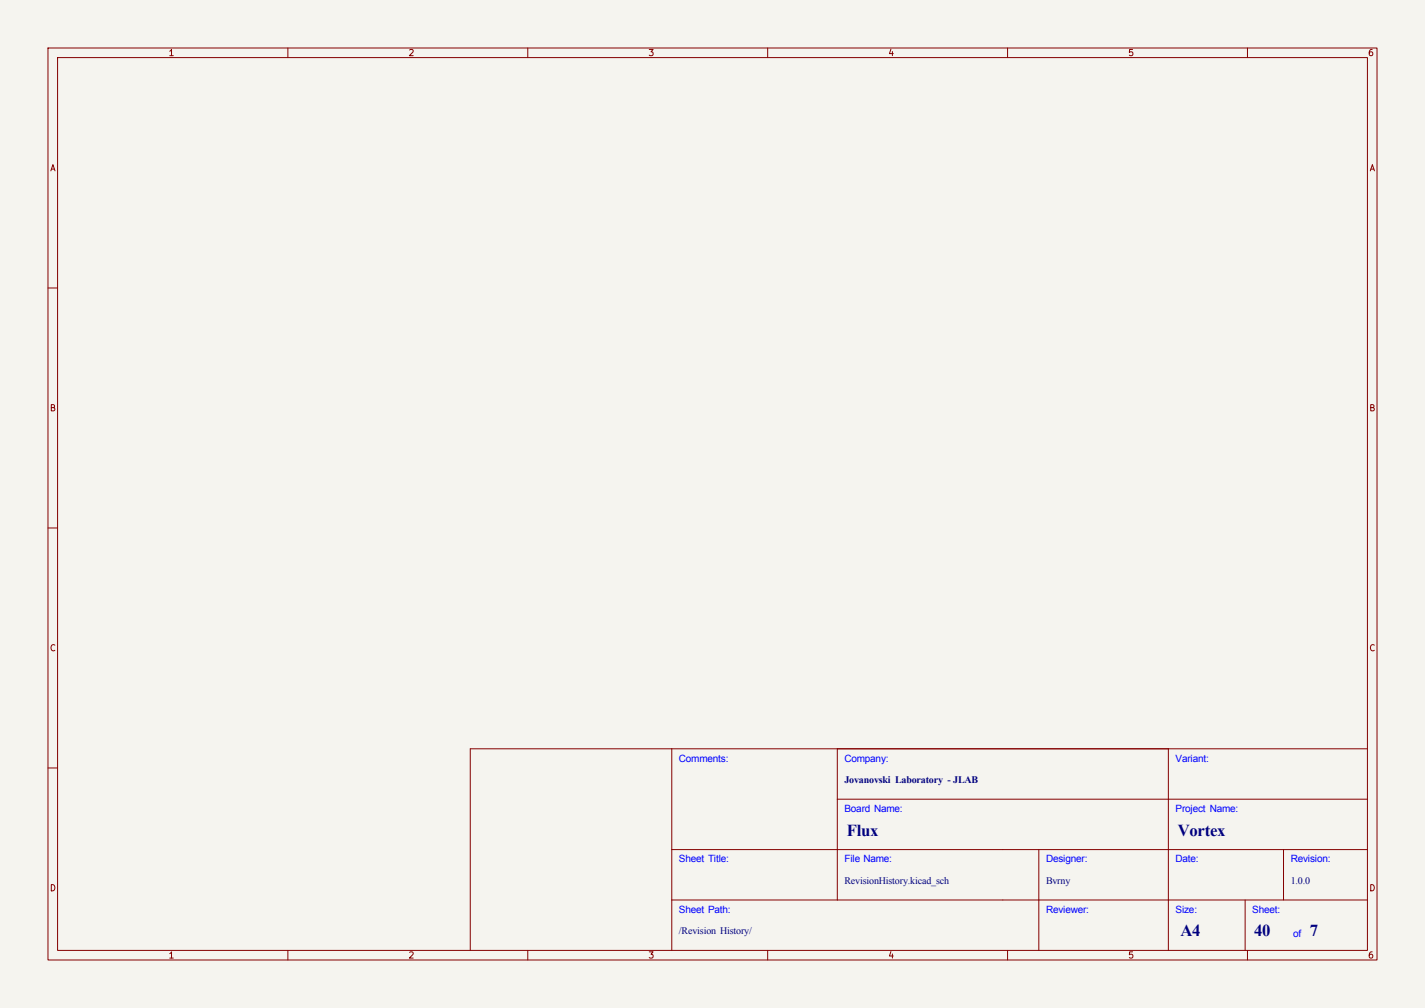
[picture p32: page 7]

/Revision History/ Sheet Path: Comments:

Revision: 1.0.0 Date: Project Name: Reviewer: Designer:
