bvrny/Vortex/PCBA-FLUX-01A/_restore_backup_2026-08-26T13-48-18-741/PCBA-FLUX-01A.kicad_pcb

## KiCad design PCBA-FLUX-01A/_restore_backup_2026-08-26T13-48-18-741/PCBA-FLUX-01A.kicad_pcb (2026-09-30)

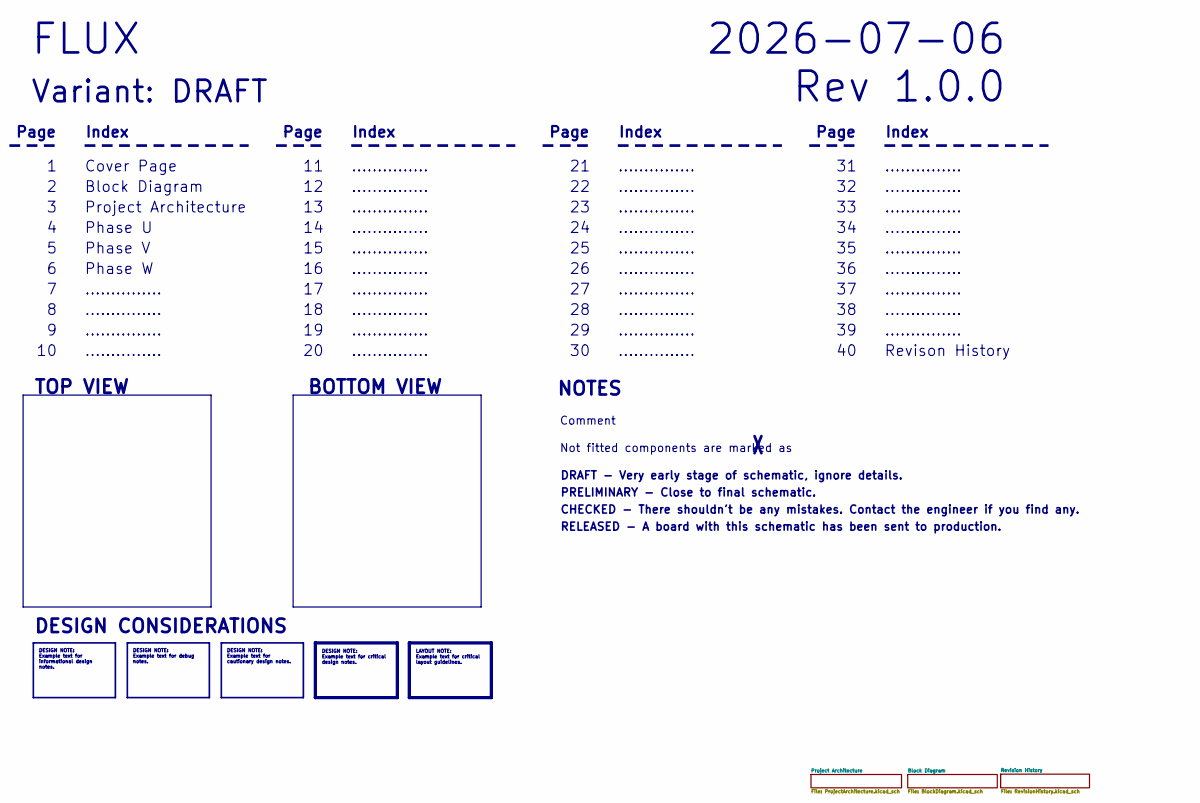
[picture p33: schematic PCBA-FLUX-01A.kicad_sch]

Notes on the sheet:
Phase W
...............
Comment
DRAFT - Very early stage of schematic, ignore details.
Rev 1.0.0
PRELIMINARY - Close to final schematic.
Phase U
BOTTOM VIEW
Page
RELEASED - A board with this schematic has been sent to production.
Block Diagram
CHECKED - There shouldn't be any mistakes. Contact the engineer if you find any.
Index
2026-07-06
Project Architecture
FLUX
Cover Page
TOP VIEW
NOTES
DESIGN CONSIDERATIONS
Revison History
Phase V
Not fitted components are marked as
Variant: DRAFT
DESIGN NOTE: Example text for cautionary design notes.
LAYOUT NOTE: Example text for critical layout guidelines.
DESIGN NOTE: Example text for informational design notes.
DESIGN NOTE: Example text for debug notes.
DESIGN NOTE: Example text for critical design notes.

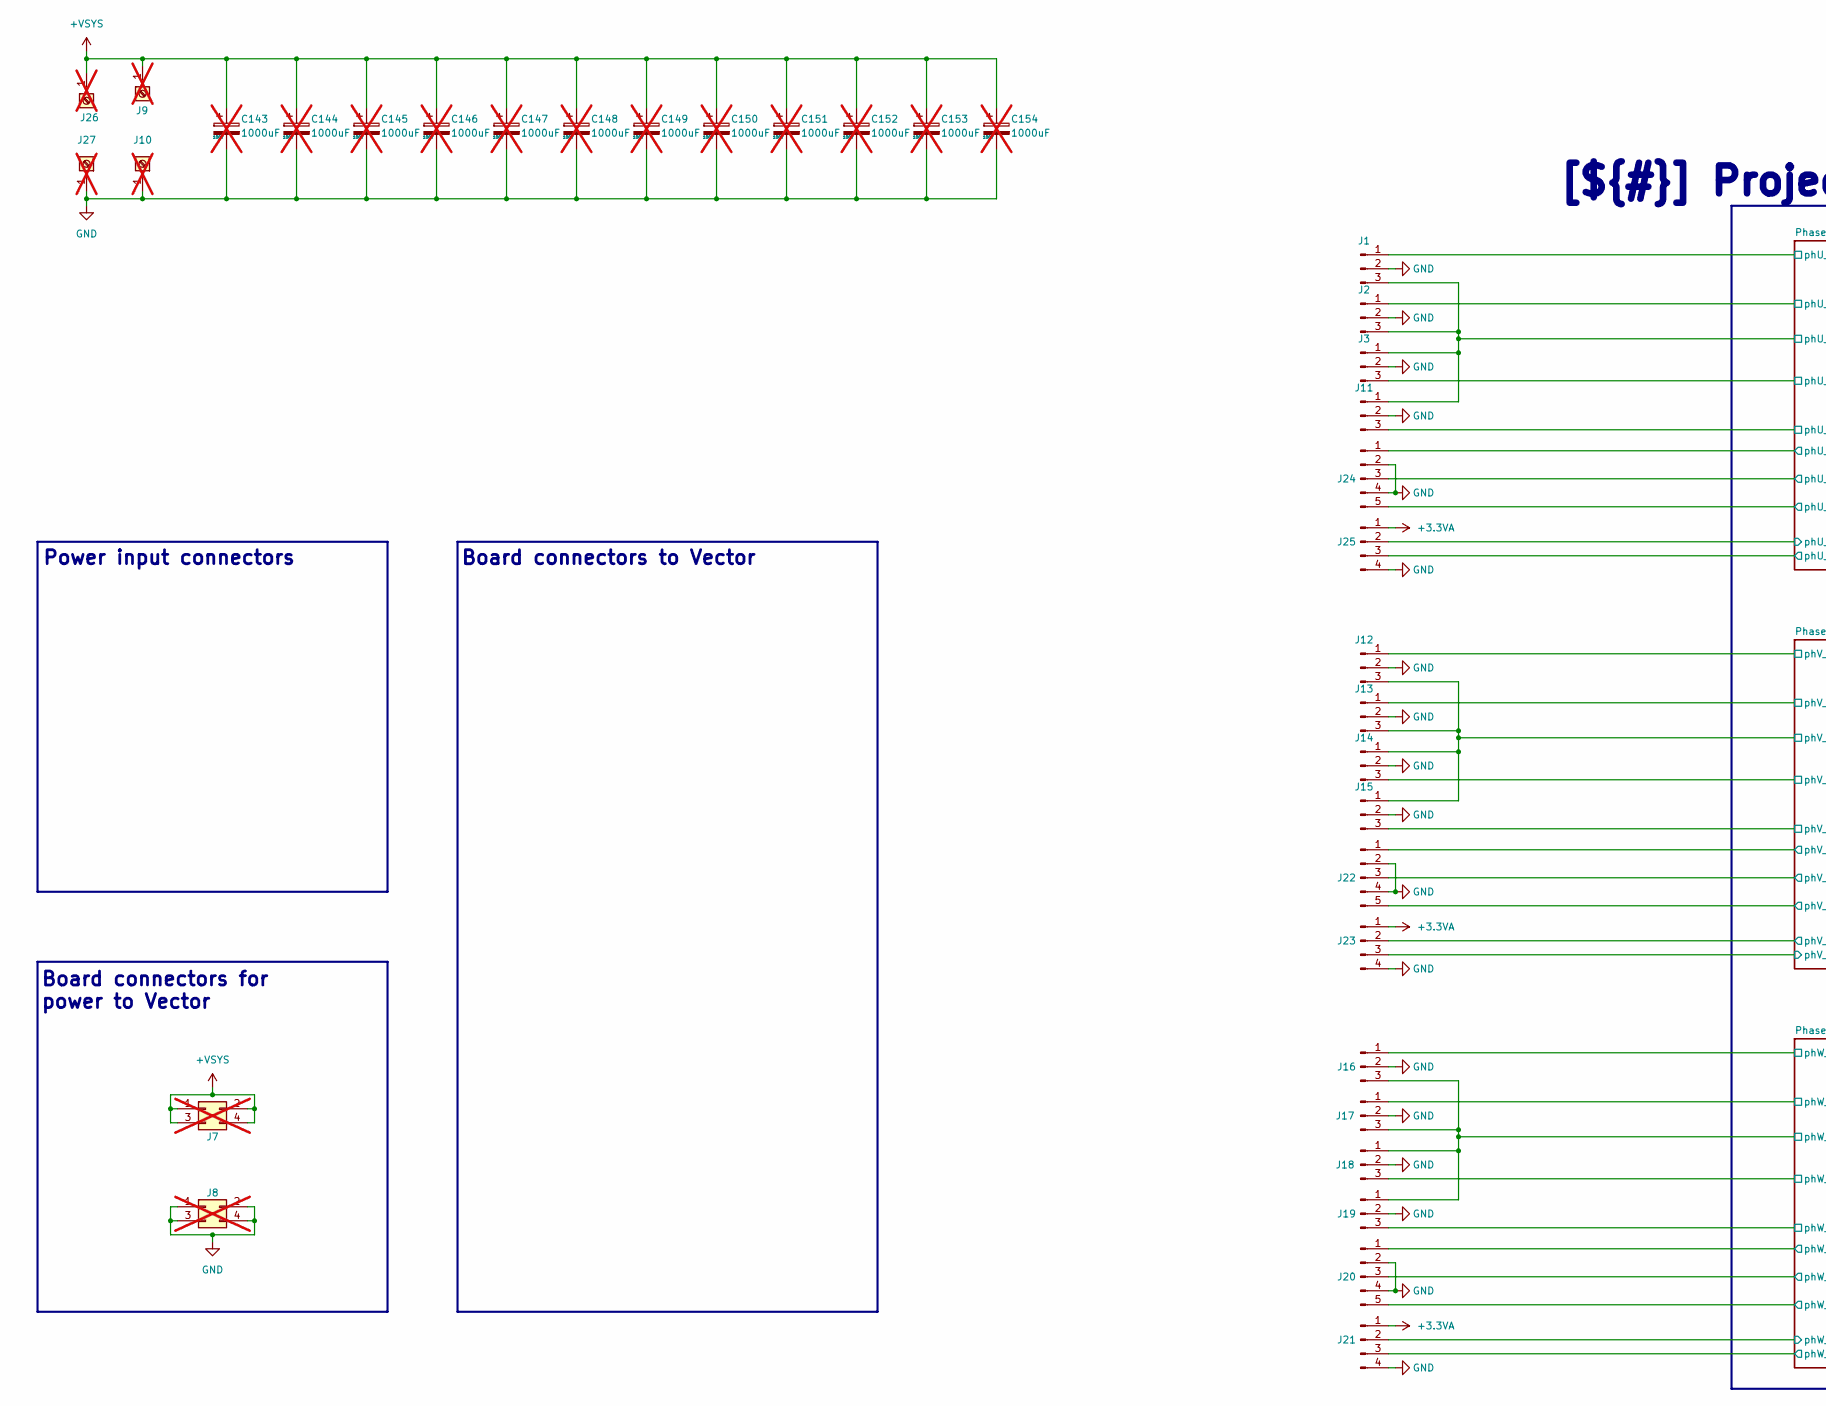
[picture p34: schematic ProjectArchitecture.kicad_sch, part in row 1, column 1]

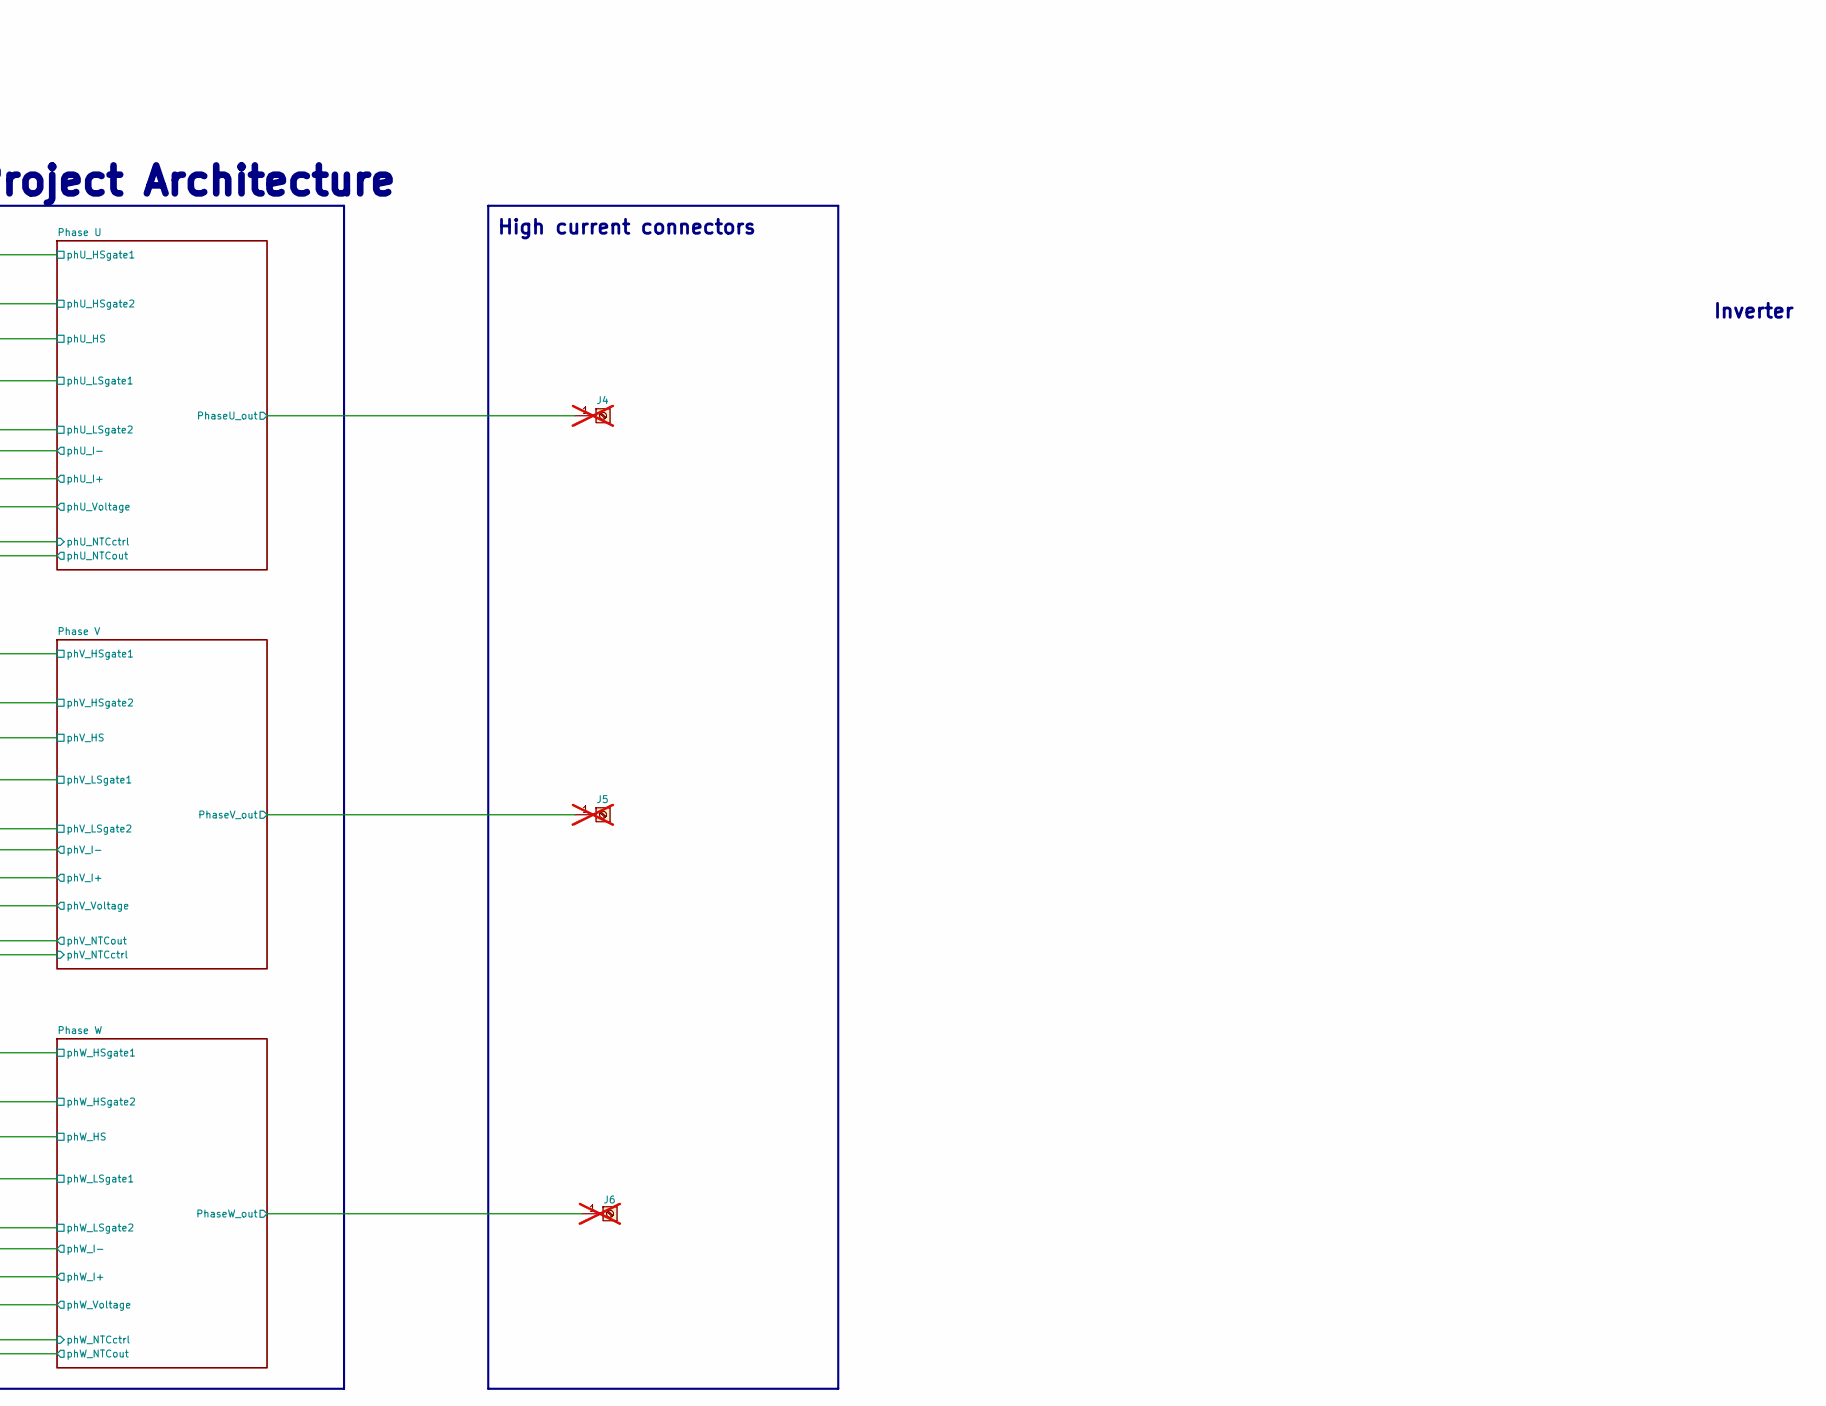
[picture p35: schematic ProjectArchitecture.kicad_sch, part in row 1, column 2]

Parts:
C143, C144, C145, C146, C147, C148, C149, C150, C151, C152, C153, C154: 1000uF; CP_Radial_D18.0mm_P7.50mm; not fitted
J1, J2, J3, J11, J12, J13, J14, J15, J16, J17, J18, J19: Conn_01x03_Pin; PinHeader_1x03_P2.54mm_Vertical
J4, J5, J6, J9, J10, J26, J27: Screw_Terminal_01x01; M8_NutTerminal; not fitted
J7, J8: Conn_02x02_Odd_Even; PinHeader_2x02_P2.54mm_Vertical; not fitted
J20, J22, J24: Conn_01x05_Pin; PinHeader_1x05_P2.54mm_Vertical
J21, J23, J25: Conn_01x04_Pin; PinHeader_1x04_P2.54mm_Vertical

Connections:
+3.3VA: J21.1, J23.1, J25.1; also elsewhere on the board
+VSYS: C143.1, C144.1, C145.1, C146.1, C147.1, C148.1, C149.1, C150.1, C151.1, C152.1, C153.1, C154.1, J7.1, J7.2, J7.3, J7.4, J9.1 (Pin_1_1), J26.1 (Pin_1_1); also elsewhere on the board
/Project Architecture/Phase U/PhaseU_out: J4.1 (Pin_1_1); also elsewhere on the board
/Project Architecture/Phase U/phU_HS: J1.3, J2.3, J3.1, J11.1; also elsewhere on the board
/Project Architecture/Phase U/phU_HSgate1: J1.1; also elsewhere on the board
/Project Architecture/Phase U/phU_HSgate2: J2.1; also elsewhere on the board
/Project Architecture/Phase U/phU_I+: J24.3; also elsewhere on the board
/Project Architecture/Phase U/phU_I-: J24.1; also elsewhere on the board
/Project Architecture/Phase U/phU_LSgate1: J3.3; also elsewhere on the board
/Project Architecture/Phase U/phU_LSgate2: J11.3; also elsewhere on the board
/Project Architecture/Phase U/phU_NTCctrl: J25.2; also elsewhere on the board
/Project Architecture/Phase U/phU_NTCout: J25.3; also elsewhere on the board
/Project Architecture/Phase U/phU_Voltage: J24.5; also elsewhere on the board
/Project Architecture/Phase V/PhaseV_out: J5.1 (Pin_1_1); also elsewhere on the board
/Project Architecture/Phase V/phV_HS: J12.3, J13.3, J14.1, J15.1; also elsewhere on the board
/Project Architecture/Phase V/phV_HSgate1: J12.1; also elsewhere on the board
/Project Architecture/Phase V/phV_HSgate2: J13.1; also elsewhere on the board
/Project Architecture/Phase V/phV_I+: J22.3; also elsewhere on the board
/Project Architecture/Phase V/phV_I-: J22.1; also elsewhere on the board
/Project Architecture/Phase V/phV_LSgate1: J14.3; also elsewhere on the board
/Project Architecture/Phase V/phV_LSgate2: J15.3; also elsewhere on the board
/Project Architecture/Phase V/phV_NTCctrl: J23.3; also elsewhere on the board
/Project Architecture/Phase V/phV_NTCout: J23.2; also elsewhere on the board
/Project Architecture/Phase V/phV_Voltage: J22.5; also elsewhere on the board
/Project Architecture/Phase W/PhaseW_out: J6.1 (Pin_1_1); also elsewhere on the board
/Project Architecture/Phase W/phW_HS: J16.3, J17.3, J18.1, J19.1; also elsewhere on the board
/Project Architecture/Phase W/phW_HSgate1: J16.1; also elsewhere on the board
/Project Architecture/Phase W/phW_HSgate2: J17.1; also elsewhere on the board
/Project Architecture/Phase W/phW_I+: J20.3; also elsewhere on the board
/Project Architecture/Phase W/phW_I-: J20.1; also elsewhere on the board
/Project Architecture/Phase W/phW_LSgate1: J18.3; also elsewhere on the board
/Project Architecture/Phase W/phW_LSgate2: J19.3; also elsewhere on the board
/Project Architecture/Phase W/phW_NTCctrl: J21.2; also elsewhere on the board
/Project Architecture/Phase W/phW_NTCout: J21.3; also elsewhere on the board
/Project Architecture/Phase W/phW_Voltage: J20.5; also elsewhere on the board
GND: C143.2, C144.2, C145.2, C146.2, C147.2, C148.2, C149.2, C150.2, C151.2, C152.2, C153.2, C154.2, J1.2, J2.2, J3.2, J8.1, J8.2, J8.3, J8.4, J10.1 (Pin_1_1), J11.2, J12.2, J13.2, J14.2, J15.2, J16.2, J17.2, J18.2, J19.2, J20.2, J20.4, J21.4, J22.2, J22.4, J23.4, J24.2, J24.4, J25.4, J27.1 (Pin_1_1); also elsewhere on the board

Notes on the sheet:
Power input connectors
Board connectors for power to Vector
High current connectors
Inverter
Board connectors to Vector
[${#}] Project Architecture

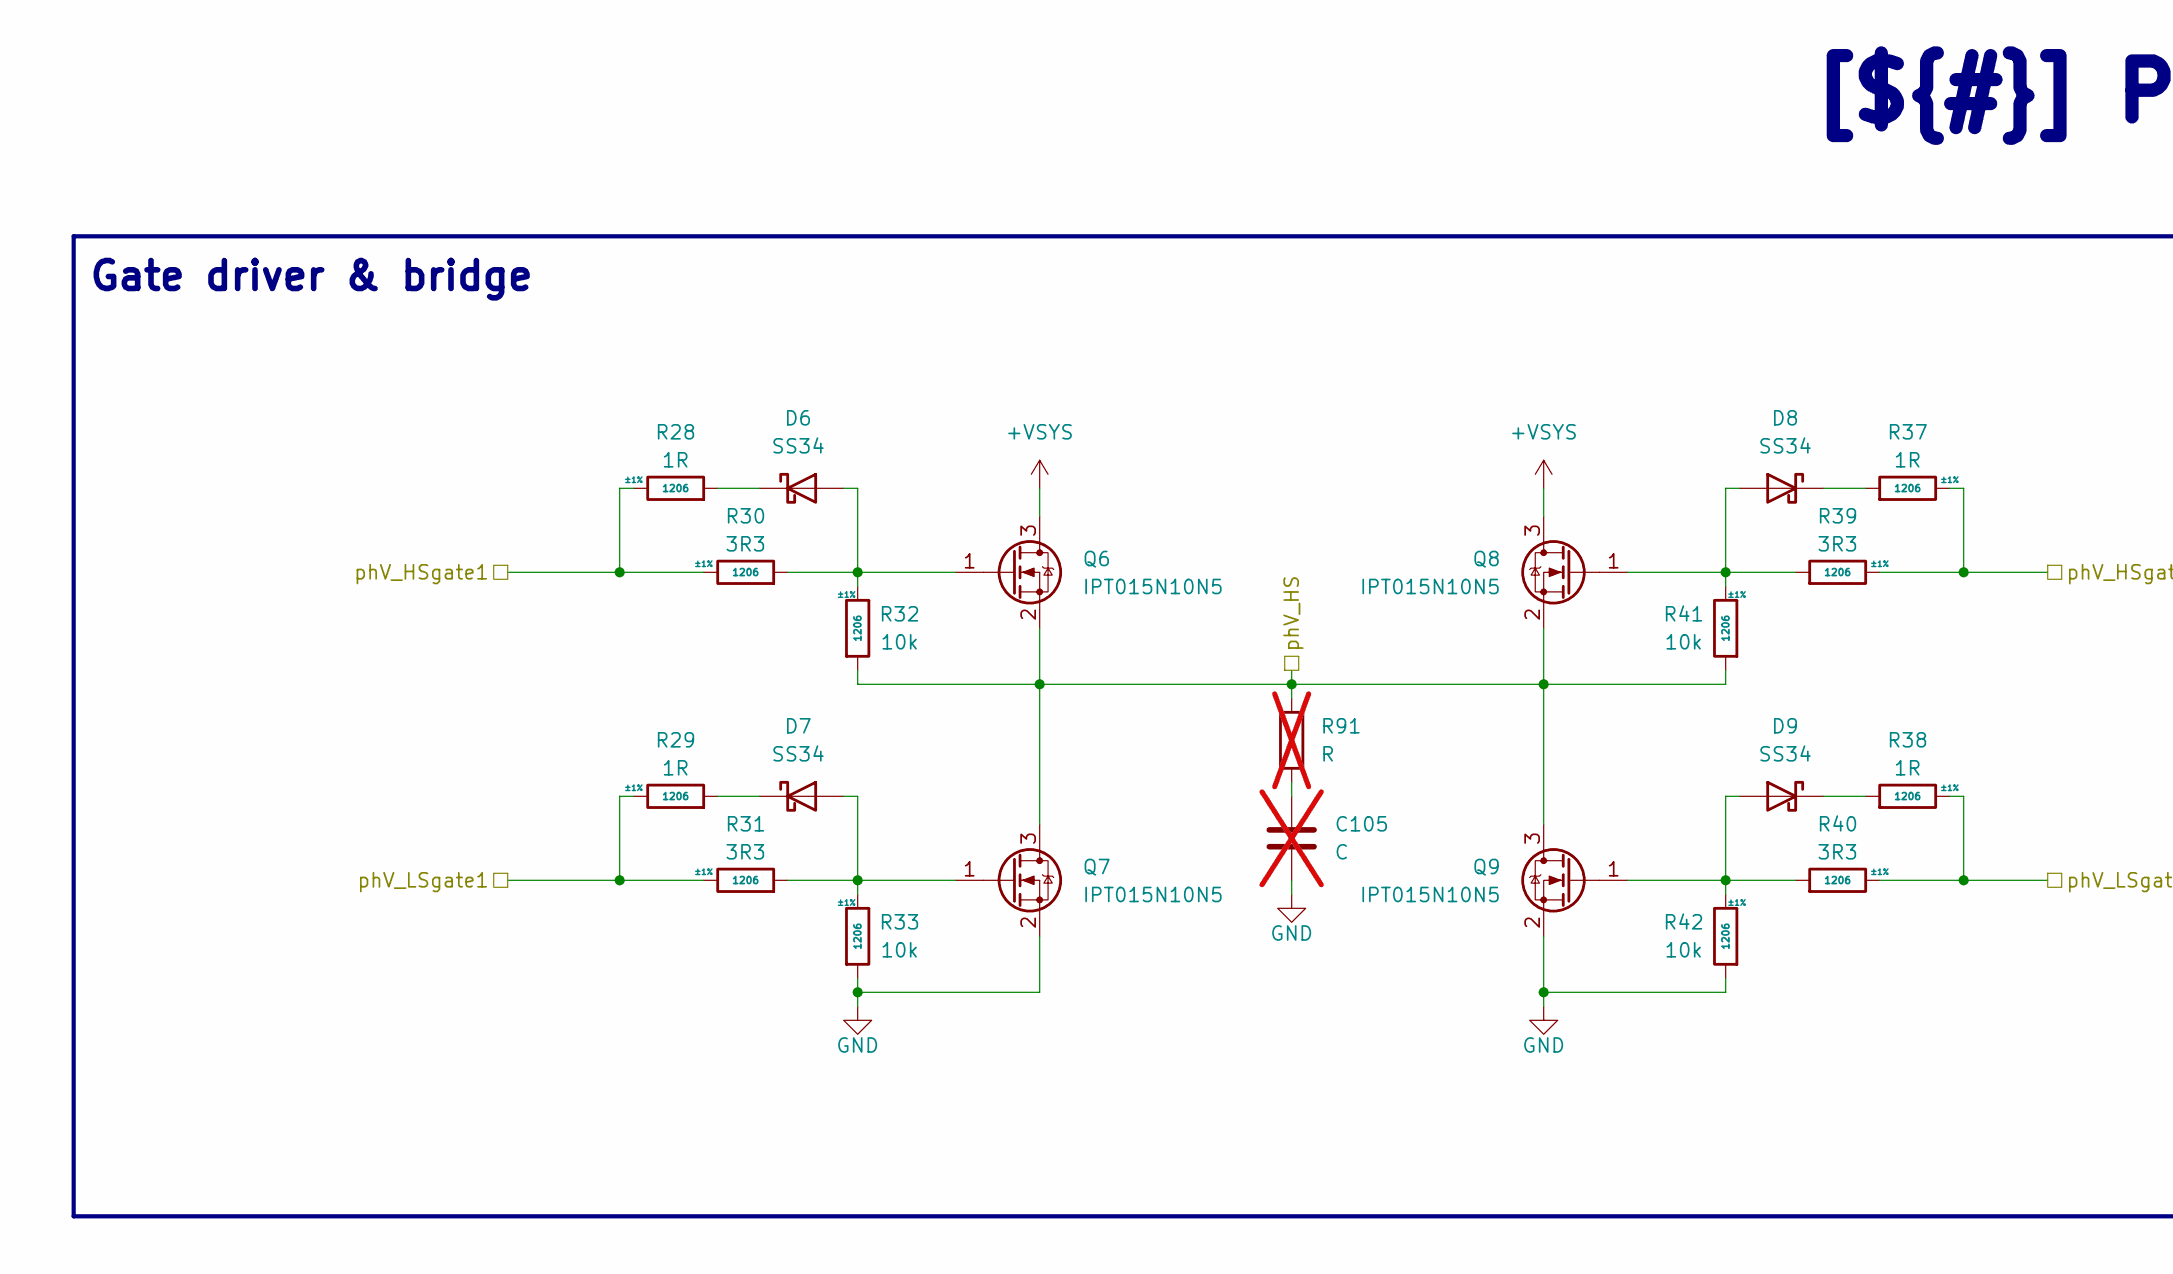
[picture p36: schematic PhaseV.kicad_sch, part in row 1, column 1]

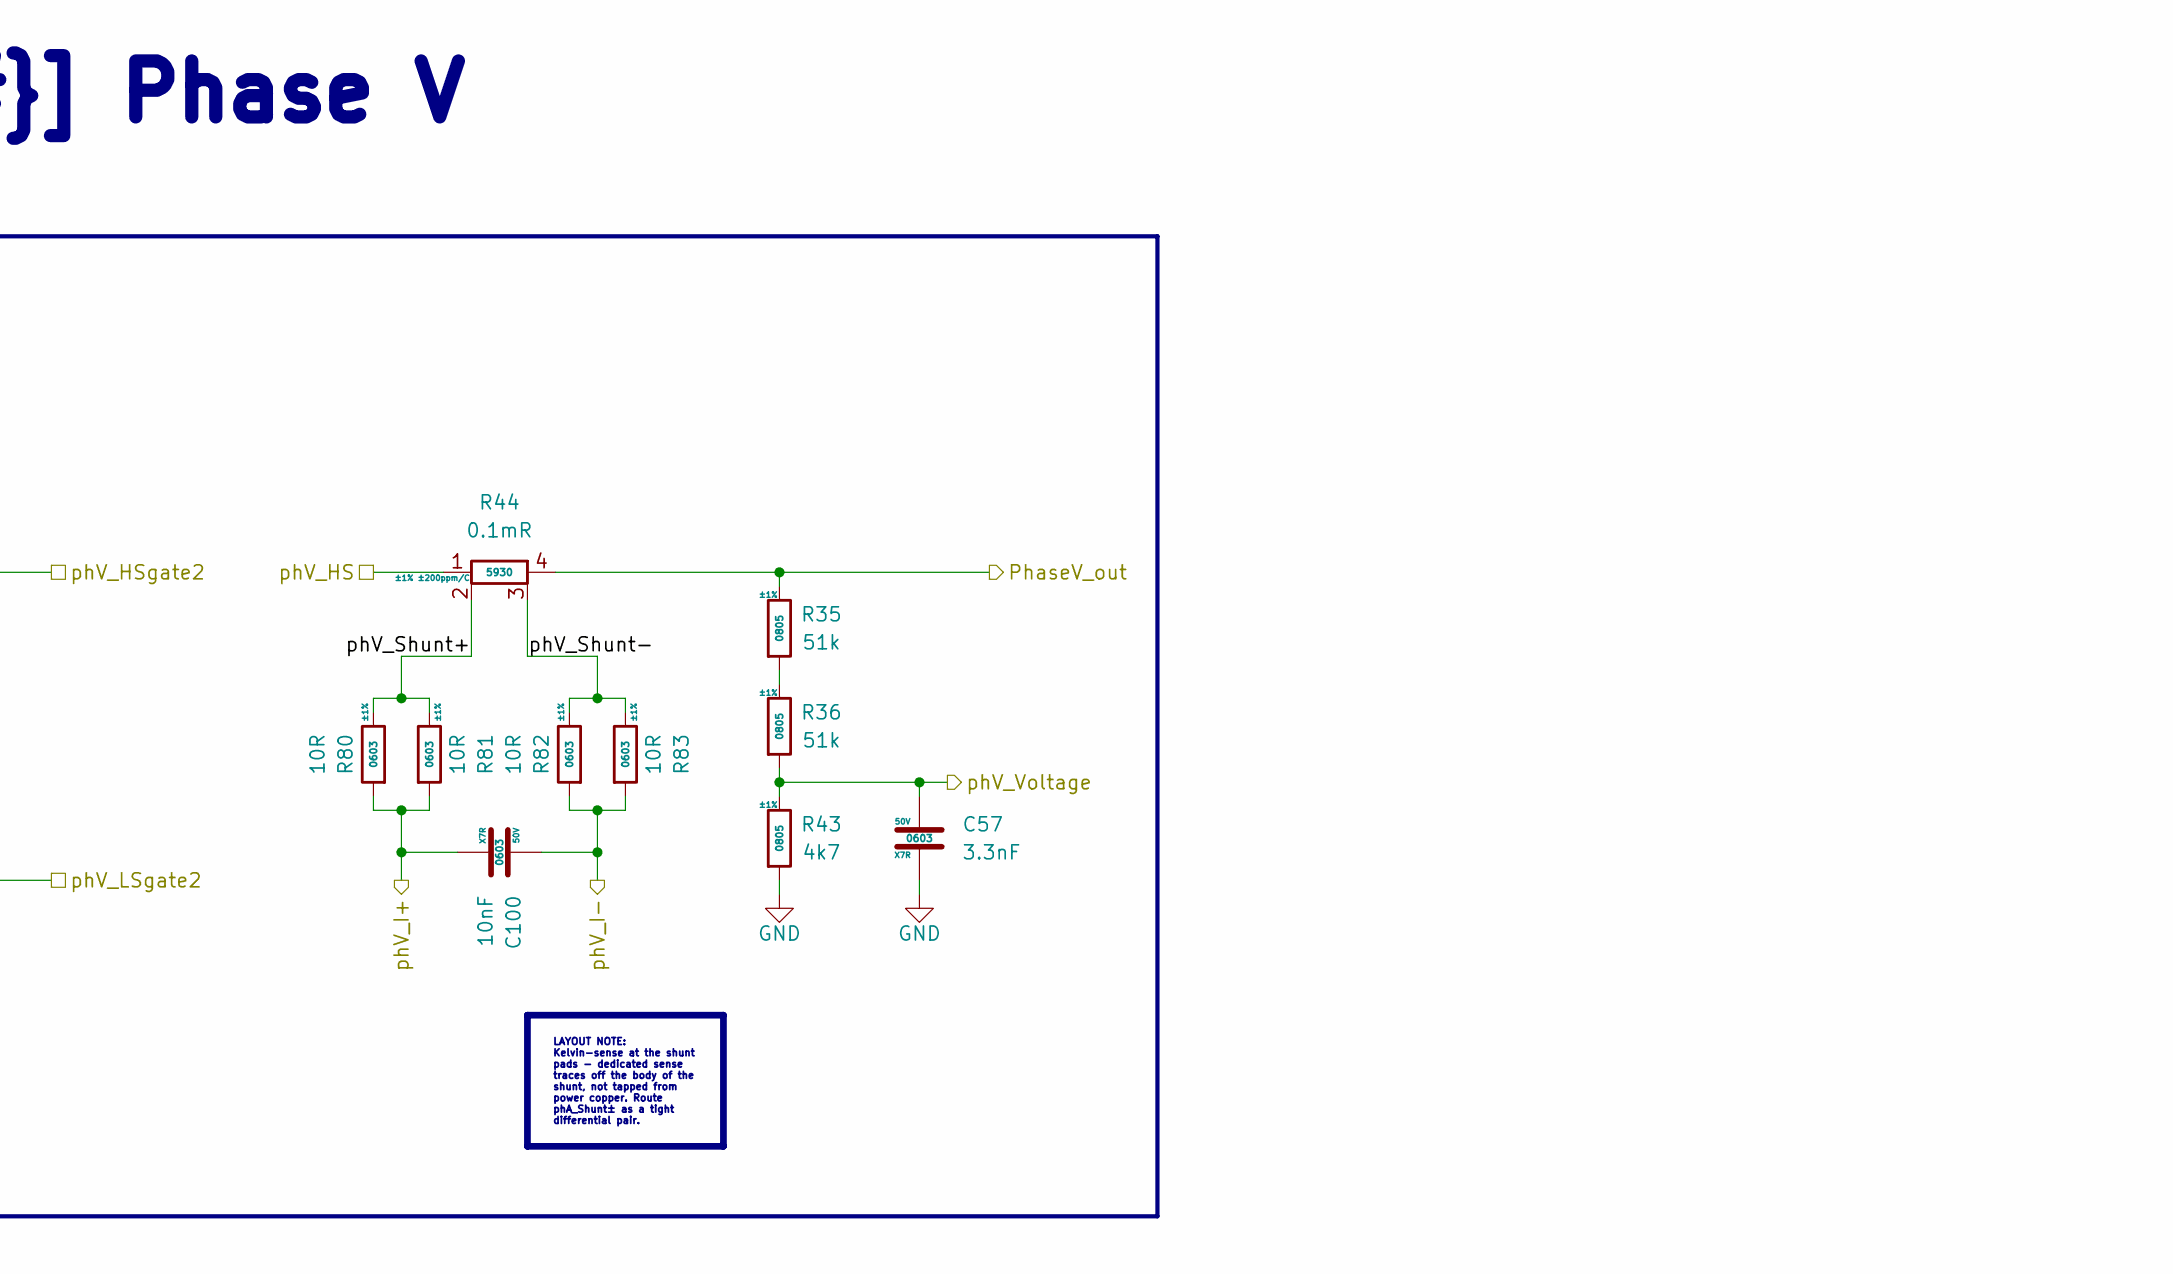
[picture p37: schematic PhaseV.kicad_sch, part in row 1, column 2]

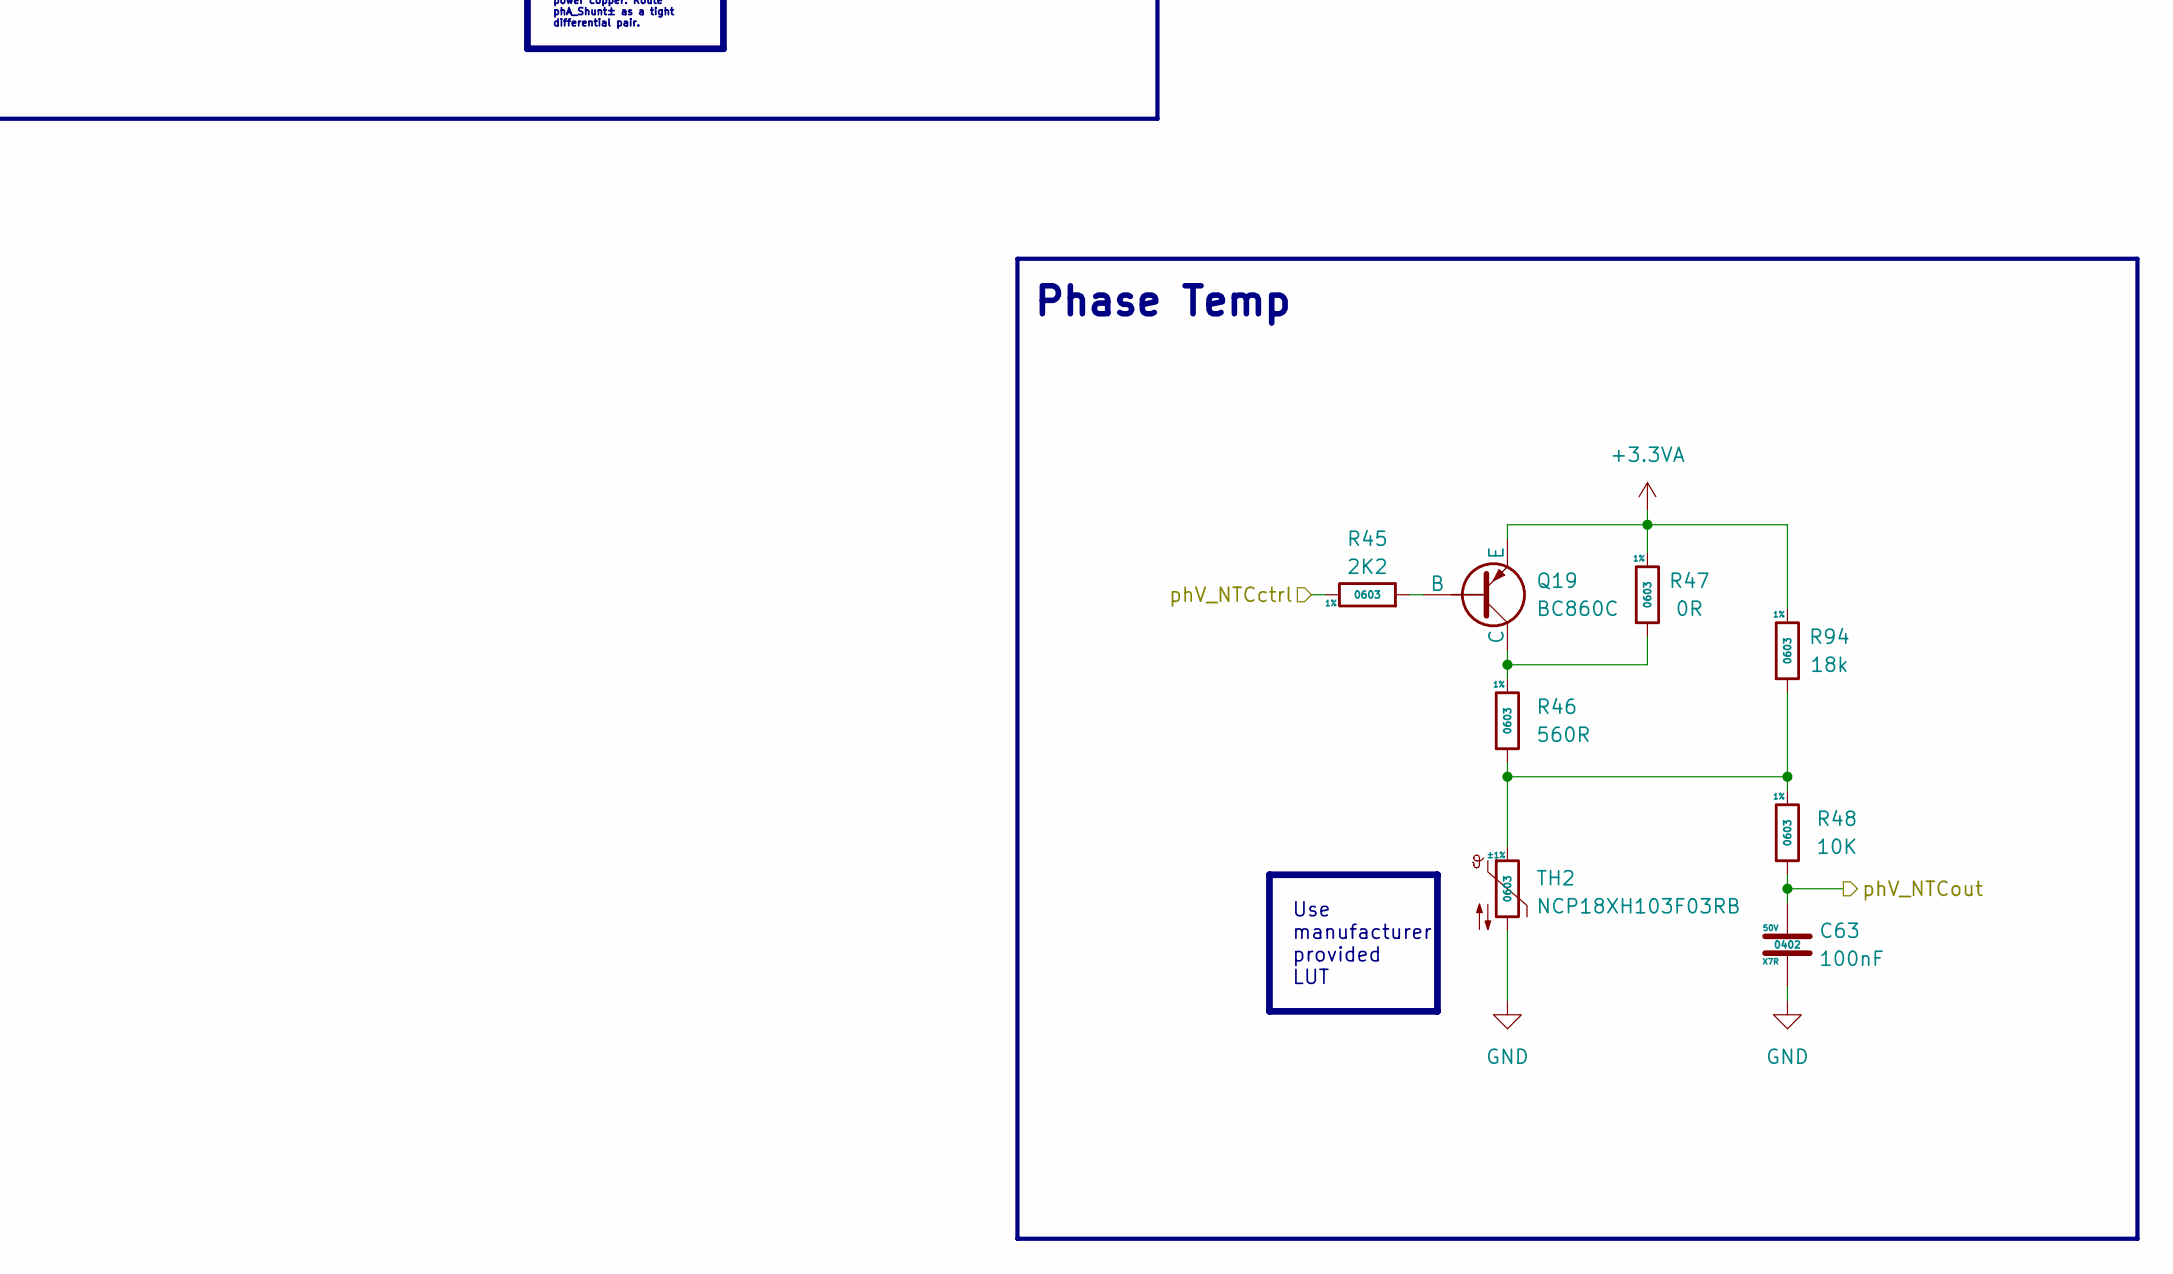
[picture p38: schematic PhaseV.kicad_sch, part in row 2, column 2]

Parts:
C57: 3.3nF; C_0603_1608Metric; Voltage 50V; MFR.Part # CL10B332KB8NNNC; JLCPCB Part # C1613
C63: 100nF; C_0402_1005Metric; Voltage rating 50V; MFR.Part # CL05B104KB54PNC; JLCPCB Part # C307331
C100: 10nF; C_0603_1608Metric; Voltage 50V; MFR.Part # 0603B103K500NT; JLCPCB Part # C57112
C105: C; C_Rect_L9.0mm_W6.4mm_P7.50mm_MKT; not fitted
D6, D7, D8, D9: SS34; D_SMA; JLCPCB Part # C8678
Q6, Q7, Q8, Q9: IPT015N10N5; Infineon_PG-HSOF-8-1_ThermalVias; JLCPCB Part # C108964
Q19: BC860C; SOT-23; JLCPCB Part # C49309303
R28, R29, R37, R38: 1R; R_1206_3216Metric; Tolerance ±1%; MFR.Part # 1206W4F100KT5E; JLCPCB Part # C17928
R30, R31, R39, R40: 3R3; R_1206_3216Metric; Tolerance ±1%; MFR.Part # NS06W4F330KT5E; JLCPCB Part # C2783335
R32, R33, R41, R42: 10k; R_1206_3216Metric; Tolerance ±1%; MFR.Part # 1206W4F1002T5E; JLCPCB Part # C17902
R35, R36: 51k; R_0805_2012Metric; Tolerance ±1%; MFR.Part # 0805W8F5102T5E; JLCPCB Part # C17737
R43: 4k7; R_0805_2012Metric; Tolerance ±1%; MFR.Part # 0805W8F4701T5E; JLCPCB Part # C17673
R44: 0.1mR; R5930; Tolerance ±1% ±200ppm/C; MFR.Part # ASR-S-7-0.1F; JLCPCB Part # C6075508
R45: 2K2; R_0603_1608Metric; Tolerance 1%; MFR.Part # 0603WAF2201T5E; JLCPCB Part # C4190
R46: 560R; R_0603_1608Metric; Tolerance 1%; MFR.Part # 0603WAF5600T5E; JLCPCB Part # C23204
R47: 0R; R_0603_1608Metric; Tolerance 1%; MFR.Part # 0603WAF0000T5E; JLCPCB Part # C21189
R48: 10K; R_0603_1608Metric; Tolerance 1%; MFR.Part # 0603WAF1002T5E; JLCPCB Part # C25804
R80, R81, R82, R83: 10R; R_0805_2012Metric; Tolerance ±1%; MFR.Part # 0603WAF100JT5E; JLCPCB Part # C22859
R91: R; R_1218_3246Metric; not fitted
R94: 18k; R_0603_1608Metric; Tolerance 1%; MFR.Part # 0603WAF1802T5E; JLCPCB Part # C25810
TH2: NCP18XH103F03RB; R_0603_1608Metric; Tolerance ±1%; JLCPCB Part # C13564

Connections:
+3.3VA: Q19.3 (E), R47.1, R94.1; also elsewhere on the board
+VSYS: Q6.3, Q8.3; also elsewhere on the board
/Project Architecture/Phase V/PhaseV_out: R35.1, R44.4; also elsewhere on the board
/Project Architecture/Phase V/phV_HS: Q6.2, Q7.3, Q8.2, Q9.3, R32.2, R41.2, R44.1, R91.1; also elsewhere on the board
/Project Architecture/Phase V/phV_HSgate1: R28.1, R30.1; also elsewhere on the board
/Project Architecture/Phase V/phV_HSgate2: R37.1, R39.1; also elsewhere on the board
/Project Architecture/Phase V/phV_I+: C100.2, R80.2, R81.2; also elsewhere on the board
/Project Architecture/Phase V/phV_I-: C100.1, R82.2, R83.2; also elsewhere on the board
/Project Architecture/Phase V/phV_LSgate1: R29.1, R31.1; also elsewhere on the board
/Project Architecture/Phase V/phV_LSgate2: R38.1, R40.1; also elsewhere on the board
/Project Architecture/Phase V/phV_NTCctrl: R45.1; also elsewhere on the board
/Project Architecture/Phase V/phV_NTCout: C63.1, R48.2; also elsewhere on the board
/Project Architecture/Phase V/phV_Shunt+: R44.2, R80.1, R81.1
/Project Architecture/Phase V/phV_Shunt-: R44.3, R82.1, R83.1
/Project Architecture/Phase V/phV_Voltage: C57.1, R36.2, R43.1; also elsewhere on the board
GND: C57.2, C63.2, C105.2, Q7.2, Q9.2, R33.2, R42.2, R43.2, TH2.2; also elsewhere on the board
unnamed: C105.1, R91.2
unnamed: D6.2 (A), Q6.1, R30.2, R32.1
unnamed: D6.1 (K), R28.2
unnamed: D7.2 (A), Q7.1, R31.2, R33.1
unnamed: D7.1 (K), R29.2
unnamed: D8.2 (A), Q8.1, R39.2, R41.1
unnamed: D8.1 (K), R37.2
unnamed: D9.2 (A), Q9.1, R40.2, R42.1
unnamed: D9.1 (K), R38.2
unnamed: Q19.2 (B), R45.2
unnamed: Q19.1 (C), R46.1, R47.2
unnamed: R35.2, R36.1
unnamed: R46.2, R48.1, R94.2, TH2.1

Notes on the sheet:
Gate driver & bridge
Phase Temp
LAYOUT NOTE: Kelvin-sense at the shunt pads - dedicated sense traces off the body of the shunt, not tapped from power copper. Route phA_Shunt± as a tight differential pair.
Use manufacturer provided LUT
[${#}] Phase V
