bvrny/Vortex/PCBA-FLUX-01A/_restore_backup_2026-08-26T13-48-18-741/PCBA-FLUX-01A.kicad_pcb

## KiCad design PCBA-FLUX-01A/_restore_backup_2026-08-26T13-48-18-741/PCBA-FLUX-01A.kicad_pcb (continued)

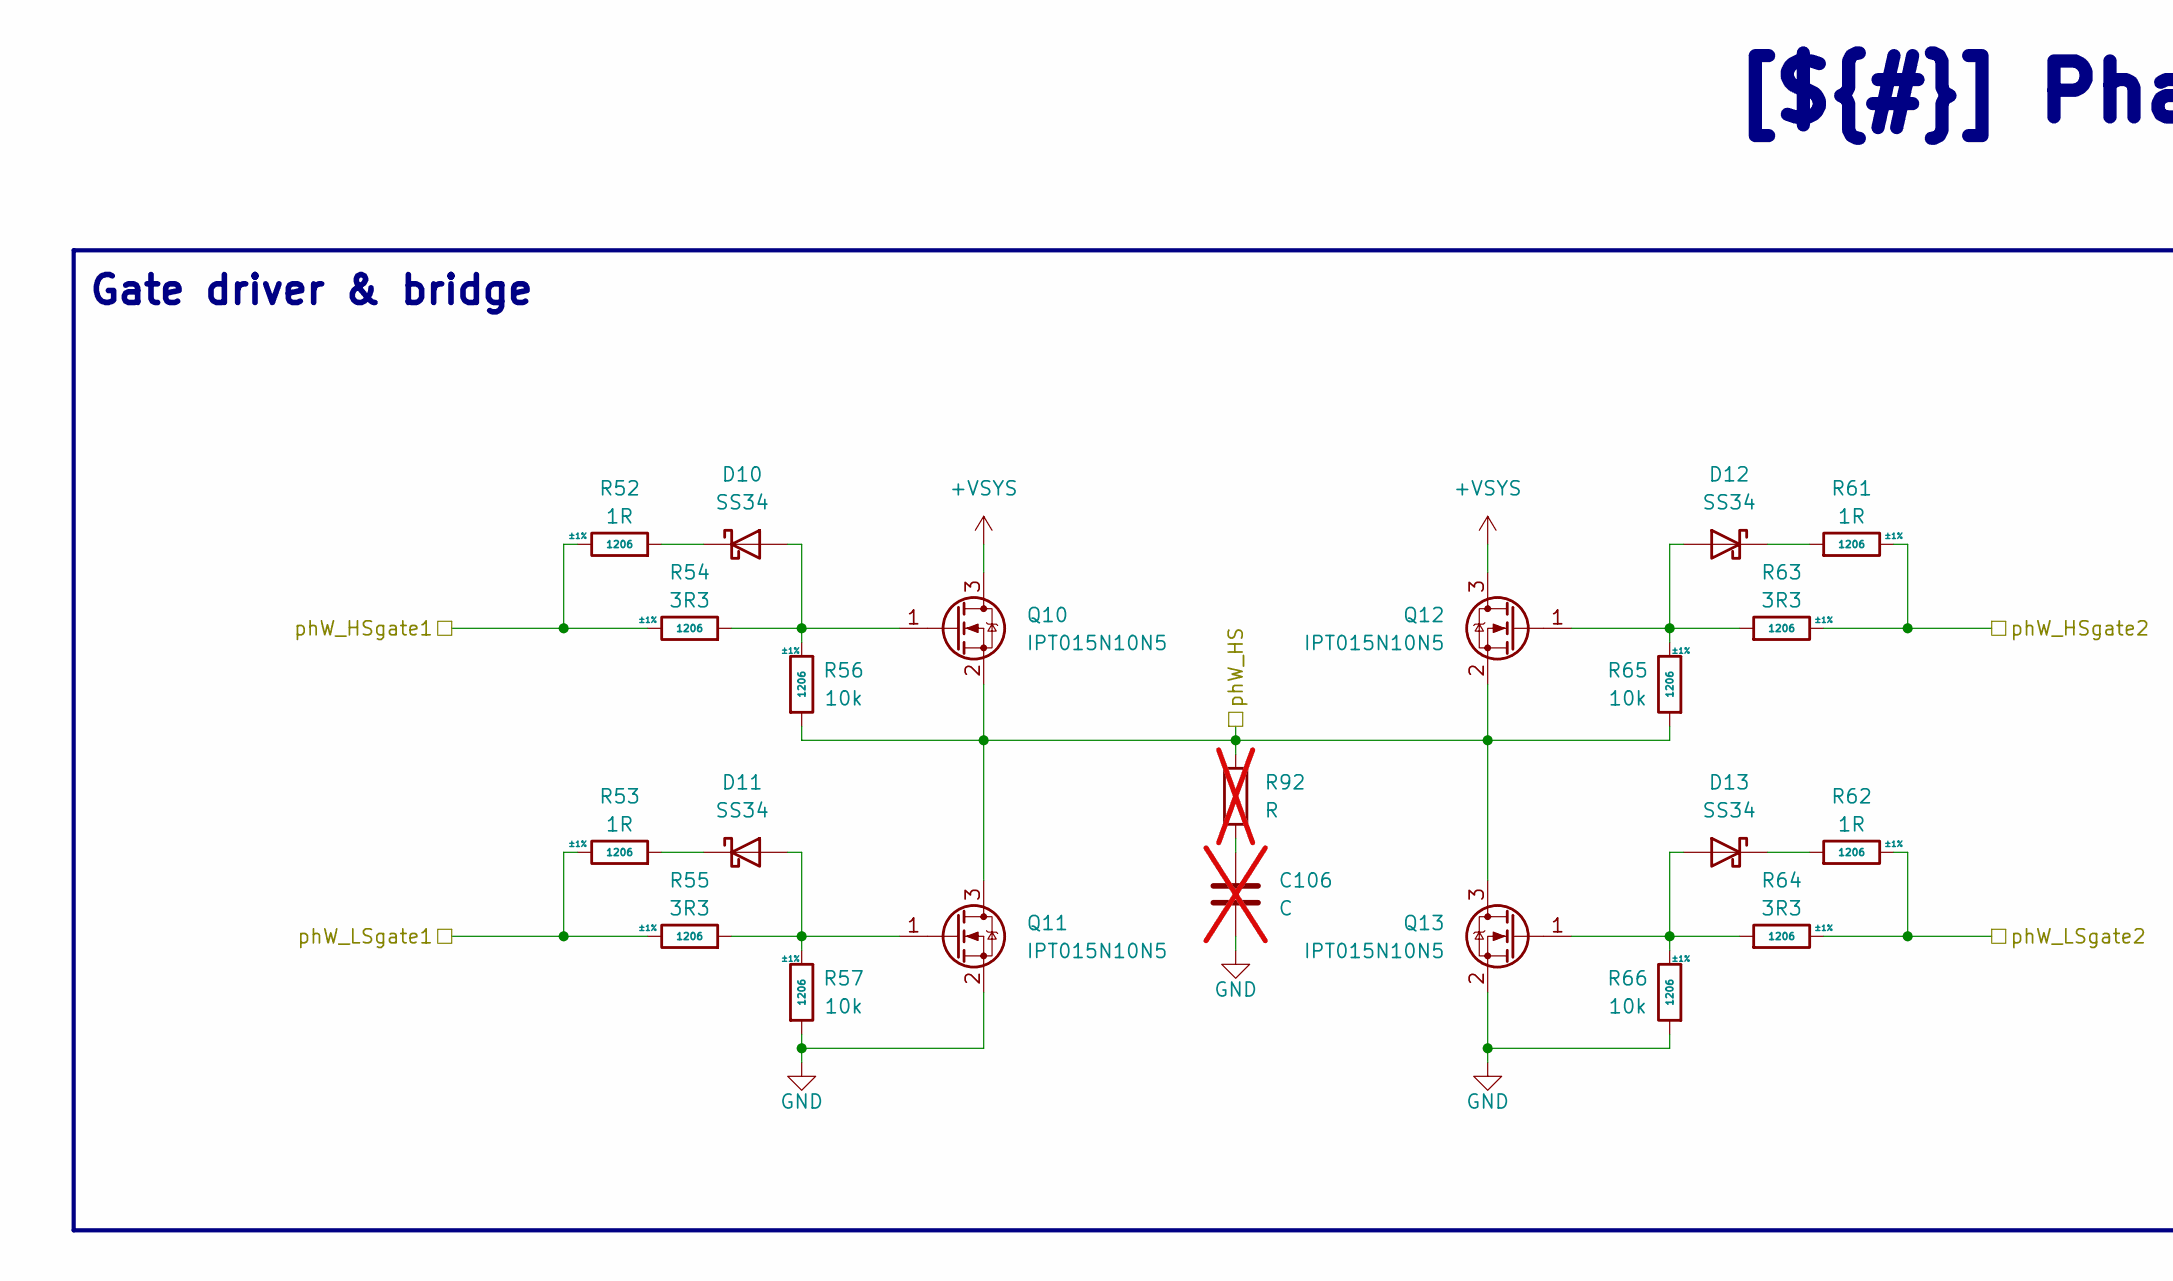
[picture p39: schematic PhaseW.kicad_sch, part in row 1, column 1]

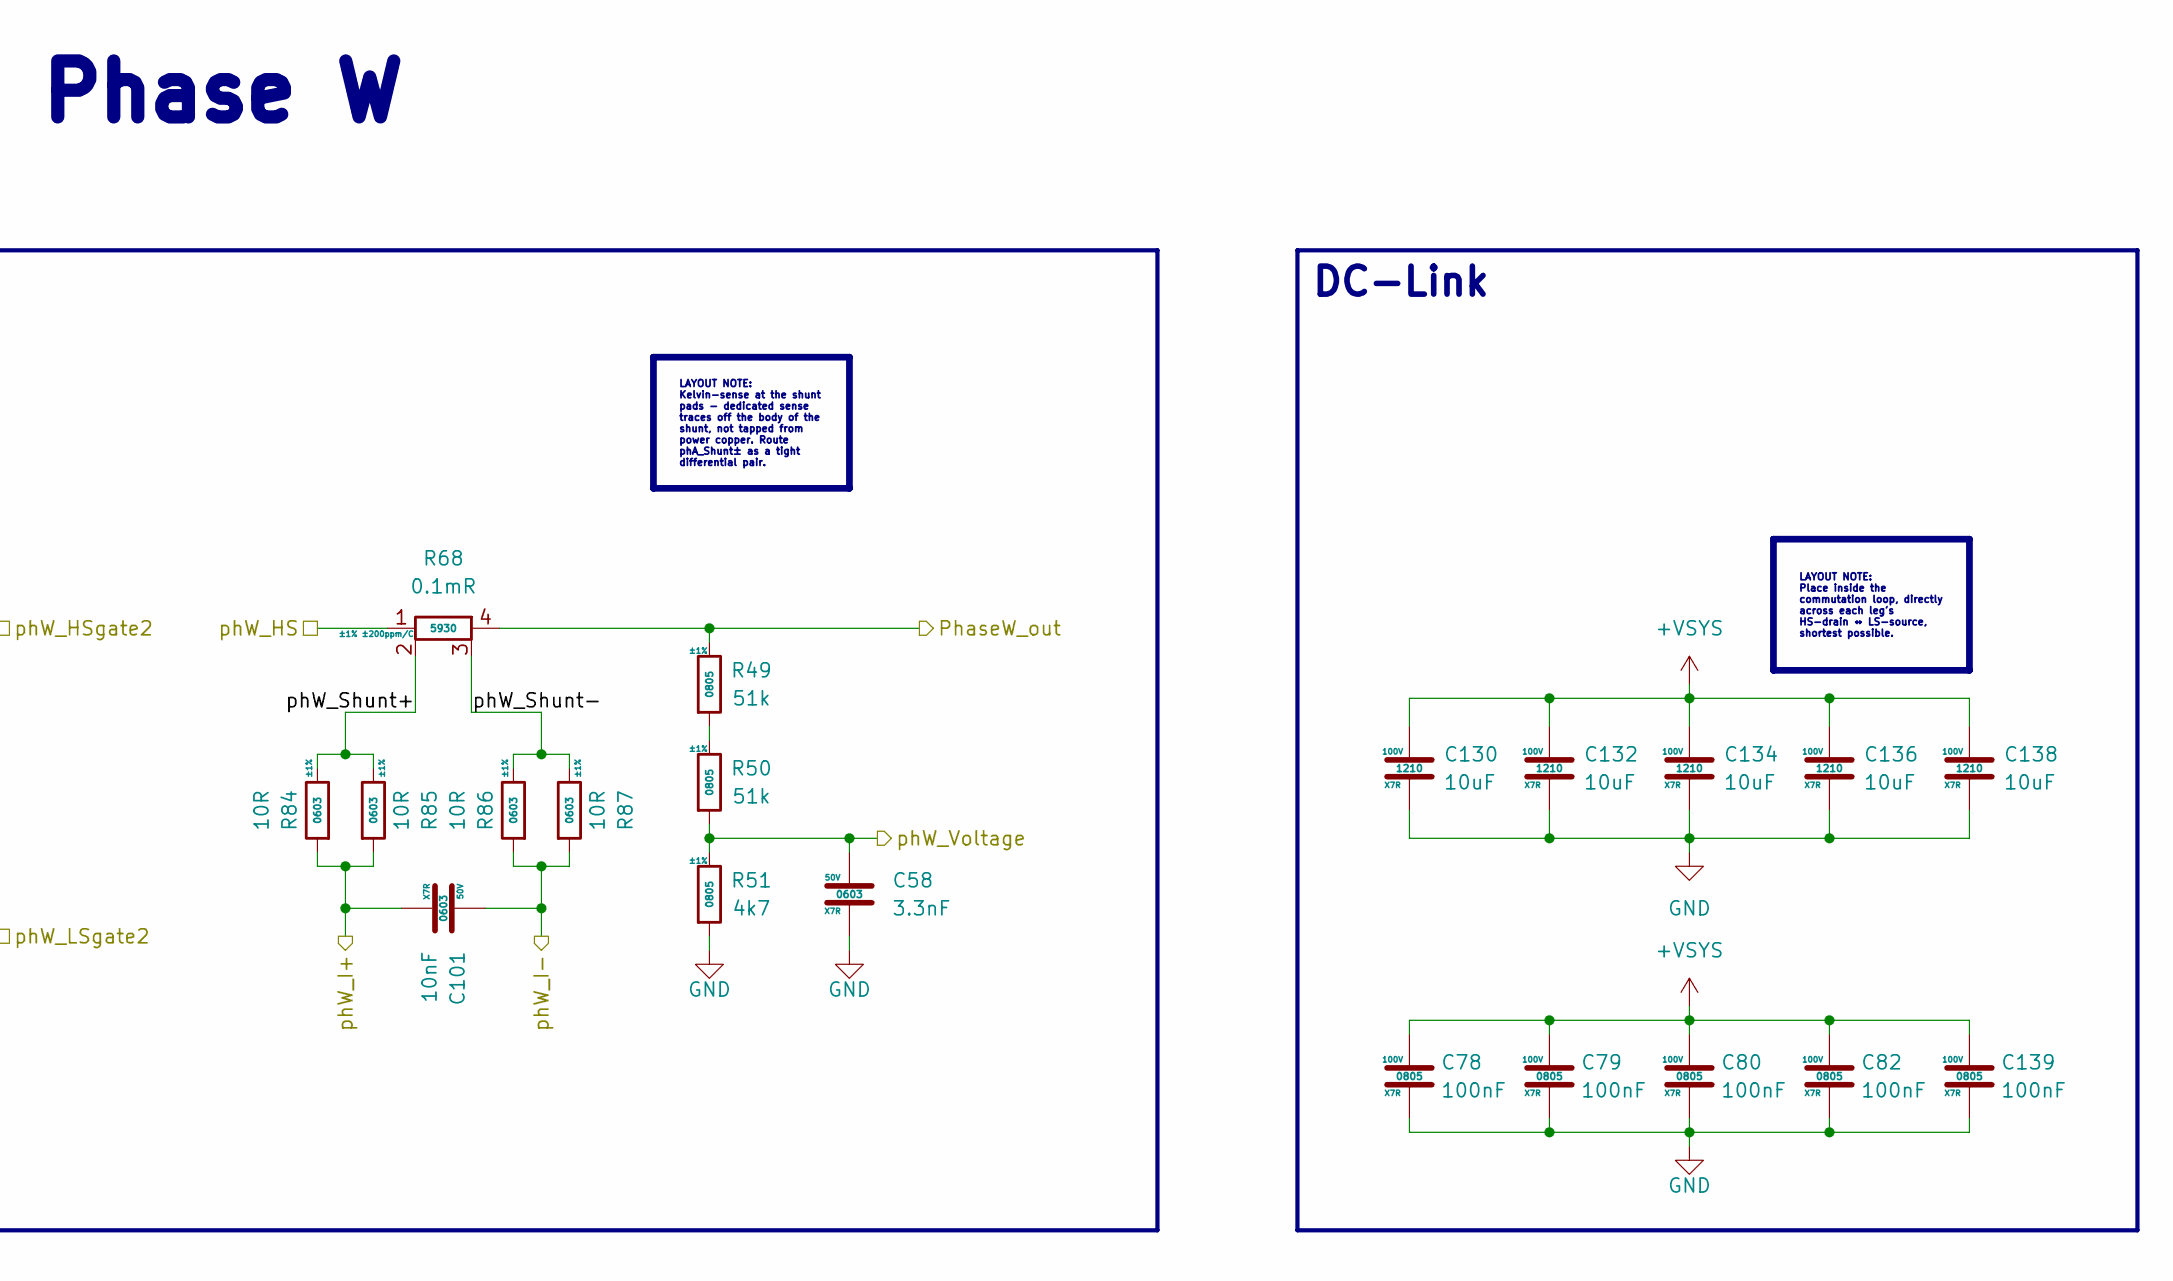
[picture p40: schematic PhaseW.kicad_sch, part in row 1, column 2]

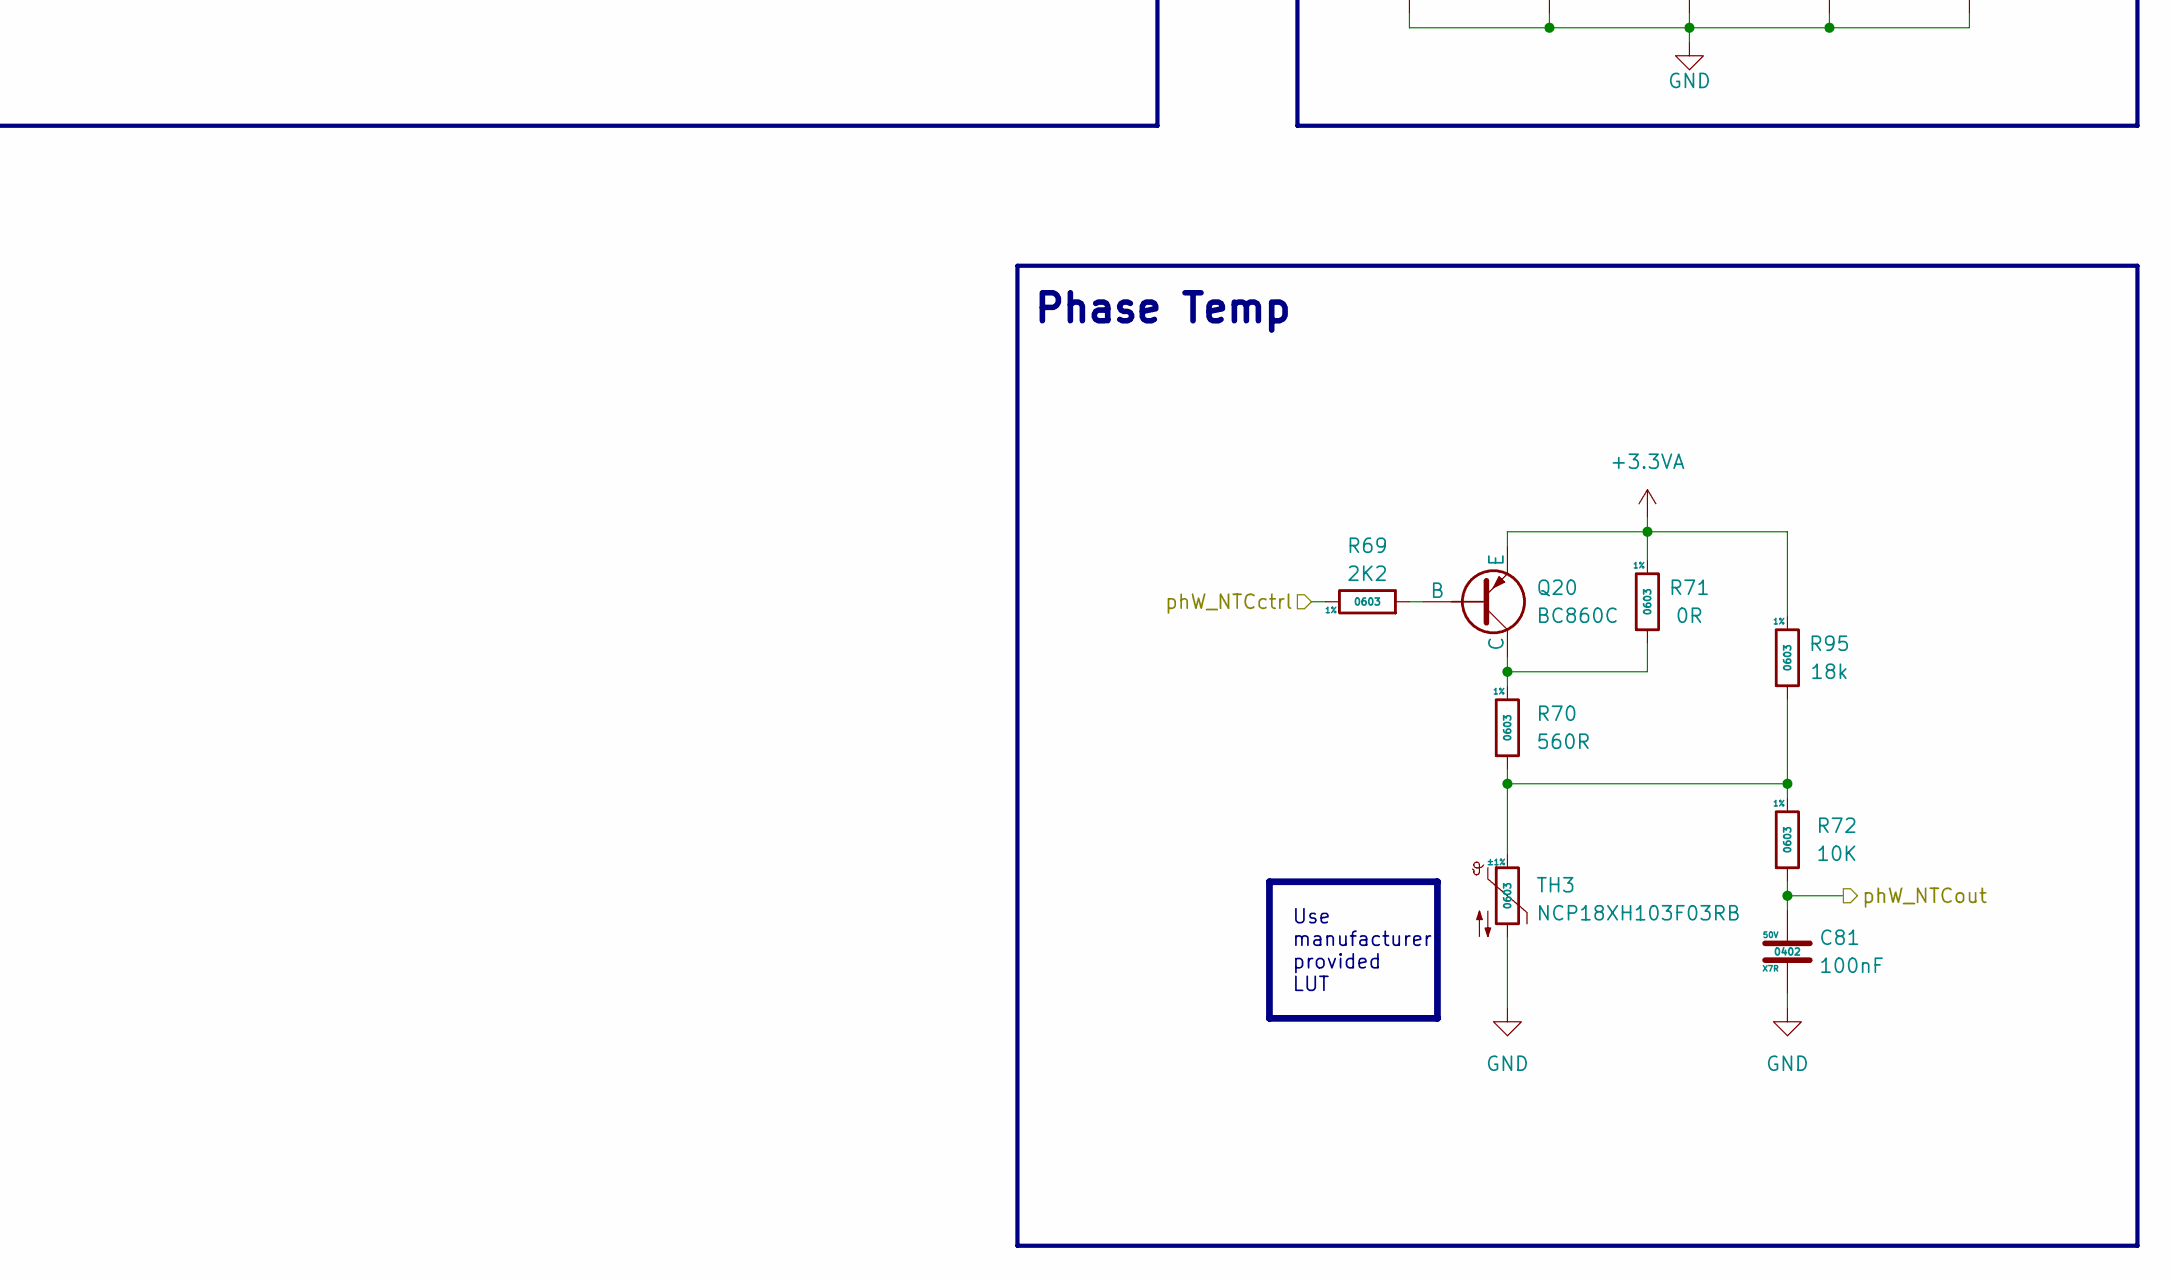
[picture p41: schematic PhaseW.kicad_sch, part in row 2, column 2]

Parts:
C58: 3.3nF; C_0603_1608Metric; Voltage 50V; MFR.Part # CL10B332KB8NNNC; JLCPCB Part # C1613
C78, C79, C80, C82, C139: 100nF; C_0805_2012Metric; Voltage 100V; MFR.Part # CL21B104KCFNNNE; JLCPCB Part # C28233
C81: 100nF; C_0402_1005Metric; Voltage rating 50V; MFR.Part # CL05B104KB54PNC; JLCPCB Part # C307331
C101: 10nF; C_0603_1608Metric; Voltage 50V; MFR.Part # 0603B103K500NT; JLCPCB Part # C57112
C106: C; C_Rect_L9.0mm_W6.4mm_P7.50mm_MKT; not fitted
C130, C132, C134, C136, C138: 10uF; C_1210_3225Metric; Voltage 100V; MFR.Part # FS32X106K101EGG; JLCPCB Part # C5156756
D10, D11, D12, D13: SS34; D_SMA; JLCPCB Part # C8678
Q10, Q11, Q12, Q13: IPT015N10N5; Infineon_PG-HSOF-8-1_ThermalVias; JLCPCB Part # C108964
Q20: BC860C; SOT-23; JLCPCB Part # C49309303
R49, R50: 51k; R_0805_2012Metric; Tolerance ±1%; MFR.Part # 0805W8F5102T5E; JLCPCB Part # C17737
R51: 4k7; R_0805_2012Metric; Tolerance ±1%; MFR.Part # 0805W8F4701T5E; JLCPCB Part # C17673
R52, R53, R61, R62: 1R; R_1206_3216Metric; Tolerance ±1%; MFR.Part # 1206W4F100KT5E; JLCPCB Part # C17928
R54, R55, R63, R64: 3R3; R_1206_3216Metric; Tolerance ±1%; MFR.Part # NS06W4F330KT5E; JLCPCB Part # C2783335
R56, R57, R65, R66: 10k; R_1206_3216Metric; Tolerance ±1%; MFR.Part # 1206W4F1002T5E; JLCPCB Part # C17902
R68: 0.1mR; R5930; Tolerance ±1% ±200ppm/C; MFR.Part # ASR-S-7-0.1F; JLCPCB Part # C6075508
R69: 2K2; R_0603_1608Metric; Tolerance 1%; MFR.Part # 0603WAF2201T5E; JLCPCB Part # C4190
R70: 560R; R_0603_1608Metric; Tolerance 1%; MFR.Part # 0603WAF5600T5E; JLCPCB Part # C23204
R71: 0R; R_0603_1608Metric; Tolerance 1%; MFR.Part # 0603WAF0000T5E; JLCPCB Part # C21189
R72: 10K; R_0603_1608Metric; Tolerance 1%; MFR.Part # 0603WAF1002T5E; JLCPCB Part # C25804
R84, R85, R86, R87: 10R; R_0805_2012Metric; Tolerance ±1%; MFR.Part # 0603WAF100JT5E; JLCPCB Part # C22859
R92: R; R_1218_3246Metric; not fitted
R95: 18k; R_0603_1608Metric; Tolerance 1%; MFR.Part # 0603WAF1802T5E; JLCPCB Part # C25810
TH3: NCP18XH103F03RB; R_0603_1608Metric; Tolerance ±1%; JLCPCB Part # C13564

Connections:
+3.3VA: Q20.3 (E), R71.1, R95.1; also elsewhere on the board
+VSYS: C78.1, C79.1, C80.1, C82.1, C130.1, C132.1, C134.1, C136.1, C138.1, C139.1, Q10.3, Q12.3; also elsewhere on the board
/Project Architecture/Phase W/PhaseW_out: R49.1, R68.4; also elsewhere on the board
/Project Architecture/Phase W/phW_HS: Q10.2, Q11.3, Q12.2, Q13.3, R56.2, R65.2, R68.1, R92.1; also elsewhere on the board
/Project Architecture/Phase W/phW_HSgate1: R52.1, R54.1; also elsewhere on the board
/Project Architecture/Phase W/phW_HSgate2: R61.1, R63.1; also elsewhere on the board
/Project Architecture/Phase W/phW_I+: C101.2, R84.2, R85.2; also elsewhere on the board
/Project Architecture/Phase W/phW_I-: C101.1, R86.2, R87.2; also elsewhere on the board
/Project Architecture/Phase W/phW_LSgate1: R53.1, R55.1; also elsewhere on the board
/Project Architecture/Phase W/phW_LSgate2: R62.1, R64.1; also elsewhere on the board
/Project Architecture/Phase W/phW_NTCctrl: R69.1; also elsewhere on the board
/Project Architecture/Phase W/phW_NTCout: C81.1, R72.2; also elsewhere on the board
/Project Architecture/Phase W/phW_Shunt+: R68.2, R84.1, R85.1
/Project Architecture/Phase W/phW_Shunt-: R68.3, R86.1, R87.1
/Project Architecture/Phase W/phW_Voltage: C58.1, R50.2, R51.1; also elsewhere on the board
GND: C58.2, C78.2, C79.2, C80.2, C81.2, C82.2, C106.2, C130.2, C132.2, C134.2, C136.2, C138.2, C139.2, Q11.2, Q13.2, R51.2, R57.2, R66.2, TH3.2; also elsewhere on the board
unnamed: C106.1, R92.2
unnamed: D10.2 (A), Q10.1, R54.2, R56.1
unnamed: D10.1 (K), R52.2
unnamed: D11.2 (A), Q11.1, R55.2, R57.1
unnamed: D11.1 (K), R53.2
unnamed: D12.2 (A), Q12.1, R63.2, R65.1
unnamed: D12.1 (K), R61.2
unnamed: D13.2 (A), Q13.1, R64.2, R66.1
unnamed: D13.1 (K), R62.2
unnamed: Q20.2 (B), R69.2
unnamed: Q20.1 (C), R70.1, R71.2
unnamed: R49.2, R50.1
unnamed: R70.2, R72.1, R95.2, TH3.1

Notes on the sheet:
Gate driver & bridge
Phase Temp
DC-Link
LAYOUT NOTE: Kelvin-sense at the shunt pads - dedicated sense traces off the body of the shunt, not tapped from power copper. Route phA_Shunt± as a tight differential pair.
Use manufacturer provided LUT
LAYOUT NOTE: Place inside the commutation loop, directly across each leg's HS-drain ↔ LS-source, shortest possible.
[${#}] Phase W

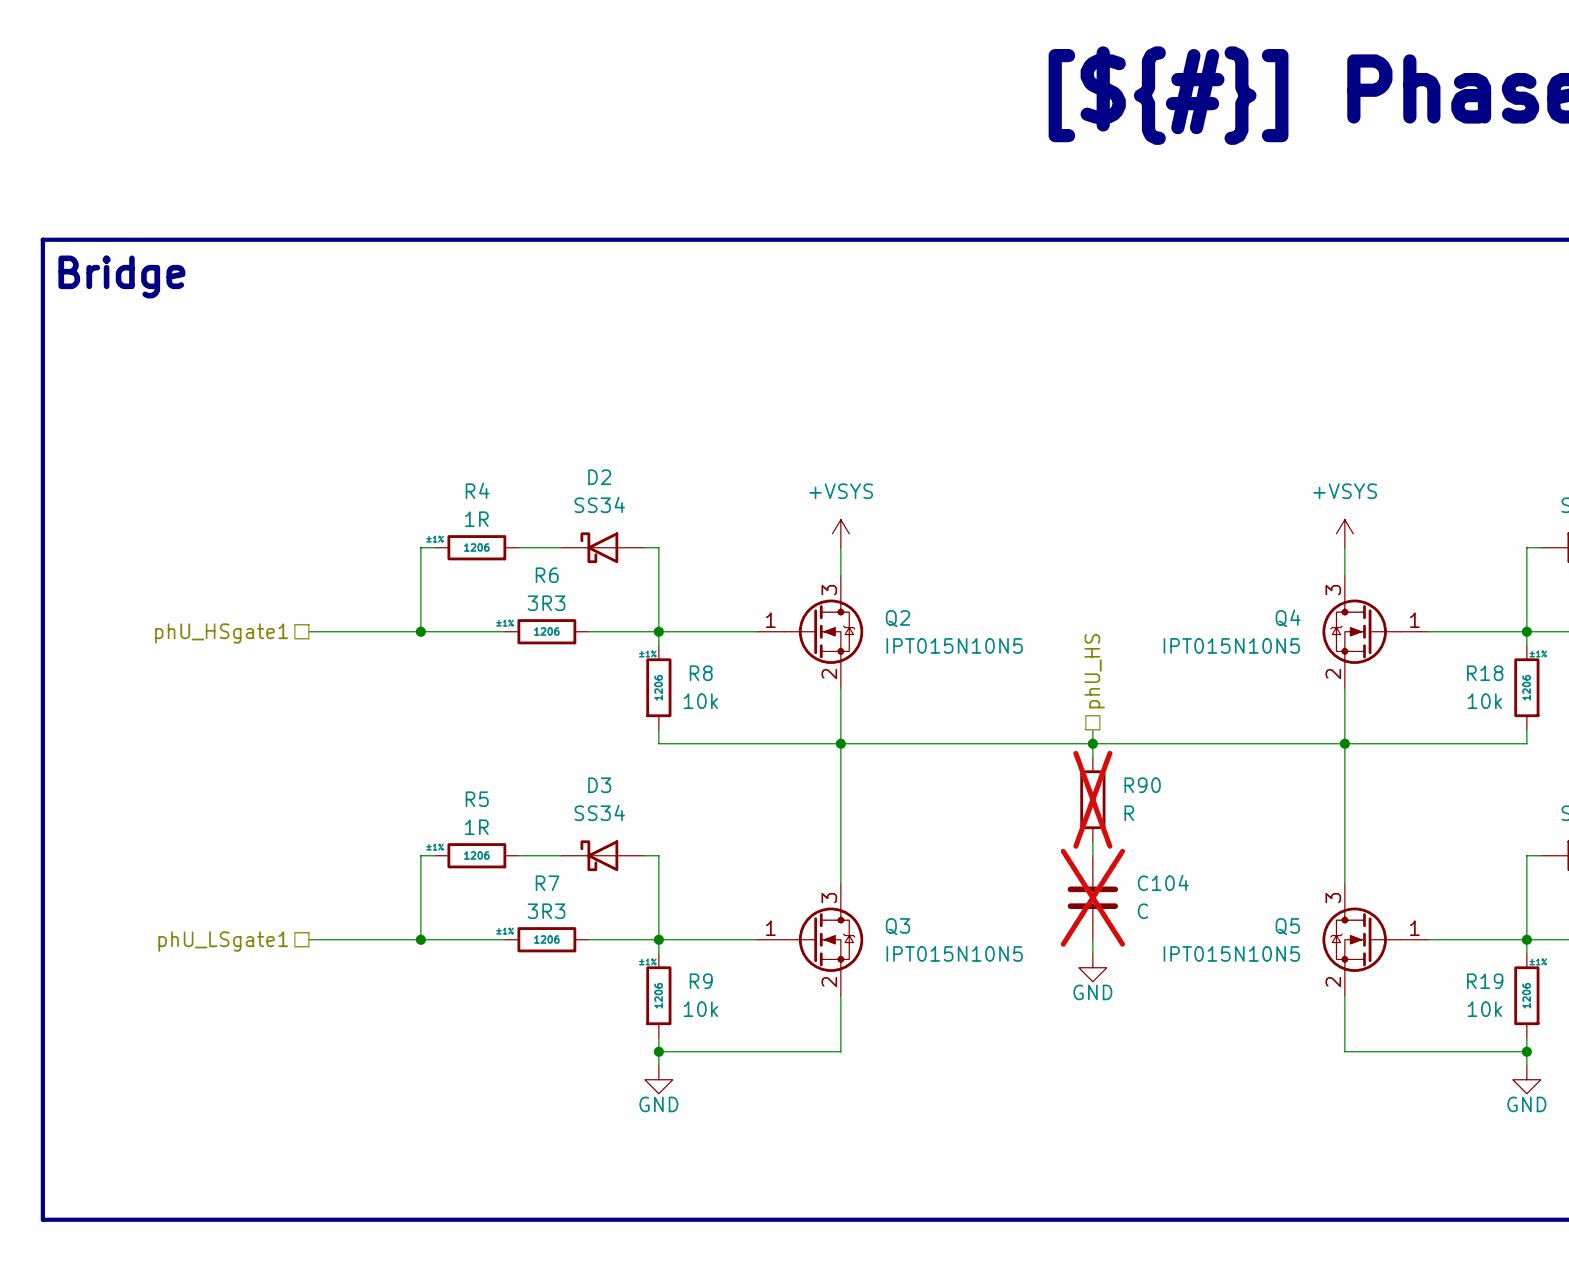
[picture p42: schematic PhaseU.kicad_sch, part in row 1, column 1]

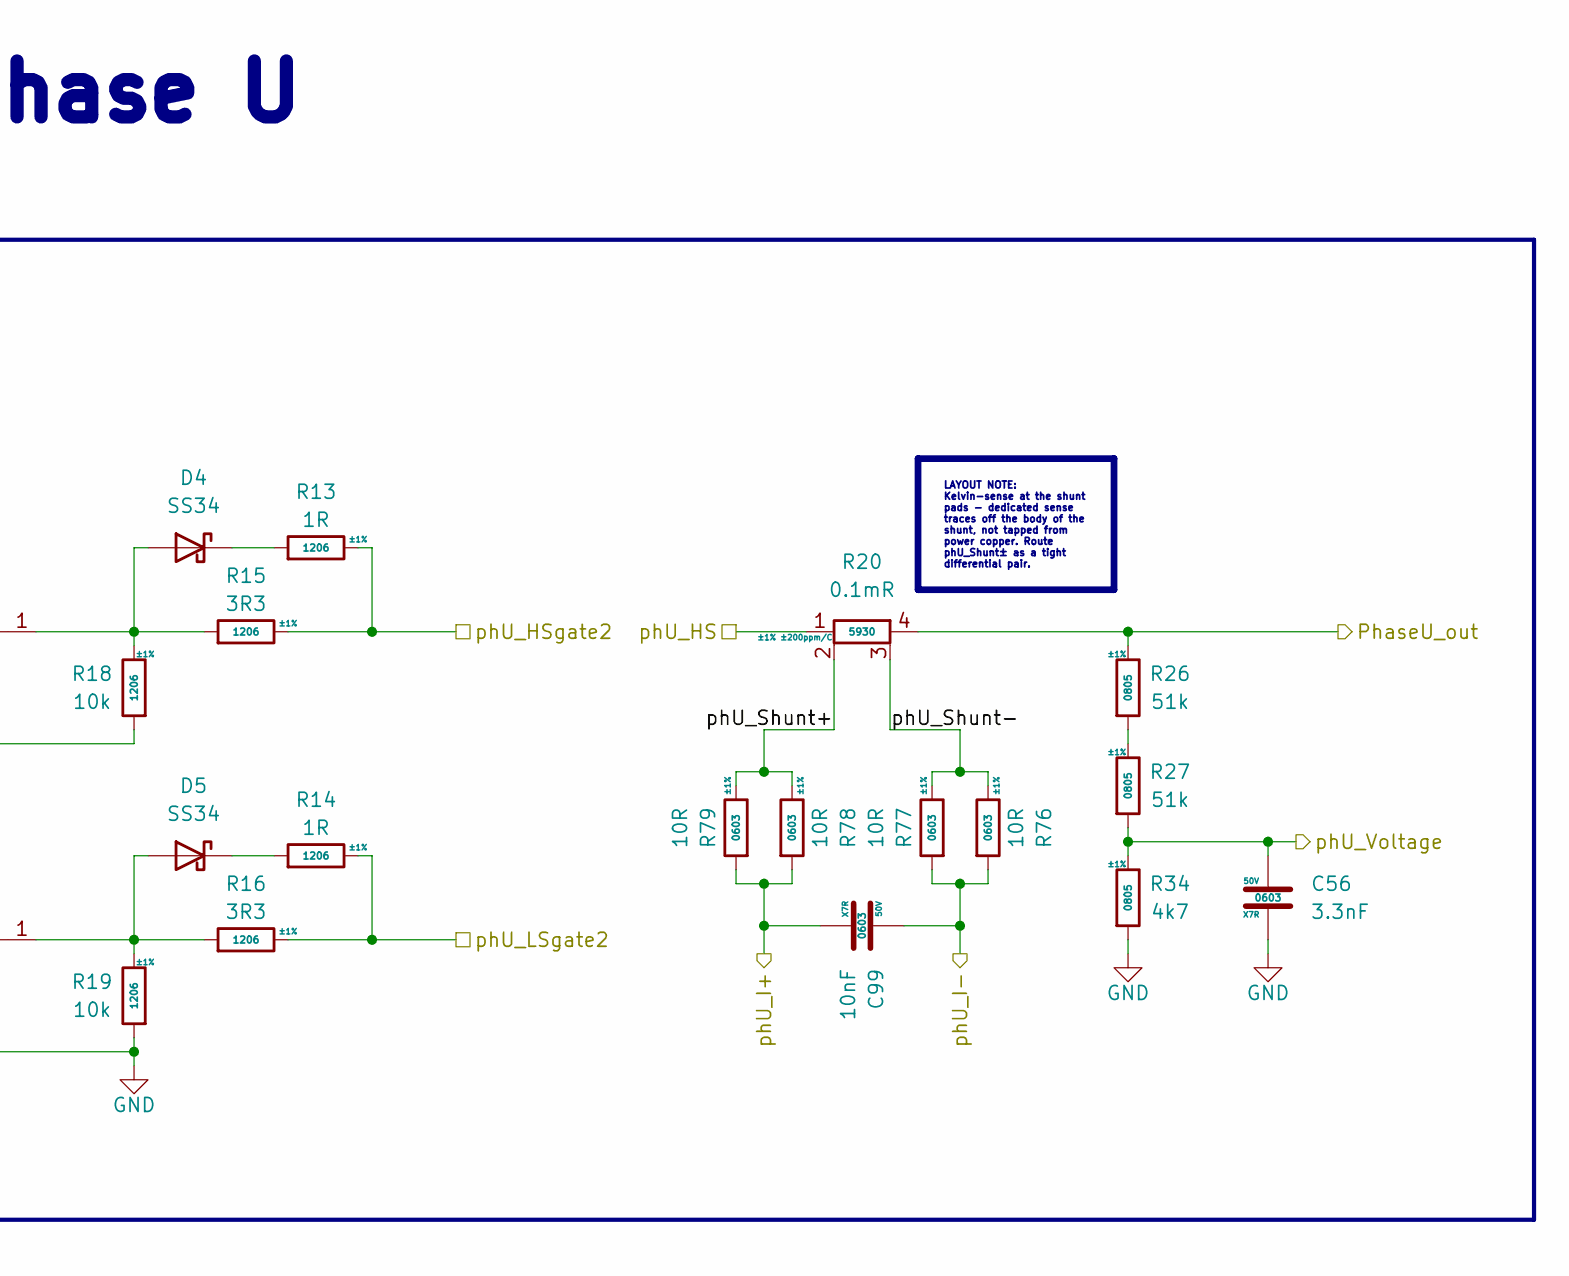
[picture p43: schematic PhaseU.kicad_sch, part in row 1, column 2]

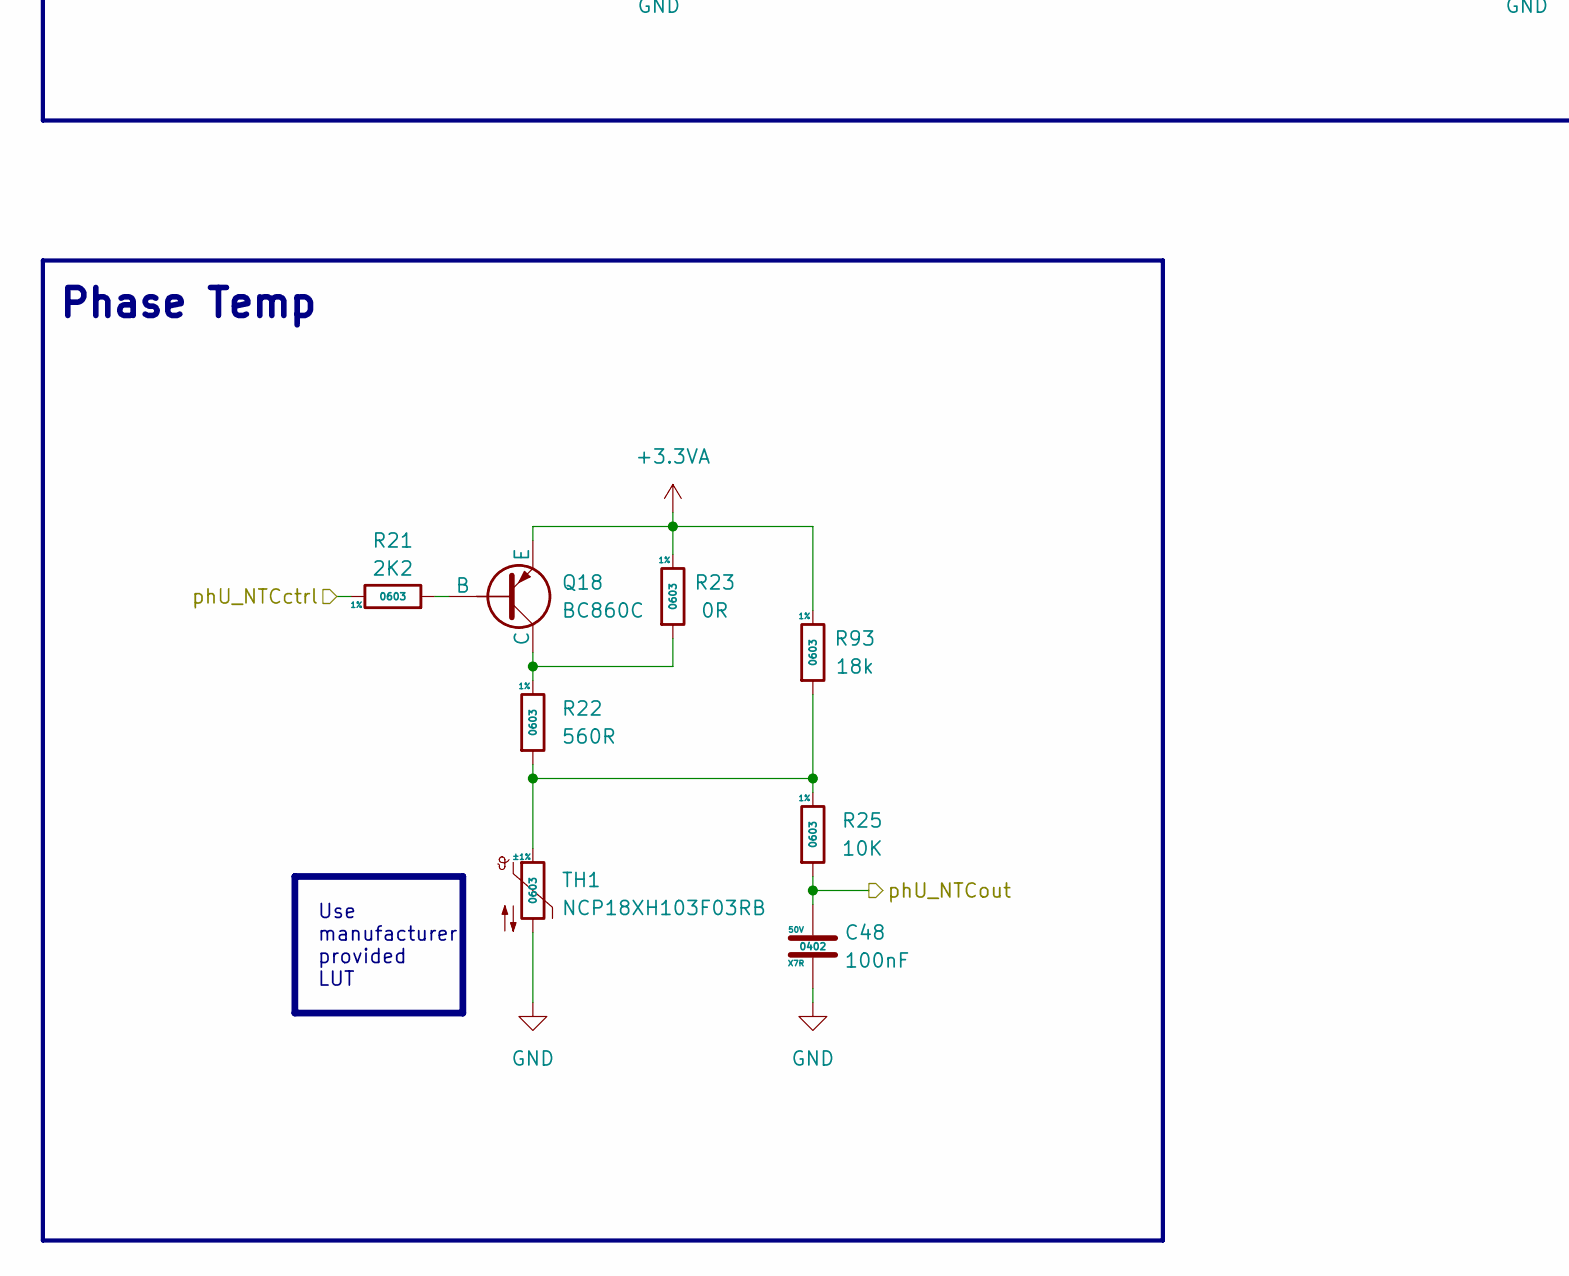
[picture p44: schematic PhaseU.kicad_sch, part in row 2, column 1]

Parts:
C48: 100nF; C_0402_1005Metric; Voltage rating 50V; MFR.Part # CL05B104KB54PNC; JLCPCB Part # C307331
C56: 3.3nF; C_0603_1608Metric; Voltage 50V; MFR.Part # CL10B332KB8NNNC; JLCPCB Part # C1613
C99: 10nF; C_0603_1608Metric; Voltage 50V; MFR.Part # 0603B103K500NT; JLCPCB Part # C57112
C104: C; C_Rect_L9.0mm_W6.4mm_P7.50mm_MKT; not fitted
D2, D3, D4, D5: SS34; D_SMA; JLCPCB Part # C8678
Q2, Q3, Q4, Q5: IPT015N10N5; Infineon_PG-HSOF-8-1_ThermalVias; JLCPCB Part # C108964
Q18: BC860C; SOT-23; JLCPCB Part # C49309303
R4, R5, R13, R14: 1R; R_1206_3216Metric; Tolerance ±1%; MFR.Part # 1206W4F100KT5E; JLCPCB Part # C17928
R6, R7, R15, R16: 3R3; R_1206_3216Metric; Tolerance ±1%; MFR.Part # NS06W4F330KT5E; JLCPCB Part # C2783335
R8, R9, R18, R19: 10k; R_1206_3216Metric; Tolerance ±1%; MFR.Part # 1206W4F1002T5E; JLCPCB Part # C17902
R20: 0.1mR; R5930; Tolerance ±1% ±200ppm/C; MFR.Part # ASR-S-7-0.1F; JLCPCB Part # C6075508
R21: 2K2; R_0603_1608Metric; Tolerance 1%; MFR.Part # 0603WAF2201T5E; JLCPCB Part # C4190
R22: 560R; R_0603_1608Metric; Tolerance 1%; MFR.Part # 0603WAF5600T5E; JLCPCB Part # C23204
R23: 0R; R_0603_1608Metric; Tolerance 1%; MFR.Part # 0603WAF0000T5E; JLCPCB Part # C21189
R25: 10K; R_0603_1608Metric; Tolerance 1%; MFR.Part # 0603WAF1002T5E; JLCPCB Part # C25804
R26, R27: 51k; R_0805_2012Metric; Tolerance ±1%; MFR.Part # 0805W8F5102T5E; JLCPCB Part # C17737
R34: 4k7; R_0805_2012Metric; Tolerance ±1%; MFR.Part # 0805W8F4701T5E; JLCPCB Part # C17673
R76, R77, R78, R79: 10R; R_0805_2012Metric; Tolerance ±1%; MFR.Part # 0603WAF100JT5E; JLCPCB Part # C22859
R90: R; R_1218_3246Metric; not fitted
R93: 18k; R_0603_1608Metric; Tolerance 1%; MFR.Part # 0603WAF1802T5E; JLCPCB Part # C25810
TH1: NCP18XH103F03RB; R_0603_1608Metric; Tolerance ±1%; JLCPCB Part # C13564

Connections:
+3.3VA: Q18.3 (E), R23.1, R93.1; also elsewhere on the board
+VSYS: Q2.3, Q4.3; also elsewhere on the board
/Project Architecture/Phase U/PhaseU_out: R20.4, R26.1; also elsewhere on the board
/Project Architecture/Phase U/phU_HS: Q2.2, Q3.3, Q4.2, Q5.3, R8.2, R18.2, R20.1, R90.1; also elsewhere on the board
/Project Architecture/Phase U/phU_HSgate1: R4.1, R6.1; also elsewhere on the board
/Project Architecture/Phase U/phU_HSgate2: R13.1, R15.1; also elsewhere on the board
/Project Architecture/Phase U/phU_I+: C99.2, R78.2, R79.2; also elsewhere on the board
/Project Architecture/Phase U/phU_I-: C99.1, R76.2, R77.2; also elsewhere on the board
/Project Architecture/Phase U/phU_LSgate1: R5.1, R7.1; also elsewhere on the board
/Project Architecture/Phase U/phU_LSgate2: R14.1, R16.1; also elsewhere on the board
/Project Architecture/Phase U/phU_NTCctrl: R21.1; also elsewhere on the board
/Project Architecture/Phase U/phU_NTCout: C48.1, R25.2; also elsewhere on the board
/Project Architecture/Phase U/phU_Shunt+: R20.2, R78.1, R79.1
/Project Architecture/Phase U/phU_Shunt-: R20.3, R76.1, R77.1
/Project Architecture/Phase U/phU_Voltage: C56.1, R27.2, R34.1; also elsewhere on the board
GND: C48.2, C56.2, C104.2, Q3.2, Q5.2, R9.2, R19.2, R34.2, TH1.2; also elsewhere on the board
unnamed: C104.1, R90.2
unnamed: D2.2 (A), Q2.1, R6.2, R8.1
unnamed: D2.1 (K), R4.2
unnamed: D3.2 (A), Q3.1, R7.2, R9.1
unnamed: D3.1 (K), R5.2
unnamed: D4.2 (A), Q4.1, R15.2, R18.1
unnamed: D4.1 (K), R13.2
unnamed: D5.2 (A), Q5.1, R16.2, R19.1
unnamed: D5.1 (K), R14.2
unnamed: Q18.2 (B), R21.2
unnamed: Q18.1 (C), R22.1, R23.2
unnamed: R22.2, R25.1, R93.2, TH1.1
unnamed: R26.2, R27.1

Notes on the sheet:
Bridge
Phase Temp
LAYOUT NOTE: Kelvin-sense at the shunt pads - dedicated sense traces off the body of the shunt, not tapped from power copper. Route phU_Shunt± as a tight differential pair.
Use manufacturer provided LUT
LAYOUT NOTE: Place inside the commutation loop, directly across each leg's HS-drain ↔ LS-source, shortest possible.
[${#}] Phase U

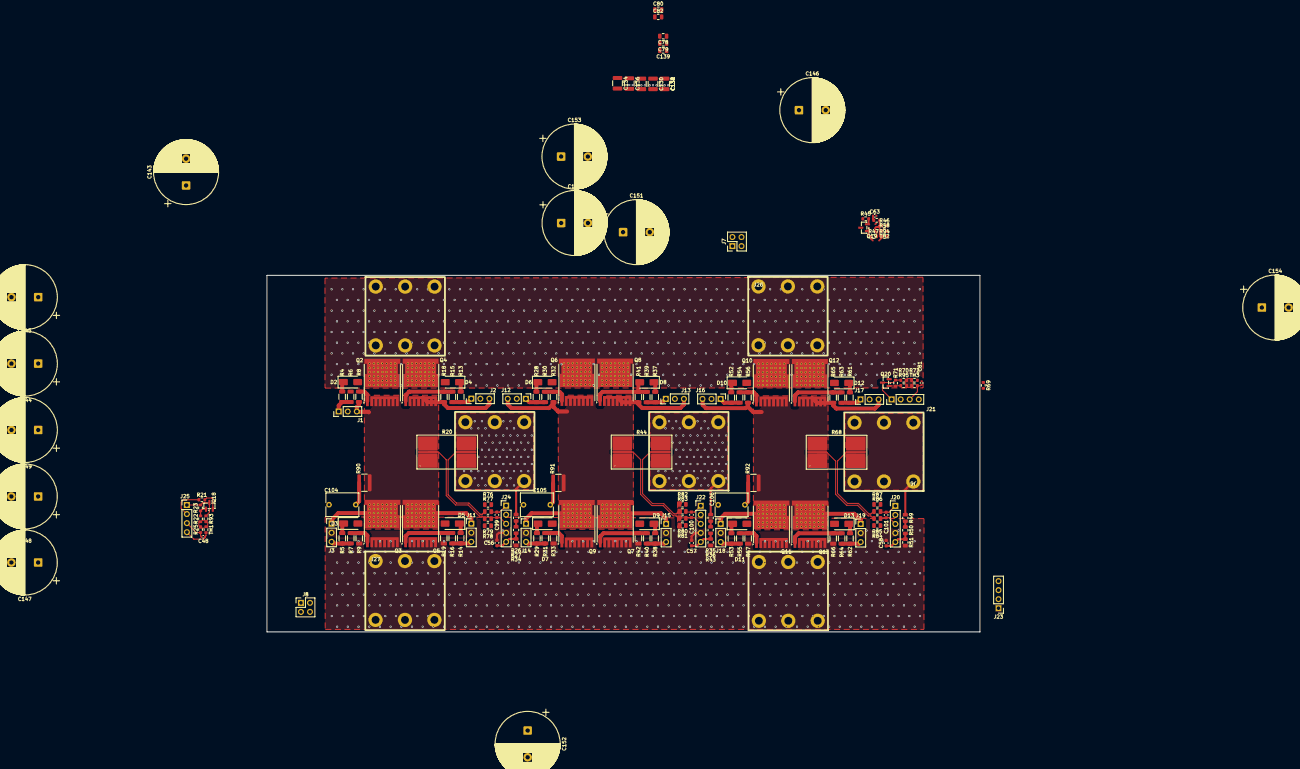
[picture p45: board PCBA-FLUX-01A.kicad_pcb from above]

Board: 2 copper layers, 200.0 x 100.0 mm, 169 parts (0 on the bottom side), 81 nets.
