bvrny/Vortex/FW-VECTOR-01B/FW-VECTOR-01B.ioc

Mcu.UserName=STM32G473VETx
PA1.GPIO_Label=ADC1Ia_comp+
PA1.Signal=SharedAnalog_PA1
PA11.Signal=USB_DM
PA12.Signal=USB_DP
PA13.Signal=SYS_JTMS-SWDIO
PA14.Signal=SYS_JTCK-SWCLK
PA15.Signal=UART4_DE
PA2.GPIO_Label=ADC1Va
PA2.Signal=ADC1_IN3
PA3.GPIO_Label=Ia_comp-
PA3.Signal=COMP2_INP
PA4.Signal=SPI1_NSS
PA5.Signal=SPI1_SCK
PA6.Signal=SPI1_MISO
PA7.Signal=SPI1_MOSI
PA8.GPIO_Label=NTC1
PA8.Signal=ADC5_IN1
PA9.GPIO_Label=NTC2
PA9.Signal=ADC5_IN2
PB0.GPIO_Label=Ib_comp-
PB0.Signal=COMP4_INP
PB11.GPIO_Label=Ic_comp-
PB11.Signal=COMP6_INP
PB13.GPIO_Label=ADC3Ic_comp+
PB13.Signal=SharedAnalog_PB13
PB15.GPIO_Label=NTC3_Ctrl
PB15.Signal=GPIO_Output
PB6.Signal=USART1_TX
PB7.Signal=USART1_RX
PC1.GPIO_Label=ADC2Ib_comp+
PC1.Signal=SharedAnalog_PC1
PC10.Signal=UART4_TX
PC11.Signal=UART4_RX
PC13.Signal=TIM1_BKIN
PC14-OSC32_IN.Signal=RCC_OSC32_IN
PC15-OSC32_OUT.Signal=RCC_OSC32_OUT
PC2.GPIO_Label=ADC2Vb
PC2.Signal=ADC2_IN8
PC3.Signal=TIM1_BKIN2
PC4.GPIO_Label=ADC2Vb
PC4.Signal=ADC2_IN5
PC6.Signal=I2C4_SCL
PC7.Signal=I2C4_SDA
PC8.GPIO_Label=NTC2_Ctrl
PC8.Signal=GPIO_Output
PC9.GPIO_Label=NTC1_Ctrl
PC9.Signal=GPIO_Output
PD0.Signal=FDCAN1_RX
PD1.Signal=FDCAN1_TX
PD10.GPIO_Label=ADC3Vc
PD10.Signal=ADC3_IN7
PD14.GPIO_Label=Vsys_comp+
PD14.Signal=SharedAnalog_PD14
PD3.Signal=S_TIM2_CH1
PD4.Signal=S_TIM2_CH2
PD7.Signal=S_TIM2_CH3
PD8.GPIO_Label=NTC3
PD8.Signal=ADC5_IN12
PD9.GPIO_Label=KTY84
PD9.Signal=ADC5_IN13
PE10.Signal=TIM1_CH2N
PE11.Signal=S_TIM1_CH2
PE12.Signal=TIM1_CH3N
PE13.Signal=S_TIM1_CH3
PE8.Signal=TIM1_CH1N
PE9.Signal=S_TIM1_CH1
PF0-OSC_IN.Signal=RCC_OSC_IN
PF1-OSC_OUT.Signal=RCC_OSC_OUT
PF9.Signal=S_TIM15_CH1
