bvrny/Vortex/(commit log)

2026-06-22 Finished inverter design and started working on MCU pin out
    [BlockDiagram.kicad_sch, Bvrny's_template.kicad_sch, Comms.kicad_sch, MCU.kicad_sch, PCBA-FLUX-01A.kicad_sch, PCBA-VECTOR-01A.kicad_pcb, PCBA-VECTOR-01A.kicad_sch, PhaseA.kicad_sch]
2026-07-04 Changes were made
    [BlockDiagram.kicad_sch, Comms.kicad_sch, MCU.kicad_sch, MotorOutput.kicad_sch, PCBA-FLUX-01A.kicad_sch, PCBA-VECTOR-01A.kicad_sch, PhaseU.kicad_sch, PhaseV.kicad_sch]
2026-07-16 Finished schematic?
    [BlockDiagram.kicad_sch, PCBA-FLUX-01A.kicad_sch, PhaseU.kicad_sch, PhaseV.kicad_sch, PhaseW.kicad_sch, Power Input.kicad_sch, ProjectArchitecture.kicad_sch, RevisionHistory.kicad_sch]
2026-07-17 feat: add USB protocol layer, device simulator, and desktop control app
    - PROTO-VORTEX-01A: protocol.yaml single source of truth, codegen for
    C header + Python bindings (COBS + CRC16-CCITT-FALSE), PROTOCOL.md,
    cross-language golden-vector tests
    - APP-VORTEX/simulator: protocol-compliant device simulator with PTY
    transport for virtual serial port testing
    - APP-VORTEX/vortex_app: PySide6 GUI with DeviceLink client, telemetry
    ring buffers, live pyqtgraph plots, parameter tree, fault handling
    - 96 Python tests + C protocol test suite passing
    [__main__.py, device.py, link.py, main.py, rings.py]
2026-07-17 feat: add host-testable firmware App modules (FW-VECTOR-01B)
    Phase 4: protocol-facing firmware logic built and tested on the host
    (cmake/gcc) before target integration:
    - vx_device: command handler + state machine per PROTOCOL.md, matching
    the SimDevice reference (param access, arm/disarm/stop, setpoint,
    faults, scope, heartbeat watchdog trip)
    - vx_param_store: VP_PARAMS-backed table with bounds/RO enforcement and
    CRC'd NV blob
    - vx_nv_store: ping-pong two-slot flash store, header-written-last for
    power-loss safety, mockable flash ops
    - vx_protection: OCP/OVP comparator DAC scaling with reject-not-clamp
    backstop (150 A -> code 2979)
    - vx_motor_id: R/L/flux identification math, PI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
2026-07-17 docs: add Phase 5 packaging, udev rule, READMEs, HIL bring-up checklist
    - APP-VORTEX/packaging: PyInstaller build scripts (Linux onedir,
    Windows onefile) with vortex_protocol bundled; 99-vortex.rules for
    unprivileged CDC access
    - Per-package READMEs (protocol, app+simulator with CI matrix, firmware
    App modules with target integration notes)
    - DOCS-VORTEX-01A/BringUpChecklist.md: staged HIL commissioning
    checklist (Vector alone -> +Flux -> +motor -> power envelope)
2026-07-17 feat: in-place editable parameter panel with dirty state and profiles (GUI Phase 2)
    ParamPanel: metadata-driven delegates (bounded spinboxes, enum combos),
    unsaved-to-flash highlight on Save button, differs-from-default accent,
    filter box, JSON profiles with diff preview. Replaces QInputDialog editing.
    51 tests green.
    [main.py]
2026-07-17 feat: channel selector, unit-grouped plots, stat tiles, CSV recording (GUI Phase 3)
    ChannelPanel drives the device telemetry mask (stream only what's shown),
    LivePlots groups rows by unit with pause/legend, StatTiles dashboard,
    CsvLogger for offline analysis. Legend hide/unhide inside plots is gone.
    56 tests green.
2026-07-17 test: add Phase 4 tuning tests (scope helpers, bandwidth knob, motor-ID) [RED]
2026-07-17 feat: scope capture, step response, bandwidth knob, motor-ID wizard (GUI Phase 4)
    DeviceLink scope helpers (chunked SCOPE_READ reassembly), ScopePanel with
    step-response workflow + CSV export, one-knob bandwidth tuning (kp=L*w,
    ki=R*w from identified R/L), guided MotorIdWizard replaces the bare toolbar
    button. 62 tests green.
    [link.py, main.py]
2026-07-17 feat: protocol console with history, event log, dfu command (GUI Phase 5)
    ConsoleLogic (help/arm/stop/sp/param/fault/hb/dfu), up-down command
    history, timestamped event log of state/fault changes fed by heartbeat.
    71 tests green.
2026-07-17 test: reproduce u32 spinbox crash; spec side-pane params, direction + arrow-key drive [RED]
    test_drive_controls.py aborts (SIGABRT 134) on QSpinBox overflow for
    telem.default_mask - same crash as reported from live run.
    [test_drive_controls.py, test_ui_foundation.py]
2026-07-17 fix: u32 param editor crash; params side pane; direction + arrow-key drive
    - ParamDelegate: u32-range params (telem.default_mask) get a 0-decimal
    double spinbox instead of overflowing the signed QSpinBox (libshiboken
    SIGABRT reproduced in test, now green); integer coercion on write
    - Layout: parameter panel is a permanent splitter pane next to the
    waveform tabs - tune while watching (Parameters tab removed)
    - Toolbar: FWD/REV direction combo (signs the setpoint), keyboard drive
    toggle: Up/Down nudge setpoint, Left/Right flip direction, Space STOP
    77 tests green.
    [main.py]
2026-07-17 feat: polar dq vector view; always-open single-click param editors
    - PolarDQ on the Dashboard: live current + voltage vectors on the d-q
    plane (unit-circle grid, running-peak normalization, magnitude/angle
    labels); vd/vq added to the default telemetry mask
    - Parameter fields are persistent editors now: spin arrows always
    visible, single click to focus, type directly - no double-click.
    Focus-out of an untouched field no longer writes back a
    decimals-rounded value (tolerance guard)
    81 tests green.
    [main.py]
2026-07-30 Started with Flux layout
    [PCBA-FLUX-01A.kicad_pcb, PhaseV.kicad_sch, ProjectArchitecture.kicad_sch]
2026-07-31 Moved the current and voltage sensing OpAmp's to Vector
    [AnalogFrontend.kicad_sch, PCBA-FLUX-01A.kicad_pcb, PhaseU.kicad_sch, PhaseV.kicad_sch, PhaseW.kicad_sch, ProjectArchitecture.kicad_sch]
2026-08-06 Changed Flux layout so be top to bottom
    [PCBA-FLUX-01A.kicad_pcb]
2026-08-06 More routing on FLux
    [BlockDiagram.kicad_sch, GateDrivers.kicad_sch, PCBA-FLUX-01A.kicad_pcb, PCBA-FLUX-01A.kicad_sch, PhaseU.kicad_sch, PhaseV.kicad_sch, PhaseW.kicad_sch, ProjectArchitecture.kicad_sch]
2026-09-30 Changing PC
    [BlockDiagram.kicad_sch, PCBA-FLUX-01A.kicad_pcb, PCBA-FLUX-01A.kicad_sch, PhaseU.kicad_sch, PhaseV.kicad_sch, PhaseW.kicad_sch, Power Input.kicad_sch, ProjectArchitecture.kicad_sch]
